Legohead259/Thetis-CAD/ECAD/Rev D1/Thetis_RevD1_BOM.pdf

Item | Manufactor Part Number Supplier Part Number | Reference Value | Package | Price | Qty Used Component Price Location Datasheet Notes
Micro button | KMR221GLFS | 401-1427-1-ND | SW1 | | SMD | $ 0.48 | 1 $ | 0.48 https://www.digikey.com/en/products/detail/c-k/KMR221GLFS/550472?s=N4IgTCBcDaINYFsBOYwEYDmAbAZgZxAF0BfIA https://www.ckswitches.com/media/1479/kmr2.pdf SPST-NO
Micro SD card receptacle DM3D-SF | HR1941CT-ND | J1 | SMD | $ 1.65 | 1 $ | 1.65 https://www.digikey.com/en/products/detail/hirose-electric-co-ltd/DM3D-SF/1786510 https://www.hirose.com/product/document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 CS is grounded
Micro USB receptacle | 10118192-0001LF | 609-4613-1-ND | J2 | | SMD | $ 0.42 | 1 $ | 0.42 https://www.digikey.com/product-detail/en/amphenol-icc-fci/10118192-0001LF/609-4613-1-ND/2785378 https://cdn.amphenol-icc.com/media/wysiwyg/files/documentation/datasheet/inputoutput/io_usb_micro.pdf
ESP8266 Module | ESP-12S | ESP-12SRF-ND | U1 | | SOM | $ 9.43 | 1 $ | 9.43 https://www.digikey.com/en/products/detail/rf-solutions/ESP-12S/9555694?s=N4IgTCBcDaIKYGcAOBGMBaBIC6BfIA https://www.rfsolutions.co.uk/downloads/1605713877DS-ESP12S-1.pdf Application note: run in STA mode to enable MODEM_SLEEP and conserve power
3V3 voltage regulator | AZ1117H-3.3TRE1 | AZ1117H-3.3TRE1DICT-ND | U2 | SOT-223 $ 0.46 | 1 $ | 0.46 https://www.digikey.com/en/products/detail/diodes-incorporated/AZ1117H-3-3TRE1/4471000 https://media.digikey.com/pdf/Data%20Sheets/Diodes%20PDFs/AZ1117_Rev5.3_Jan2019_DS.pdf 3.3V fixed output, 1A max
USB-UART Converter | CP2104-F03-GMR | 336-4146-1-ND | U3 | | 24QFN | $ 1.65 | 1 $ | 1.65 https://www.digikey.com/en/products/detail/silicon-labs/CP2104-F03-GMR/4069045 https://www.silabs.com/documents/public/data-sheets/cp2104.pdf
BNO055 Breakout | 2472 | 1528-1426-ND | U4 | | SMD | $ 19.95 | 1 $ | 19.95 https://www.adafruit.com/product/4646 https://learn.adafruit.com/adafruit-bno055-absolute-orientation-sensor Breakout board is THT but should be solderable to SMD pads
LIR2450 Battery Holder | BS-2450 | BS-2450-ND | BT1 | | THT | $ 1.09 | 1 $ | 1.09 https://www.digikey.com/en/products/detail/mpd-memory-protection-devices/BS-2450/2439475 http://www.memoryprotectiondevices.com/datasheets/BS-2450-datasheet.pdf Only use rechargable LIR2450 cells! Undervolt otherwise
N-Channel MOSFET | DMG3414U-7 | DMG3414U-7DICT-ND | Q1 | SOT-23-3 $ 0.44 | 1 $ | 0.44 https://www.digikey.com/en/products/detail/diodes-incorporated/DMG3414U-7/2183247 https://www.diodes.com/assets/Datasheets/ds31739.pdf
NPN transistor array | MBT2222ADW1T1G | MBT2222ADW1T1GOSCT-ND Q2, Q3, Q4 | SOT-363 $ 0.22 | 3 $ | 0.66 https://www.digikey.com/en/products/detail/on-semiconductor/MBT2222ADW1T1G/1477281 http://www.onsemi.com/pub/Collateral/MBT2222ADW1T1-D.PDF 2 NPN transistors
LED | SML-D12P8WT86C | SML-D12P8WT86CCT-ND | D1, D2, D3 GRN | 0603 | $ 0.48 | 3 $ | 1.44 https://www.digikey.com/product-detail/en/rohm-semiconductor/SML-D12P8WT86C/SML-D12P8WT86CCT-ND/9090464 https://www.rohm.com/datasheet/SML-D12P8W(C)/sml-d12x8(c)-e 2.2Vf
Schottky diode | BAT400D-7-F | BAT400D-FDICT-ND | D4 | SOT-23-3 $ 0.44 | 1 $ | 0.44 https://www.digikey.com/product-detail/en/diodes-incorporated/BAT400D-7-F/BAT400D-FDICT-ND/725055 https://www.diodes.com/assets/Datasheets/ds30182.pdf 40V, 500mA
Resistor | ESR03EZPJ102 | RHM1.0KDCT-ND | R2 | 1k | 0603 | $ 0.10 | 1 $ | 0.10 https://www.digikey.com/product-detail/en/rohm-semiconductor/ESR03EZPJ102/RHM1.0KDCT-ND/1762924 https://www.rohm.com/datasheet/ESR01MZPF/esr-e 0.25W
Resistor | RNCP0603FTD10K0 | RNCP0603FTD10K0CT-ND | R1, R3 | 10k | 0603 | $ 0.10 | 2 $ | 0.20 https://www.digikey.com/product-detail/en/stackpole-electronics-inc/RNCP0603FTD10K0/RNCP0603FTD10K0CT-ND/2240478 https://www.seielect.com/catalog/sei-rncp.pdf 0.125W
Resistor array | 741X083102JP | 741X083102JPCT-ND | RN2, RN3 1k | 0804 | $ 0.10 | 2 $ | 0.20 https://www.digikey.com/en/products/detail/cts-resistor-products/741X083102JP/1124443 https://www.ctscorp.com/wp-content/uploads/74x.pdf 4 resistors, 0.0625W
Resistor array | EXB-28V103JX | Y7103CT-ND | RN1, RN4 10k | 0804 | $ 0.10 | 2 $ | 0.20 https://www.digikey.com/product-detail/en/panasonic-electronic-components/EXB-28V103JX/Y7103CT-ND/256360 https://industrial.panasonic.com/cdbs/www-data/pdf/AOC0000/AOC0000C14.pdf 4 resistors, 0.0625W
Capacitor | 885012206026 | 732-7945-1-ND | C1, C2 | 1 uF | 0603 | $ 0.10 | 2 $ | 0.20 https://www.digikey.com/product-detail/en/wurth-electronics-inc/885012206026/732-7945-1-ND/5454572 10V X7R
Capacitor | ZRB18AR61E106ME01L | 490-10991-1-ND | C3, C4 | 10 uF | 0603 | $ 0.48 | 2 $ | 0.96 https://www.digikey.com/product-detail/en/murata-electronics-north-america/ZRB18AR61E106ME01L/490-10991-1-ND/5321192 https://search.murata.co.jp/Ceramy/image/img/A01X/G101/ENG/ZRB18AR61E106ME01-01.pdf 25V X5R
SD Card | | | | | | $ 4.00 | 1 $ | 4.00 https://www.amazon.com/10-PACK-SanDisk-SDSDQAB-008G-Packaging/dp/B00MHZ70KO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 8GB, sold in bulk pack of 10
PCB | | | | | | $ 0.40 | 1 $ | 0.40
Total | | | | | | | $ | 44.37
