Legohead259/Thetis-CAD/ECAD/Rev F1/Thetis_RevF1_BOM.pdf

Item | Manufactor Part Number | Supplier | Supplier Part Number | Reference | Value | Package | Price | Qty Used | Component Price | Location | Datasheet | Notes
Capacitor | 885012206026 | Digikey | 732-7945-1-ND | C1, C2, C7-C11 | 1 uF | 0603 | $ 0.10 | 7 $ | 0.70 https://www.digikey.com/product-detail/en/wurth-electronics-inc/885012206026/732-7945-1-ND/5454572 10V X7R
Capacitor | ZRB18AR61E106ME01L | Digikey | 490-10991-1-ND | C3-C5 | 10 uF | 0603 | $ 0.48 | 3 $ | 1.44 https://www.digikey.com/product-detail/en/murata-electronics-north-america/ZRB18AR61E106ME01L/490-10991-1-ND/5321192 https://search.murata.co.jp/Ceramy/image/img/A01X/G101/ENG/ZRB18AR61E106ME01-01.pdf 25V X5R
LED | SML-D12P8WT86C | Digikey | SML-D12P8WT86CCT-ND | D1, D2, D3, D8 | GRN | 0603 | $ 0.48 | 4 $ | 1.92 https://www.digikey.com/product-detail/en/rohm-semiconductor/SML-D12P8WT86C/SML-D12P8WT86CCT-ND/9090464 https://www.rohm.com/datasheet/SML-D12P8W(C)/sml-d12x8(c)-e 2.2Vf
Schottky diode | BAT400D-7-F | Digikey | BAT400D-FDICT-ND | D4 | SOT-23-3 | $ 0.44 | 1 $ | 0.44 https://www.digikey.com/product-detail/en/diodes-incorporated/BAT400D-7-F/BAT400D-FDICT-ND/725055 https://www.diodes.com/assets/Datasheets/ds30182.pdf 40V, 500mA
LED | ASMT-RA45-AP932 | Digikey | 516-3217-1-ND | D5 | AMBR | 0603 | $ 0.33 | 1 $ | 0.33 https://www.digikey.com/product-detail/en/broadcom-limited/ASMT-RA45-AP932/516-3217-1-ND/5277725 https://docs.broadcom.com/docs/AV02-0378EN 2Vf
LED | SML-D12U1WT86 | Digikey | SML-D12U1WT86CT-ND | D6, D7 | RED | 0603 | $ 0.20 | 2 $ | 0.40 https://www.digikey.com/product-detail/en/rohm-semiconductor/SML-D12U1WT86/SML-D12U1WT86CT-ND/5843858 https://www.rohm.com/datasheet/SML-D12U1W 2.2Vf
Micro SD card receptacle DM3AT-SF-PEJM5 | Digikey | HR1964CT-ND | J1 | SMD | $ 2.50 | 1 $ | 2.50 https://www.digikey.com/en/products/detail/hirose-electric-co-ltd/DM3AT-SF-PEJM5/2533565 https://www.hirose.com/product/document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 Push-Push with ejection mechanism
Micro USB receptacle | 10118192-0001LF | Digikey | 609-4613-1-ND | J2 | SMD | $ 0.42 | 1 $ | 0.42 https://www.digikey.com/product-detail/en/amphenol-icc-fci/10118192-0001LF/609-4613-1-ND/2785378 https://cdn.amphenol-icc.com/media/wysiwyg/files/documentation/datasheet/inputoutput/io_usb_micro.pdf
N-Channel MOSFET | DMG3414U-7 | Digikey | DMG3414U-7DICT-ND | Q1 | SOT-23-3 | $ 0.44 | 1 $ | 0.44 https://www.digikey.com/en/products/detail/diodes-incorporated/DMG3414U-7/2183247 https://www.diodes.com/assets/Datasheets/ds31739.pdf
NPN transistor array | MBT2222ADW1T1G | Digikey | MBT2222ADW1T1GOSCT-ND | Q2 | SOT-363 | $ 0.22 | 3 $ | 0.66 https://www.digikey.com/en/products/detail/on-semiconductor/MBT2222ADW1T1G/1477281 http://www.onsemi.com/pub/Collateral/MBT2222ADW1T1-D.PDF 2 NPN transistors
Resistor | RNCP0603FTD10K0 | Digikey | RNCP0603FTD10K0CT-ND | R1, R5-R10, R18, R19 | 10 kΩ | 0603 | $ 0.10 | 8 $ | 0.80 https://www.digikey.com/product-detail/en/stackpole-electronics-inc/RNCP0603FTD10K0/RNCP0603FTD10K0CT-ND/2240478 https://www.seielect.com/catalog/sei-rncp.pdf 0.125W
Resistor | ESR03EZPJ102 | Digikey | RHM1.0KDCT-ND | R2, R3, R4, R11, R12, R20, R21 1 kΩ | 0603 | $ 0.10 | 7 $ | 0.70 https://www.digikey.com/product-detail/en/rohm-semiconductor/ESR03EZPJ102/RHM1.0KDCT-ND/1762924 https://www.rohm.com/datasheet/ESR01MZPF/esr-e 0.25W
Resistor | CRCW060322K1FKEAC | Digikey | 541-5271-1-ND | R26 | 22.1 kΩ 0603 | $ 0.10 | 1 $ | 0.10 https://www.digikey.com/en/products/detail/vishay-dale/CRCW060322K1FKEAC/7924045 https://www.vishay.com/docs/28773/crcwce3.pdf 0.1W; 1%
Resistor | RT0603DRE0747K5L | Digikey | RT0603DRE0747K5L | R27 | 47.5 kΩ 0603 | $ 0.10 | 1 $ | 0.10 https://www.digikey.com/en/products/detail/yageo/RT0603DRE0747K5L/1074875 https://www.yageo.com/upload/media/product/productsearch/datasheet/rchip/PYu-RT_1-to-0.01_RoHS_L_12.pdf 0.1W; 0.5%
Micro button | KMR221GLFS | Digikey | 401-1427-1-ND | S1, S2, S4 | SMD | $ 0.48 | 3 $ | 1.44 https://www.digikey.com/en/products/detail/c-k/KMR221GLFS/550472?s=N4IgTCBcDaINYFsBOYwEYDmAbAZgZxAF0BfIA https://www.ckswitches.com/media/1479/kmr2.pdf SPST-NO
Slide switch | JS202011JCQN | Digikey | S3 | SMD | $ 0.55 | 1 $ | 0.55 | DPDT
ESP32-WROOM Module ESP32-WROOM-32E (16MB) Digikey | 1965-ESP32-WROOM-32E(16MB)CT-ND U1 | 38-SMD | $ 2.99 | 1 $ | 2.99 https://www.digikey.com/en/products/detail/espressif-systems/ESP32-WROOM-32E-16MB/11613144 https://www.espressif.com/sites/default/files/documentation/esp32-wroom-32e_esp32-wroom-32ue_datasheet_en.pdf 16 MB memory, could be used as alternate filesystem
3V3 voltage regulator | AZ1117H-3.3TRE1 | Digikey | AZ1117H-3.3TRE1DICT-ND | U2 | SOT-223 | $ 0.46 | 1 $ | 0.46 https://www.digikey.com/en/products/detail/diodes-incorporated/AZ1117H-3-3TRE1/4471000 https://media.digikey.com/pdf/Data%20Sheets/Diodes%20PDFs/AZ1117_Rev5.3_Jan2019_DS.pdf 3.3V fixed output, 1A max
USB-UART Bridge | CP2102N-A02-GQFN24R | Digikey | 336-5888-1-ND | U3 | 24 QFN | $ 1.35 | 1 $ | 1.35 https://www.digikey.com/en/products/detail/silicon-labs/CP2102N-A02-GQFN24R/9863479 https://www.silabs.com/documents/public/data-sheets/cp2102n-datasheet.pdf USB2.0; uART up to 3Mb baud rate
BNO055 Breakout | 2472 | Digikey | 1528-1426-ND | U4 | SMD | $ 19.95 | 1 $ | 19.95 https://www.adafruit.com/product/4646 https://learn.adafruit.com/adafruit-bno055-absolute-orientation-sensor Breakout board is THT but solderable to SMD pads
LiPoly Battery Charger | MCP73831T-2ACI/OT | Digikey | MCP73831T-2ACI/OTCT-ND | U5 | SOT-23-5 | $ 0.56 | 1 $ | 0.56 https://www.digikey.com/en/products/detail/microchip-technology/MCP73831T-2ACI-OT/964301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 http://www.microchip.com/mymicrochip/filehandler.aspx?ddocname=en025112 Used in all Adafruit LiPoly charging circuits
GPS radio | FGPMMOPA6H | Adafruit | 790 | U6 | 20-SMD | $ 29.95 | 1 $ | 29.95 https://www.adafruit.com/product/790 https://cdn-shop.adafruit.com/datasheets/GlobalTop-FGPMMOPA6H-Datasheet-V0A.pdf 10Hz refresh rate
SD Card | Amazon | $ 4.00 | 1 $ | 4.00 https://www.amazon.com/10-PACK-SanDisk-SDSDQAB-008G-Packaging/dp/B00MHZ70KO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 8GB, sold in bulk pack of 10
PCB | JLCPCB | $ 0.40 | 1 $ | 0.40 | Sold in packs of 5 @ $2.00; Black solder mask?
Total | $ | 72.60
