Legohead259/Thetis-CAD/MCAD/Print Files/EnclosureTest.stl

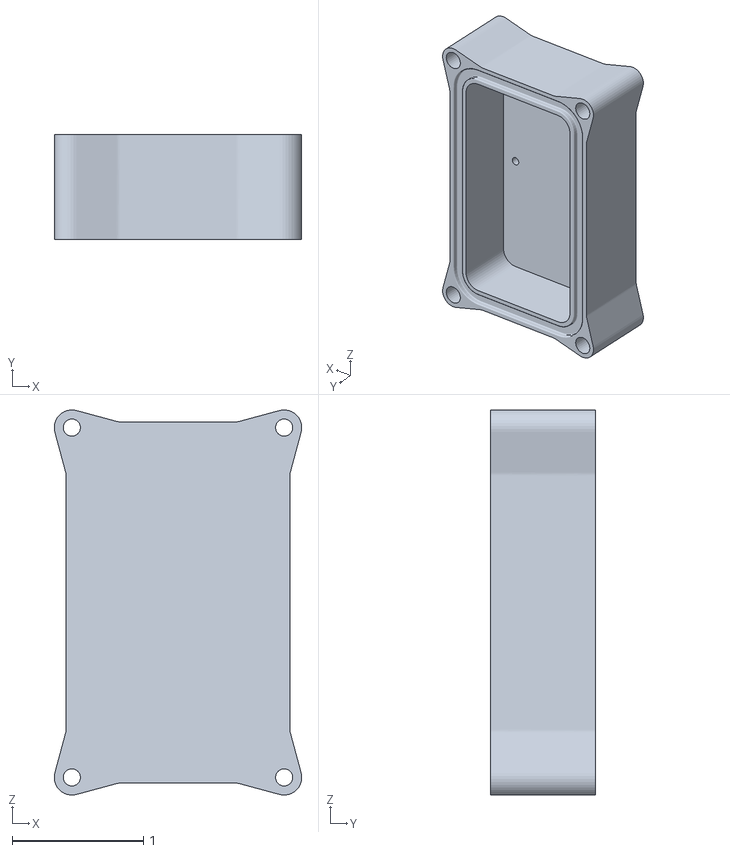
[picture p1: CAD file, 2022-02-04]
MCAD/Print Files/EnclosureTest.stl
1.89 x 0.8 x 2.94
