Legohead259/Thetis-CAD/(threads)

Thread 1 (2022-07-14):

Hardware Revision F5 Proposed Changelog

Legohead259, 2022-07-14:
Changes that need to be made to the Revision F5 of the Thetis instrumentation package
- [x] Add magnetometer ([LIS3MDL](https://www.digikey.com/en/products/detail/stmicroelectronics/LIS3MDLTR/4309733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))
- [x] Move the SD_CS line to a different pin
- [x] Connect the log enable button to the microcontroller
- [x] Make NeoPixel current-limiting resistor larger (1-2k)
- [x] Change SD card slot to [DM3D](https://www.digikey.com/en/products/detail/hirose-electric-co-ltd/DM3D-SF/1786510)
- [x] Switch the microcontroller to the [ESP32-S2-SOLO-U](https://www.digikey.com/en/products/detail/espressif-systems/ESP32-S2-SOLO-U-N4/15222549)
- [x] Add test pads for RST, LOG_EN, BOOT
- [x] Remove XTSD IC
- [x] Move silkscreen to `tPlace` layer for rendering on the 3D model

Closed 2023-01-13.

Thread 2 (2022-08-02):

Hardware Revision G1 Proposed Changelog

Legohead259, 2022-08-02:
Proposed changes from Rev F4
- [x] Add SMA connector for GPS antenna
- [x] Add SMA connector for WiFi antenna
- [x] Make PCB fit into [Hammond 1554 enclosure](https://www.digikey.com/en/products/detail/hammond-manufacturing/1554C2GYCL/2359954)
- [x] Add CANbus interfaces
    - [x] TWAI controller from ESP32-S2
    - [x] Backup MCP2515 controller
    - [x] DIP switch for dual or redundant CAN modes
    - [x] DIP switch to enable termination for CAN0 and CAN1
- [x] External JST connectors for M12 bulkhead connectors
    - [x] CAN (x2)
    - [x] USB
    - [x] UART
- [x] Primary power from M12 connectors (12-24V)
    - [x] DIP switch to enable/disable external power
    - [x] Convert to 5V to integrate with USB power input

Legohead259, 2022-10-27:
Completed

Closed 2022-10-27.

Thread 3 (2022-08-02):

Clean Up and Better Document This repo

Legohead259, 2022-08-02:
Need to clean this up and make it a bit easier to use
- [ ] Publish official versions as releases (Schematic and PCB source, Schematic PDF, Gerber files zip, related docs)
     - [ ] Rev F1
     - [ ] Rev F2
     - [ ] Rev F3
     - [ ] Rev F4
- [ ] Make milestones
     - [ ] Rev F5
     - [ ] Rev G1
- [ ] Make branches
     - [ ] Rev F5
     - [ ] Rev G1
- [ ] Make Issue Templates
     - [ ] Bug
     - [ ] Feature Tracking

Thread 4 (2022-10-26):

Diode D4 burns up when powered on

Legohead259, 2022-10-26:
Diode D4 burns up whenever USB power is connected and the switch is turned to "On". The component gets extremely hot suggesting a short between the USB power rail and ground. However, on inspection, there is a 100k resistance between USB power and GND - as expected. Perhaps the MOSFETS are shorting or doing something else?

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

Legohead259, 2022-10-26:
When MOSFET Q2 is removed, the issue disappears. This suggests a short through the 3V3 regulator. This design is using a new regulator - perhaps it is bad?

Legohead259, 2022-10-26:
Replaced 3V3 regulator and MOSFET Q2, issue still exists. Have verified all part numbers on assembled board.

Legohead259, 2022-10-26:
ISSUE FOUND! There exists a short between the 3V3 output and GND. Tracked down the short to the THT pins on the USB-C connector and GND as well as some of the external connectors.

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

The teal copper layer is the 3V3 plane on the board. Purple is the GND plane. The THT components do not have a proper keepout zone around them for these internal planes and thus, the copper is allowed to extend into the plated areas of these holes, creating a short. Thanks to Andrew Loomis for the helpful insight!

Will be fixed in Rev G2

Closed 2022-10-26.

Thread 6 (2022-10-27):

Hardware Revision G2 Proposed Changelog

Legohead259, 2022-10-27:
Proposed changes from Rev G1
- [x] Remove 3V3 and GND plane material from THT connectors
- [x] Clean up schematic
- [x] Move silkscreen to `tPlace` layer on board file

Closed 2023-01-13.
