Legohead259/Thetis-CAD/Documentation/Schematics/Thetis_RevD1_SCH.pdf

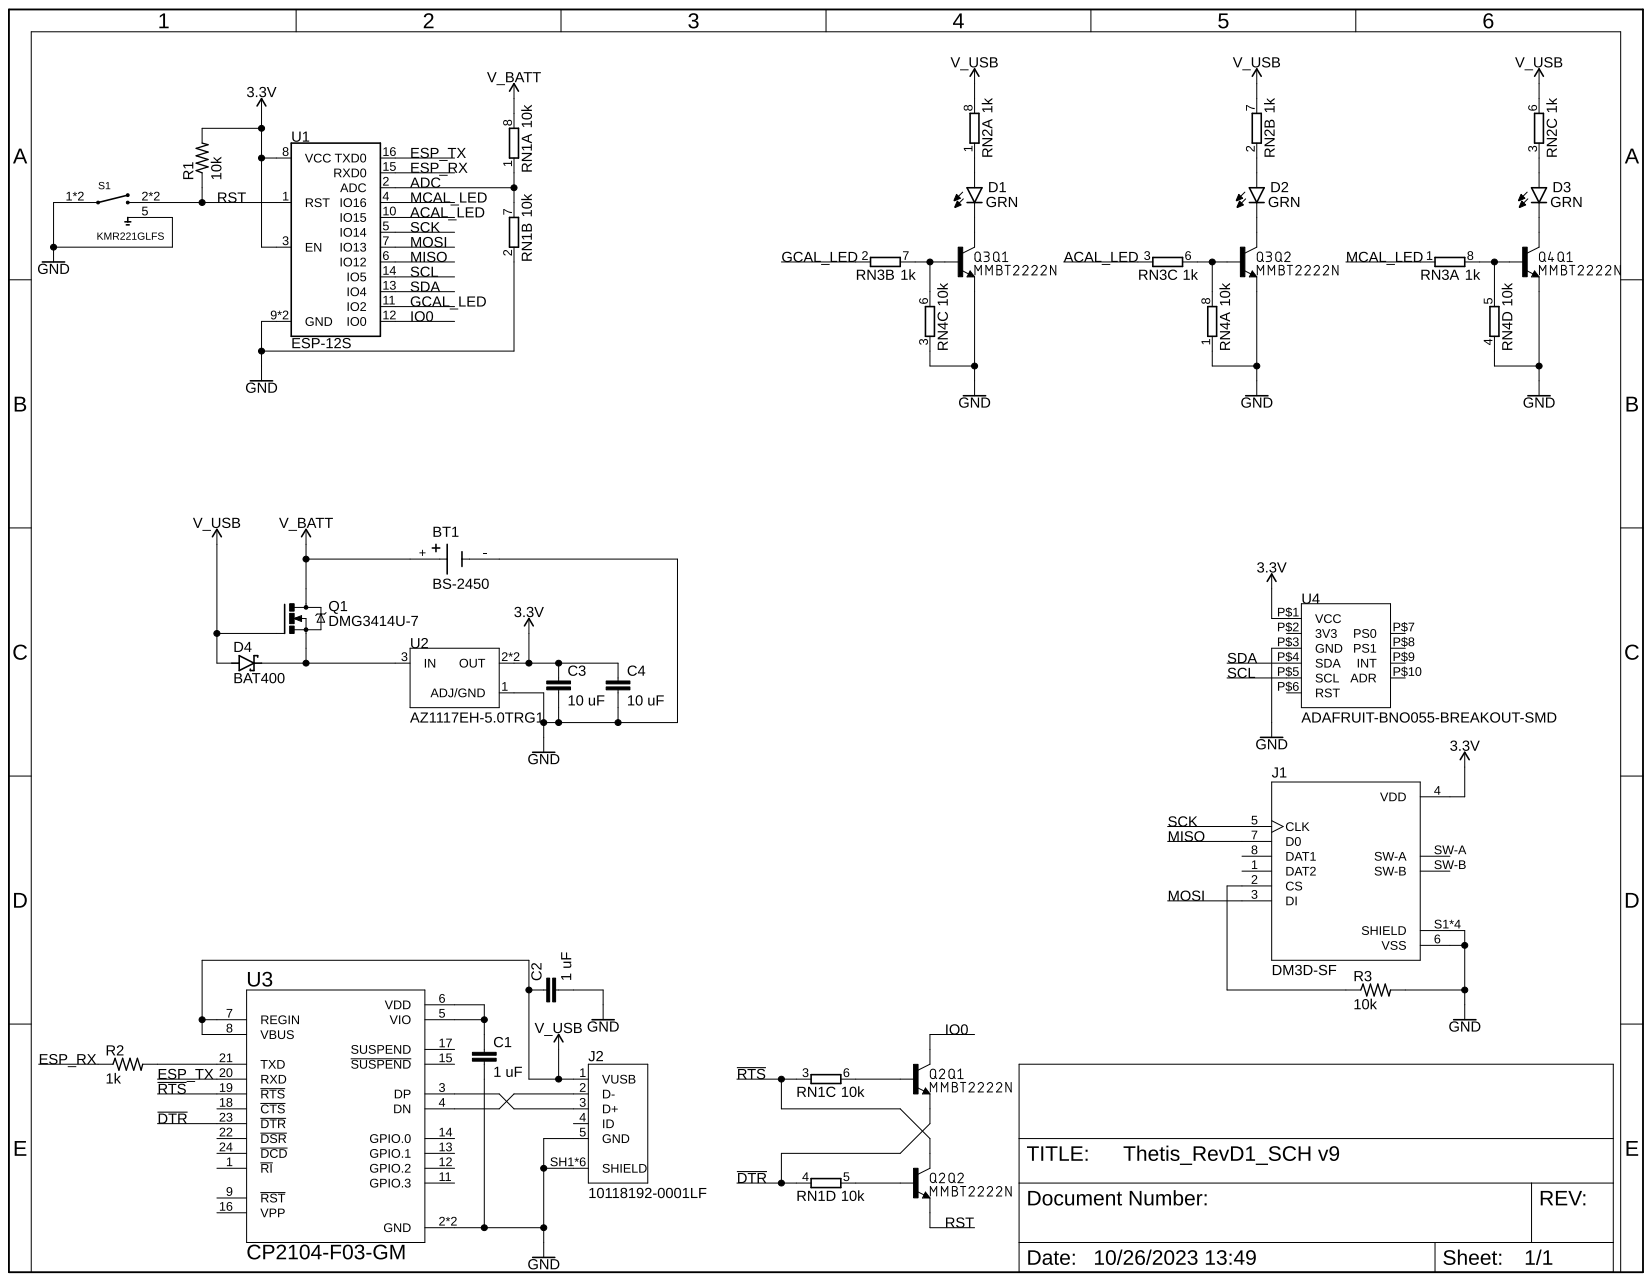
[picture p2: page 1]
