Legohead259/Thetis-CAD/Documentation/Schematics/Thetis_RevD2_SCH.pdf

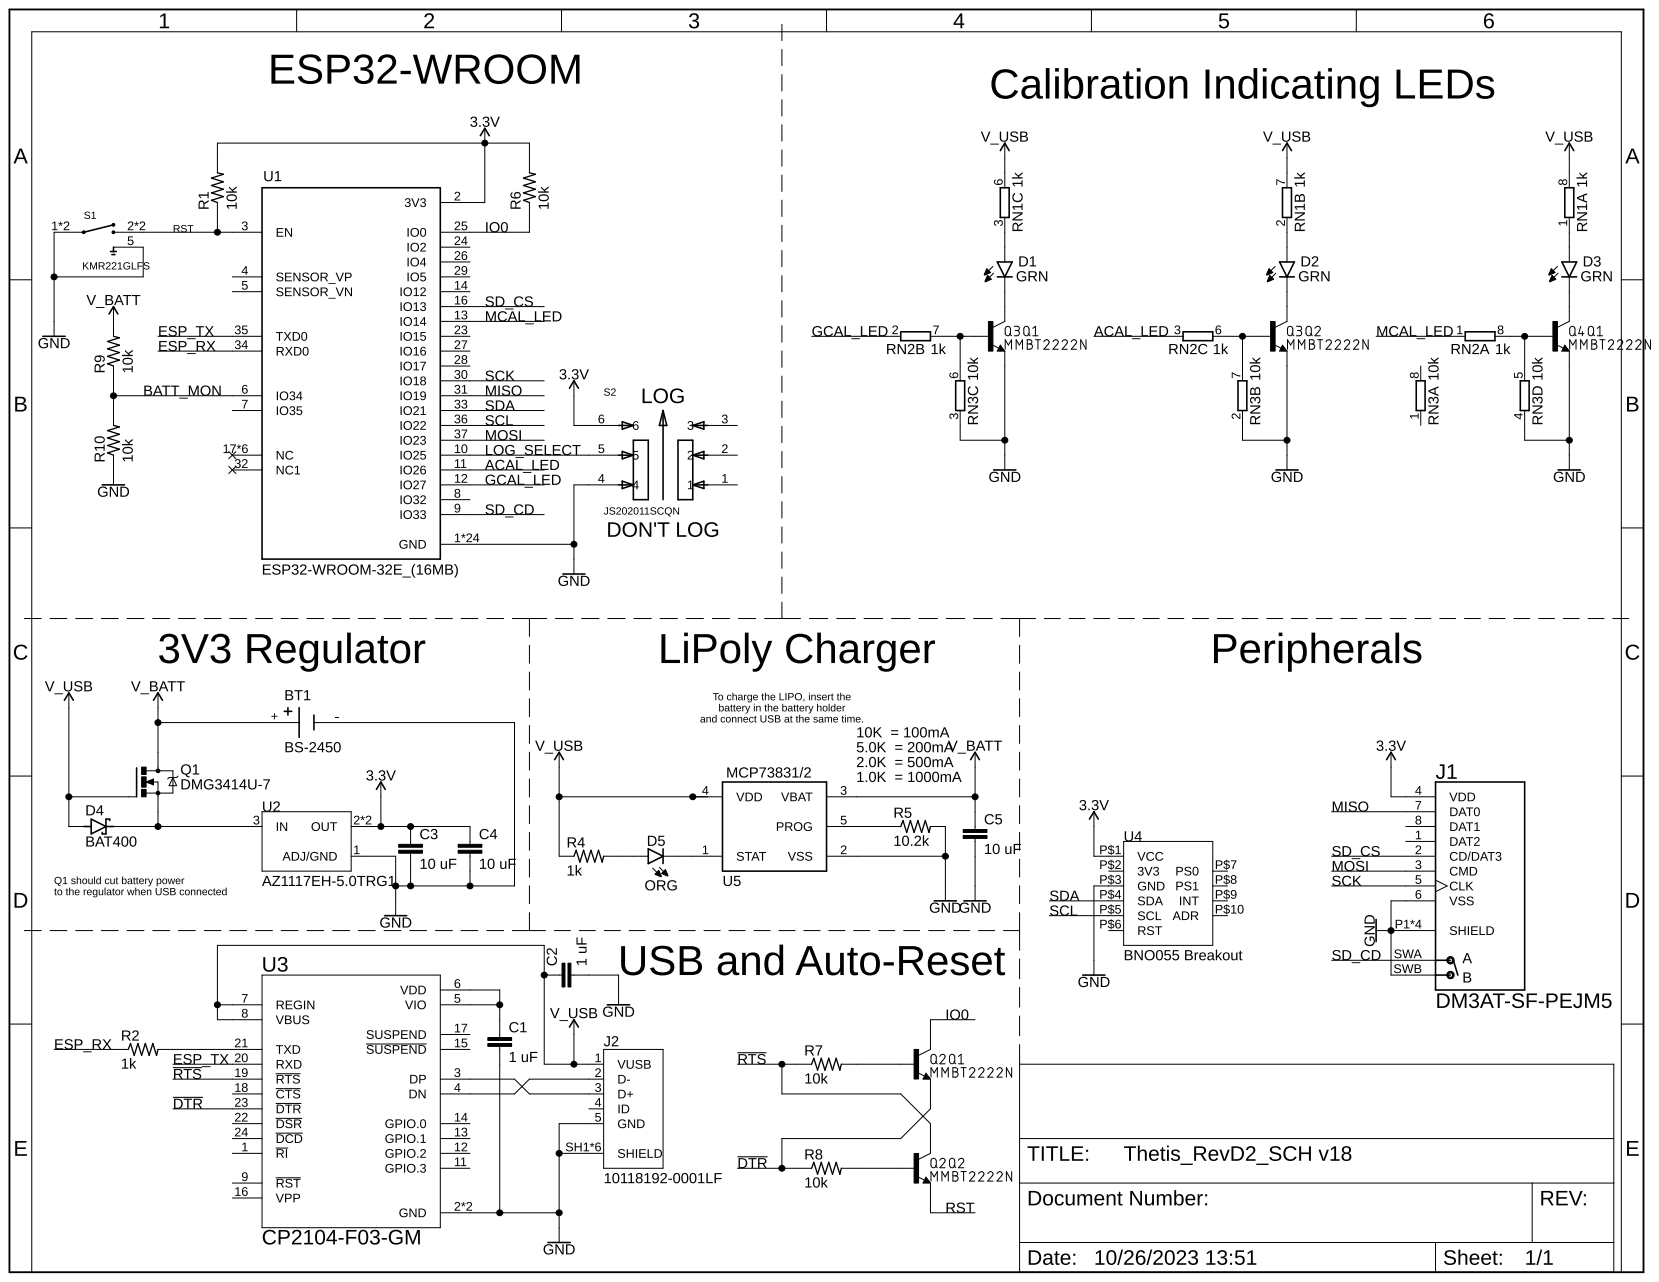
[picture p3: page 1]
