Legohead259/Thetis-CAD/Documentation/Schematics/Thetis_RevE1_SCH.pdf

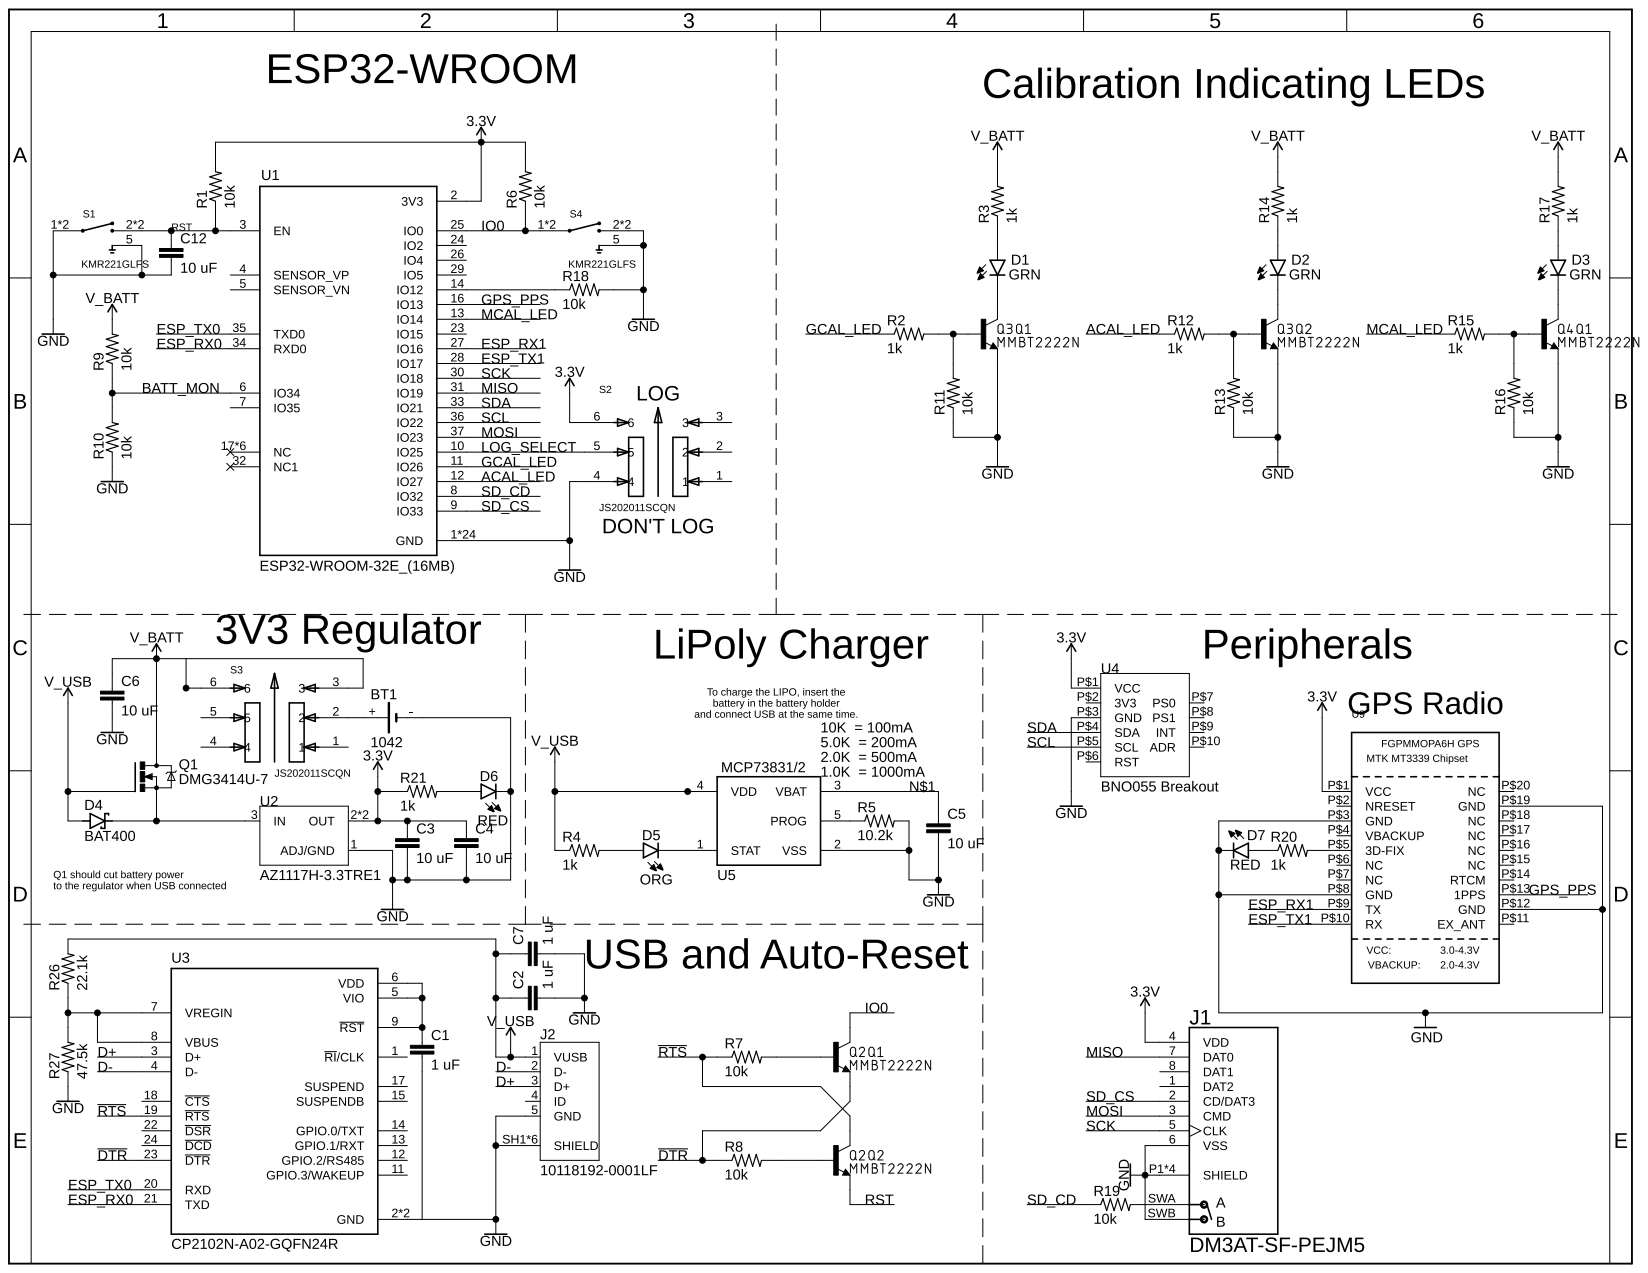
[picture p4: page 1]
