Legohead259/Thetis-CAD/Documentation/Schematics/Thetis_RevF1_SCH.pdf

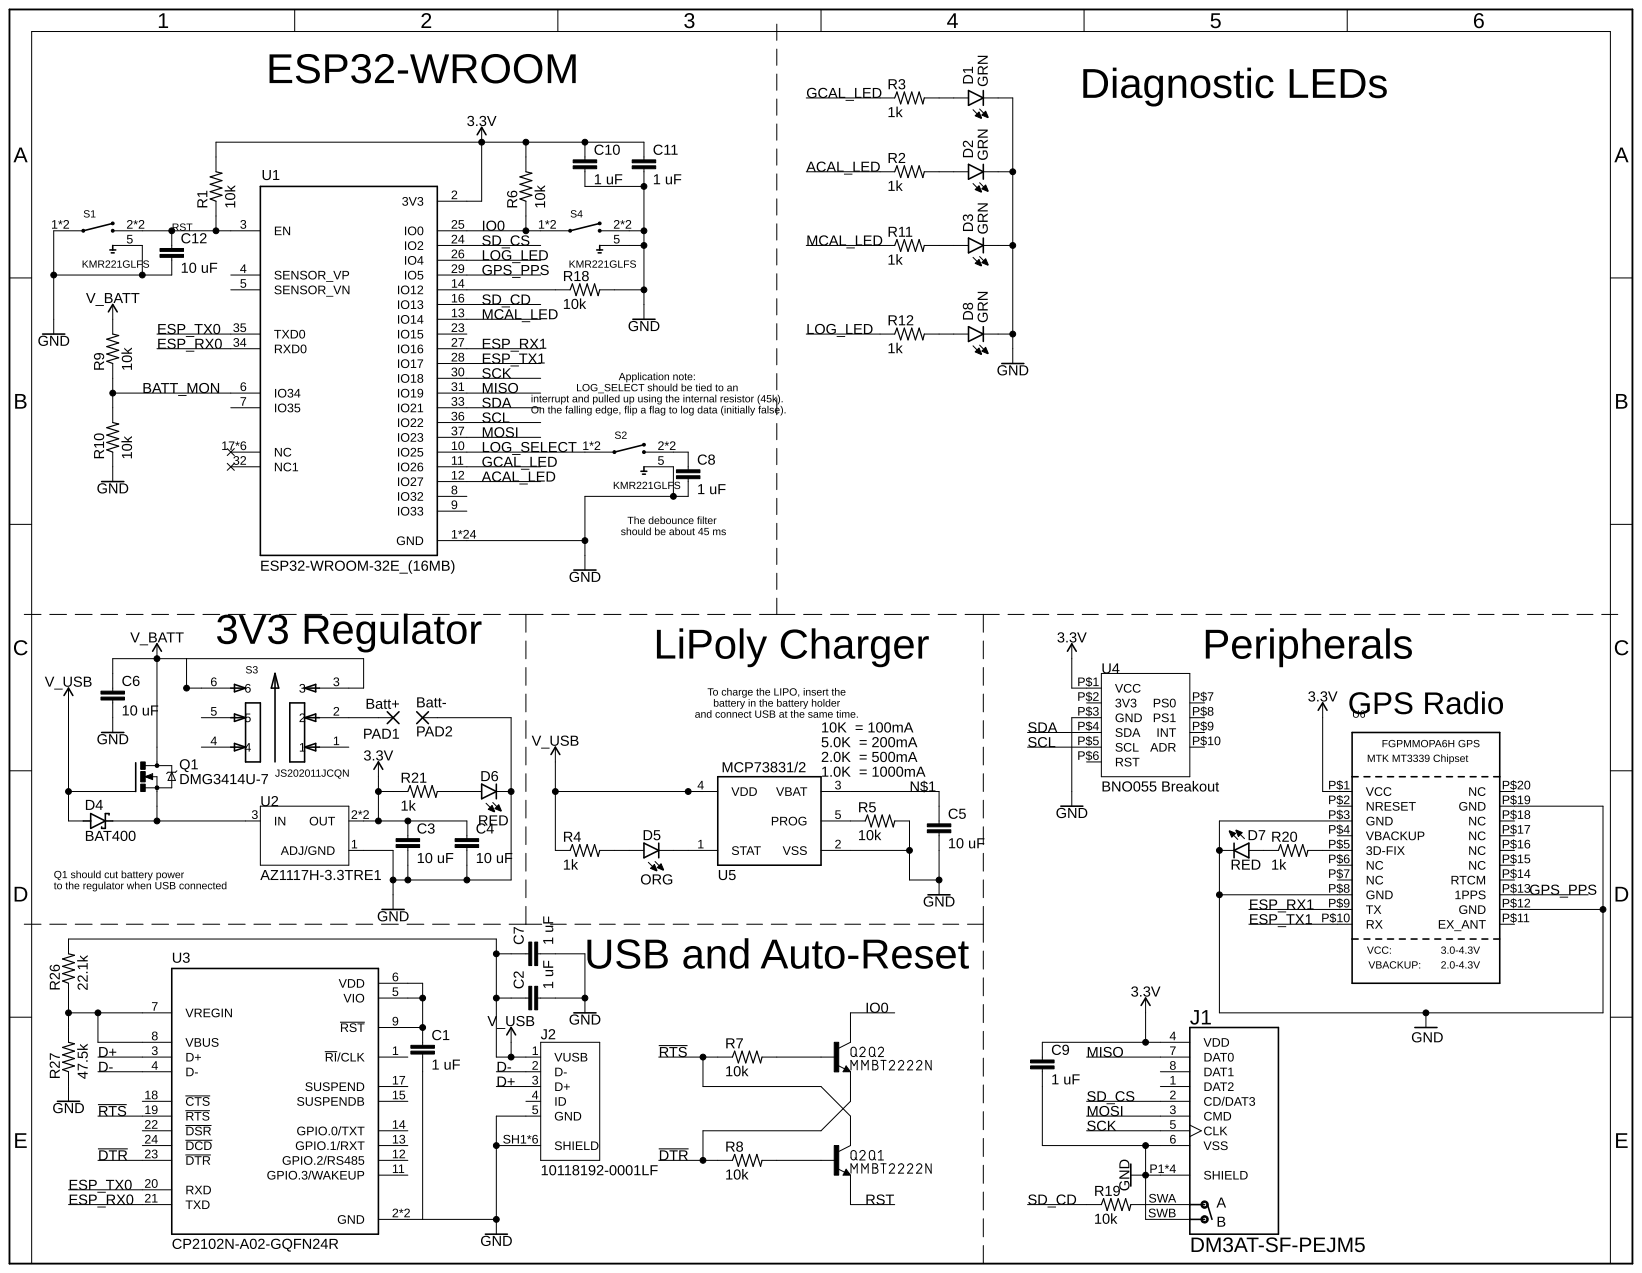
[picture p5: page 1]
