Legohead259/Thetis-CAD/Documentation/Schematics/Thetis_RevF2_SCH.pdf

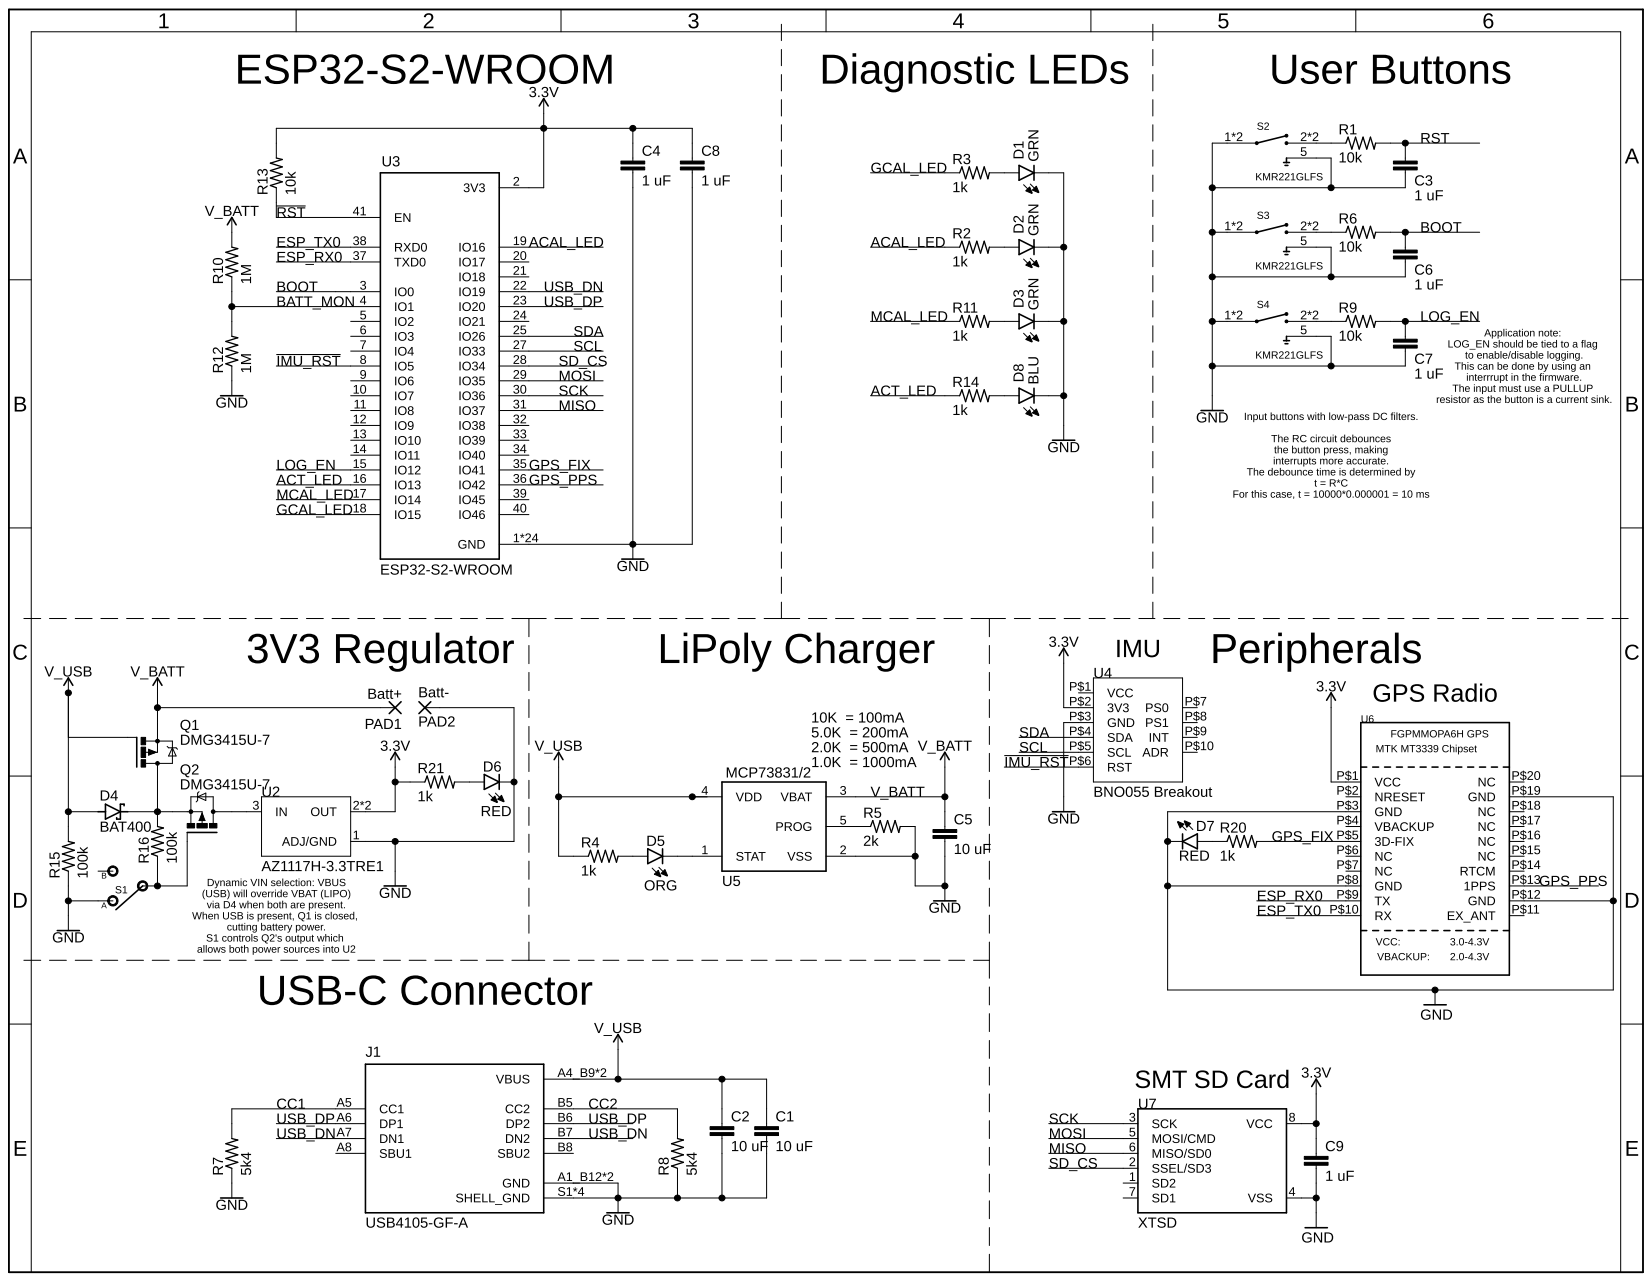
[picture p6: page 1]
