Legohead259/Thetis-CAD/Documentation/Schematics/Thetis_RevF3_SCH.pdf

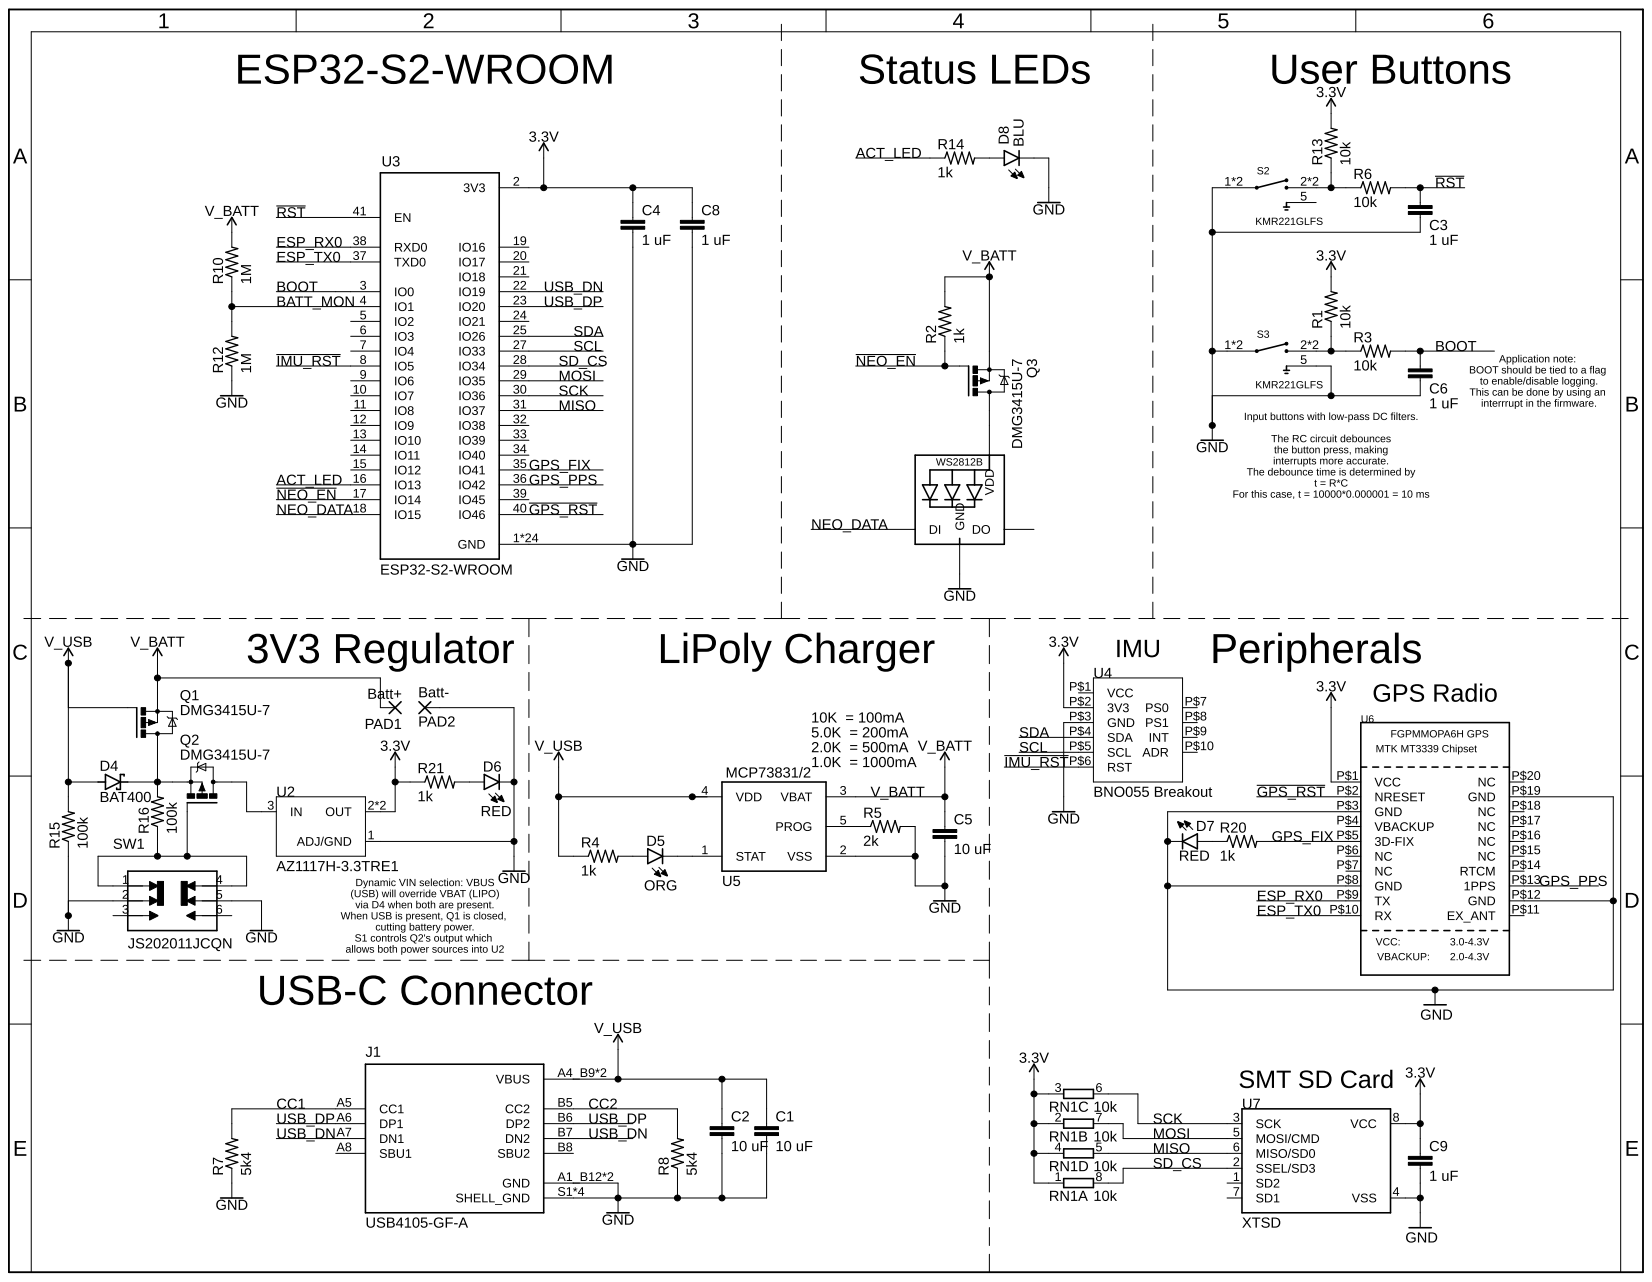
[picture p7: page 1]
