Legohead259/Thetis-CAD/Documentation/Schematics/Thetis_RevF4_SCH.pdf

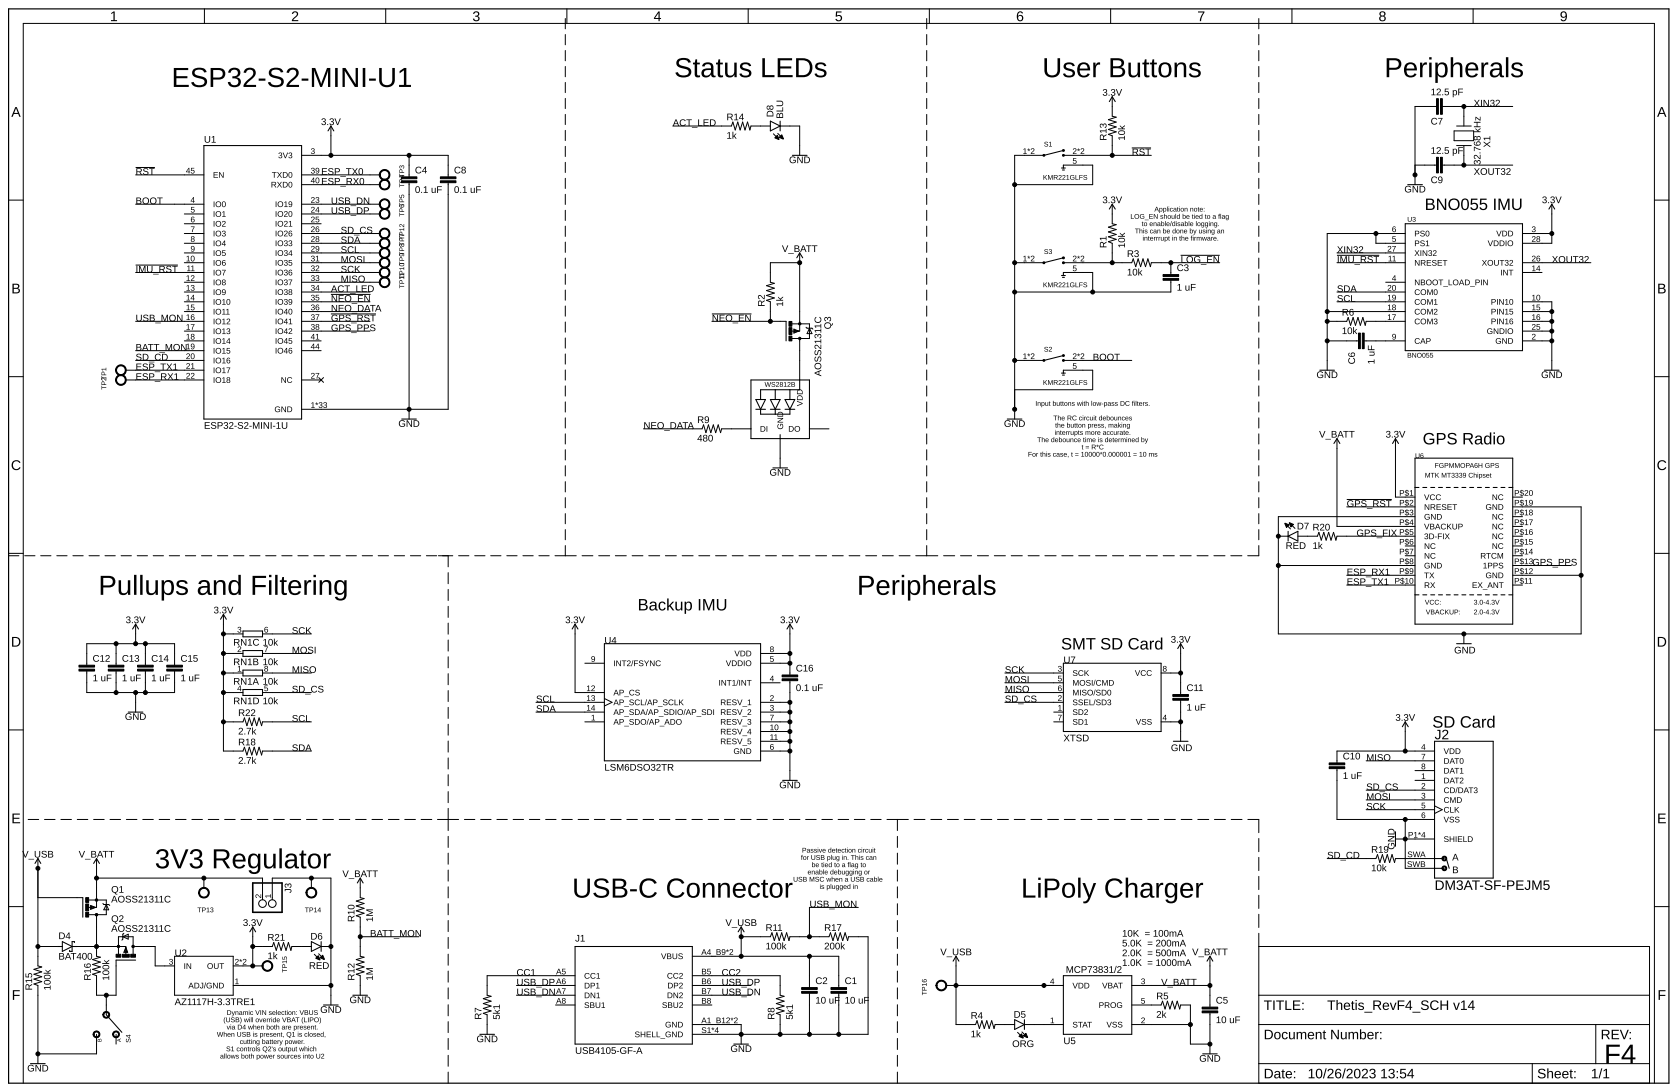
[picture p8: page 1]
