Legohead259/Thetis-CAD/Documentation/Schematics/Thetis_RevF5_SCH.pdf

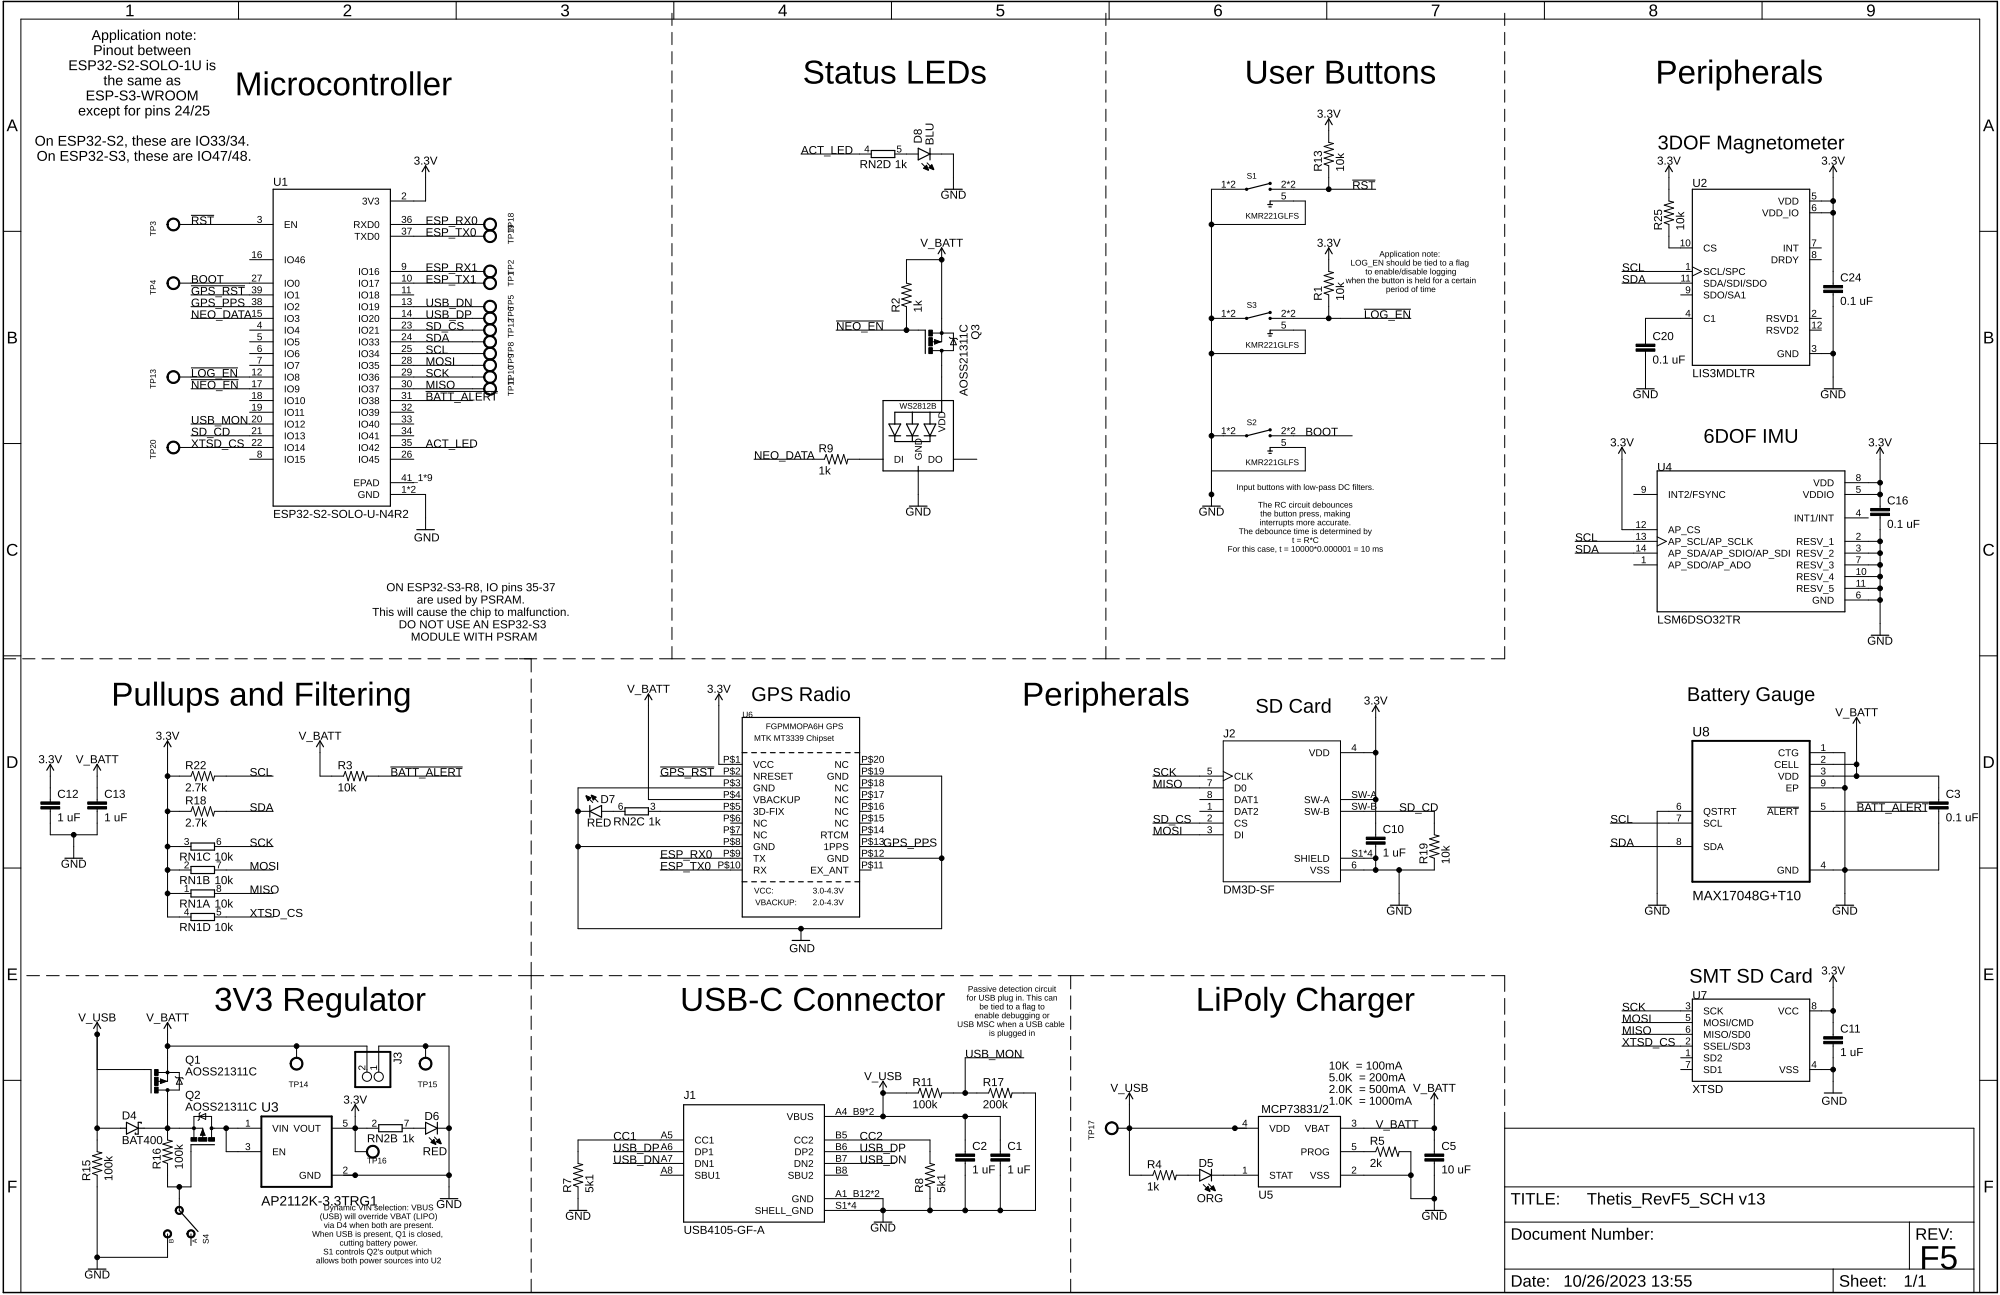
[picture p9: page 1]
