Legohead259/Thetis-CAD/Documentation/Schematics/Thetis_RevF6_SCH.pdf

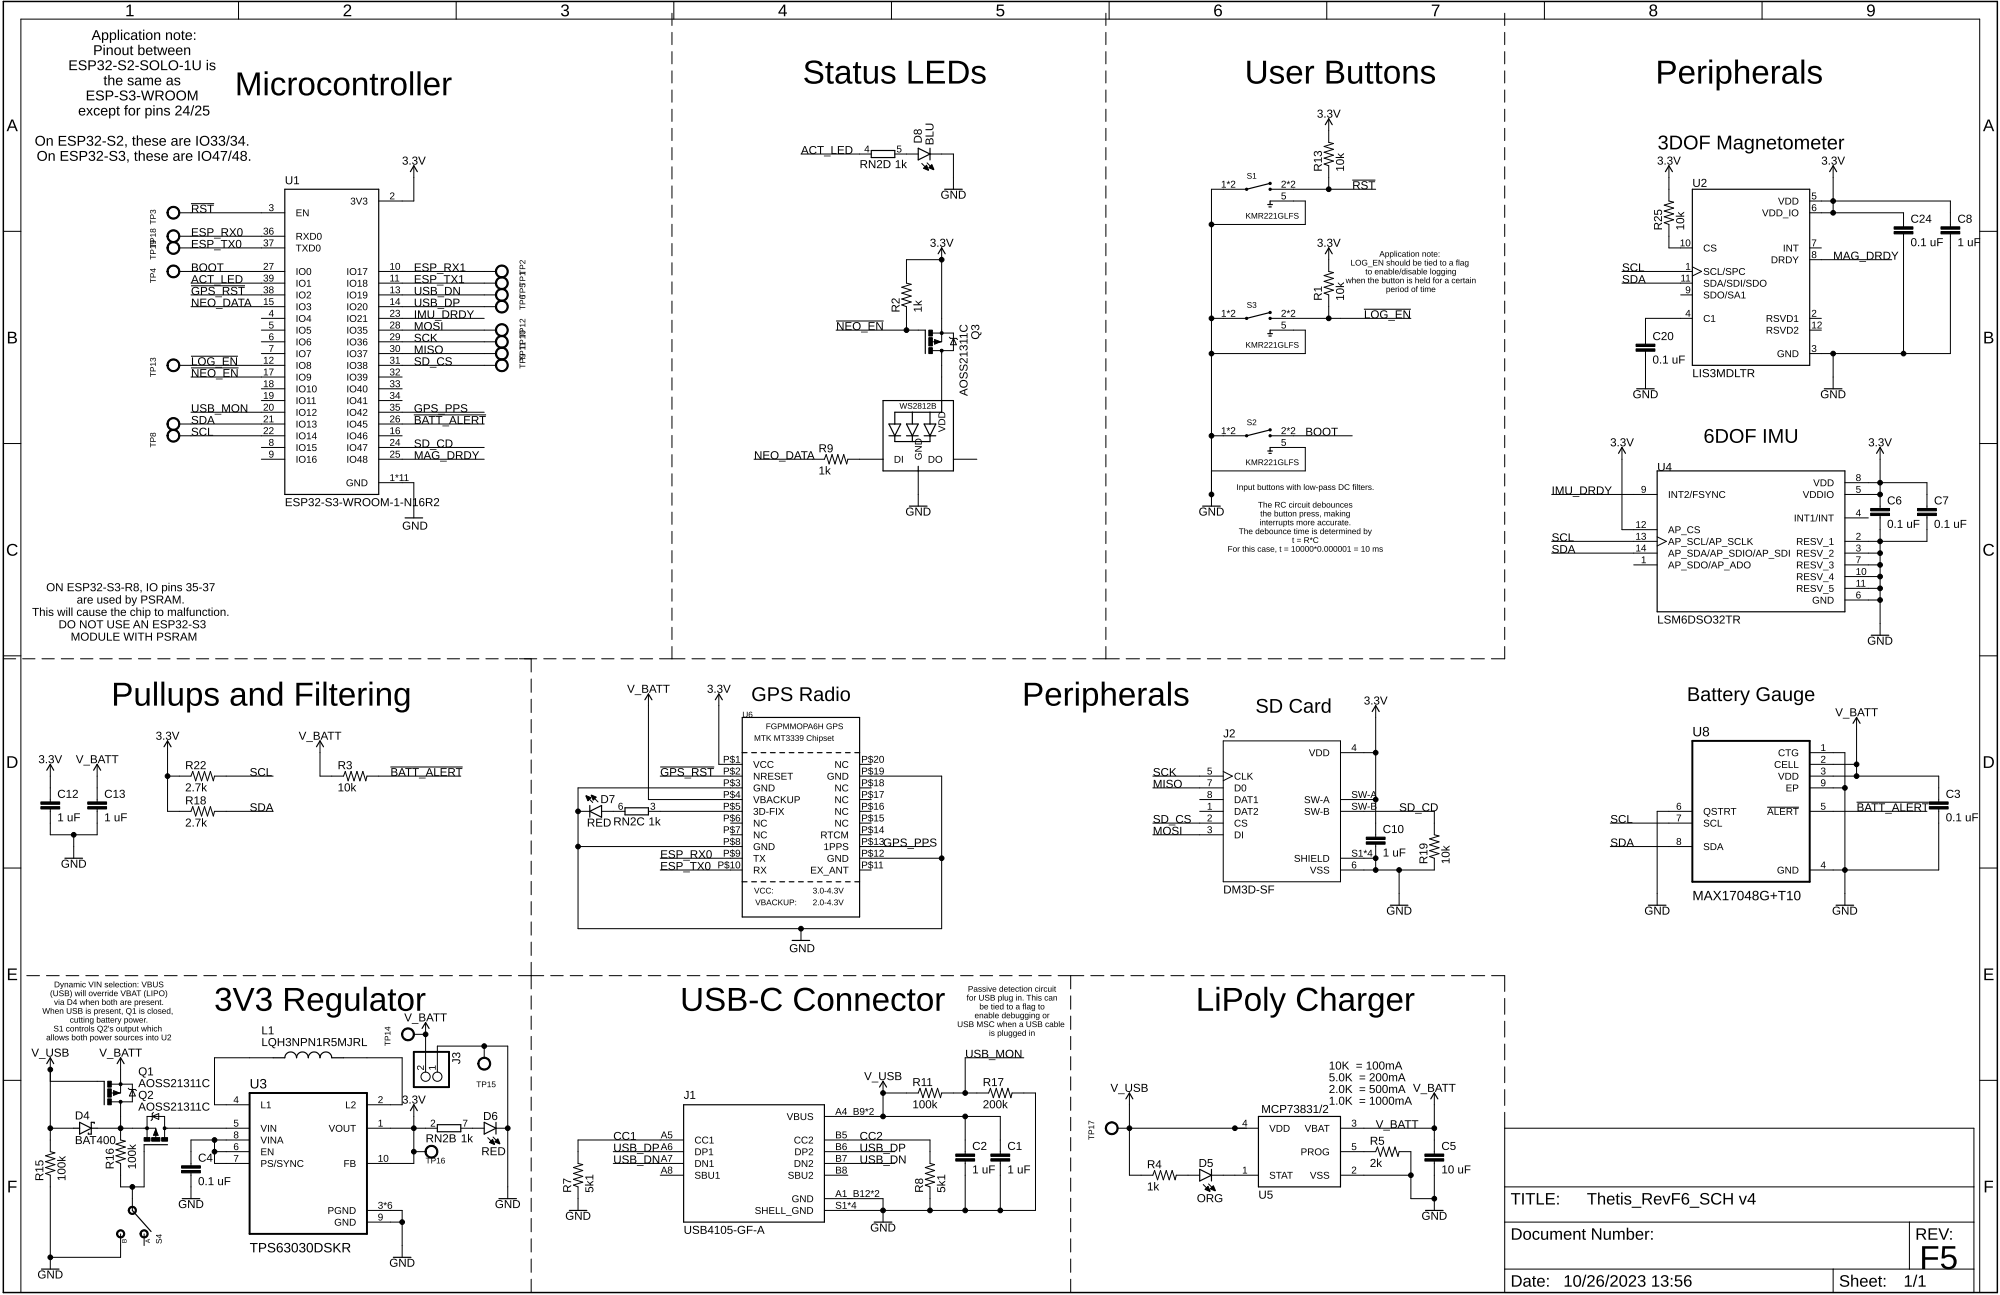
[picture p10: page 1]
