Legohead259/Thetis-CAD/Documentation/Schematics/Thetis_RevG1_SCH.pdf

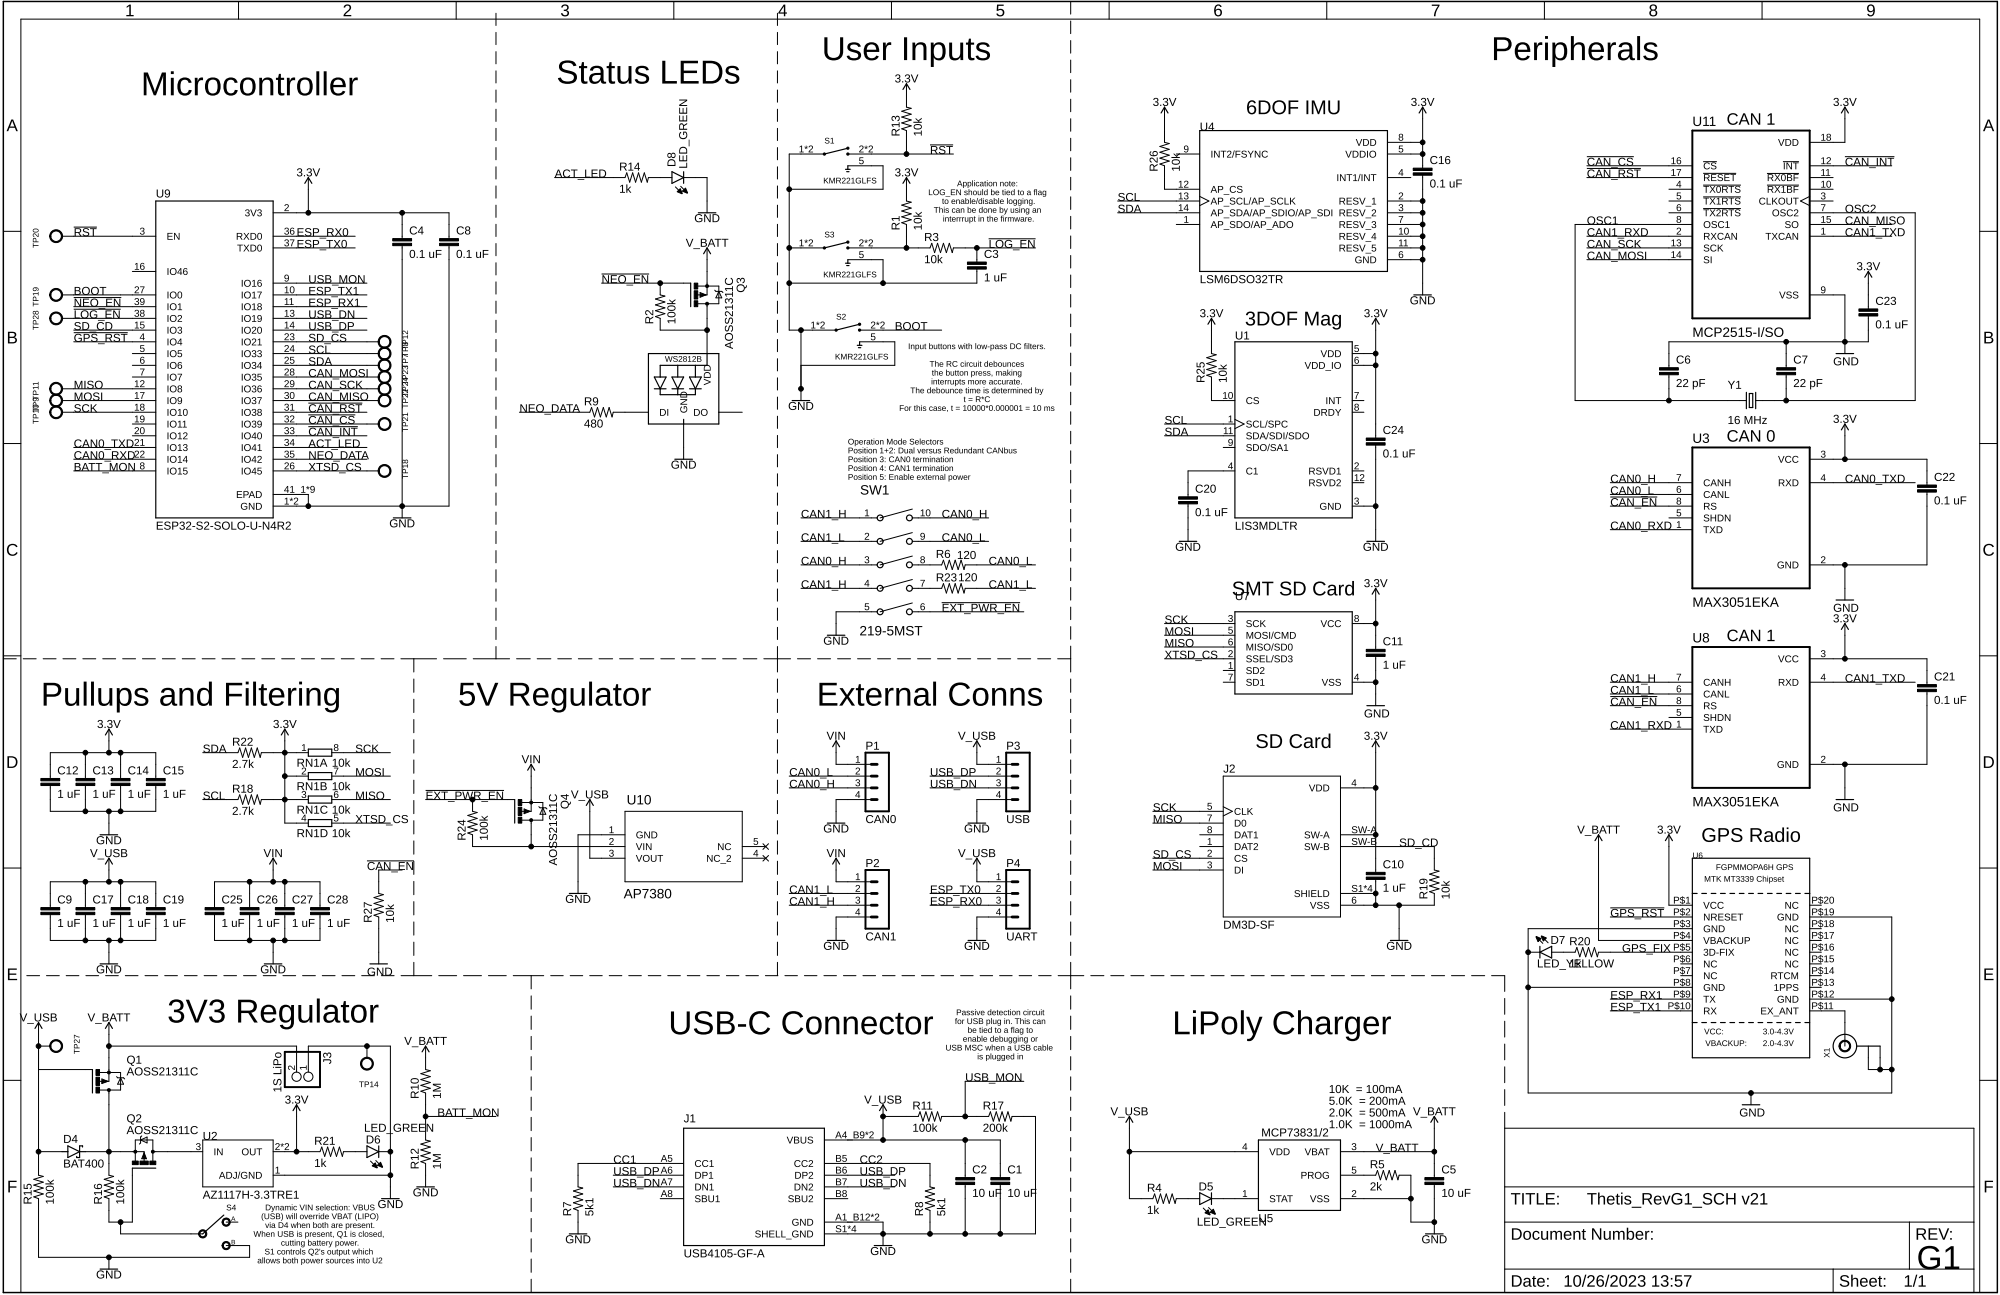
[picture p11: page 1]
