Legohead259/Thetis-CAD/Documentation/Schematics/Thetis_RevG2_SCH.pdf

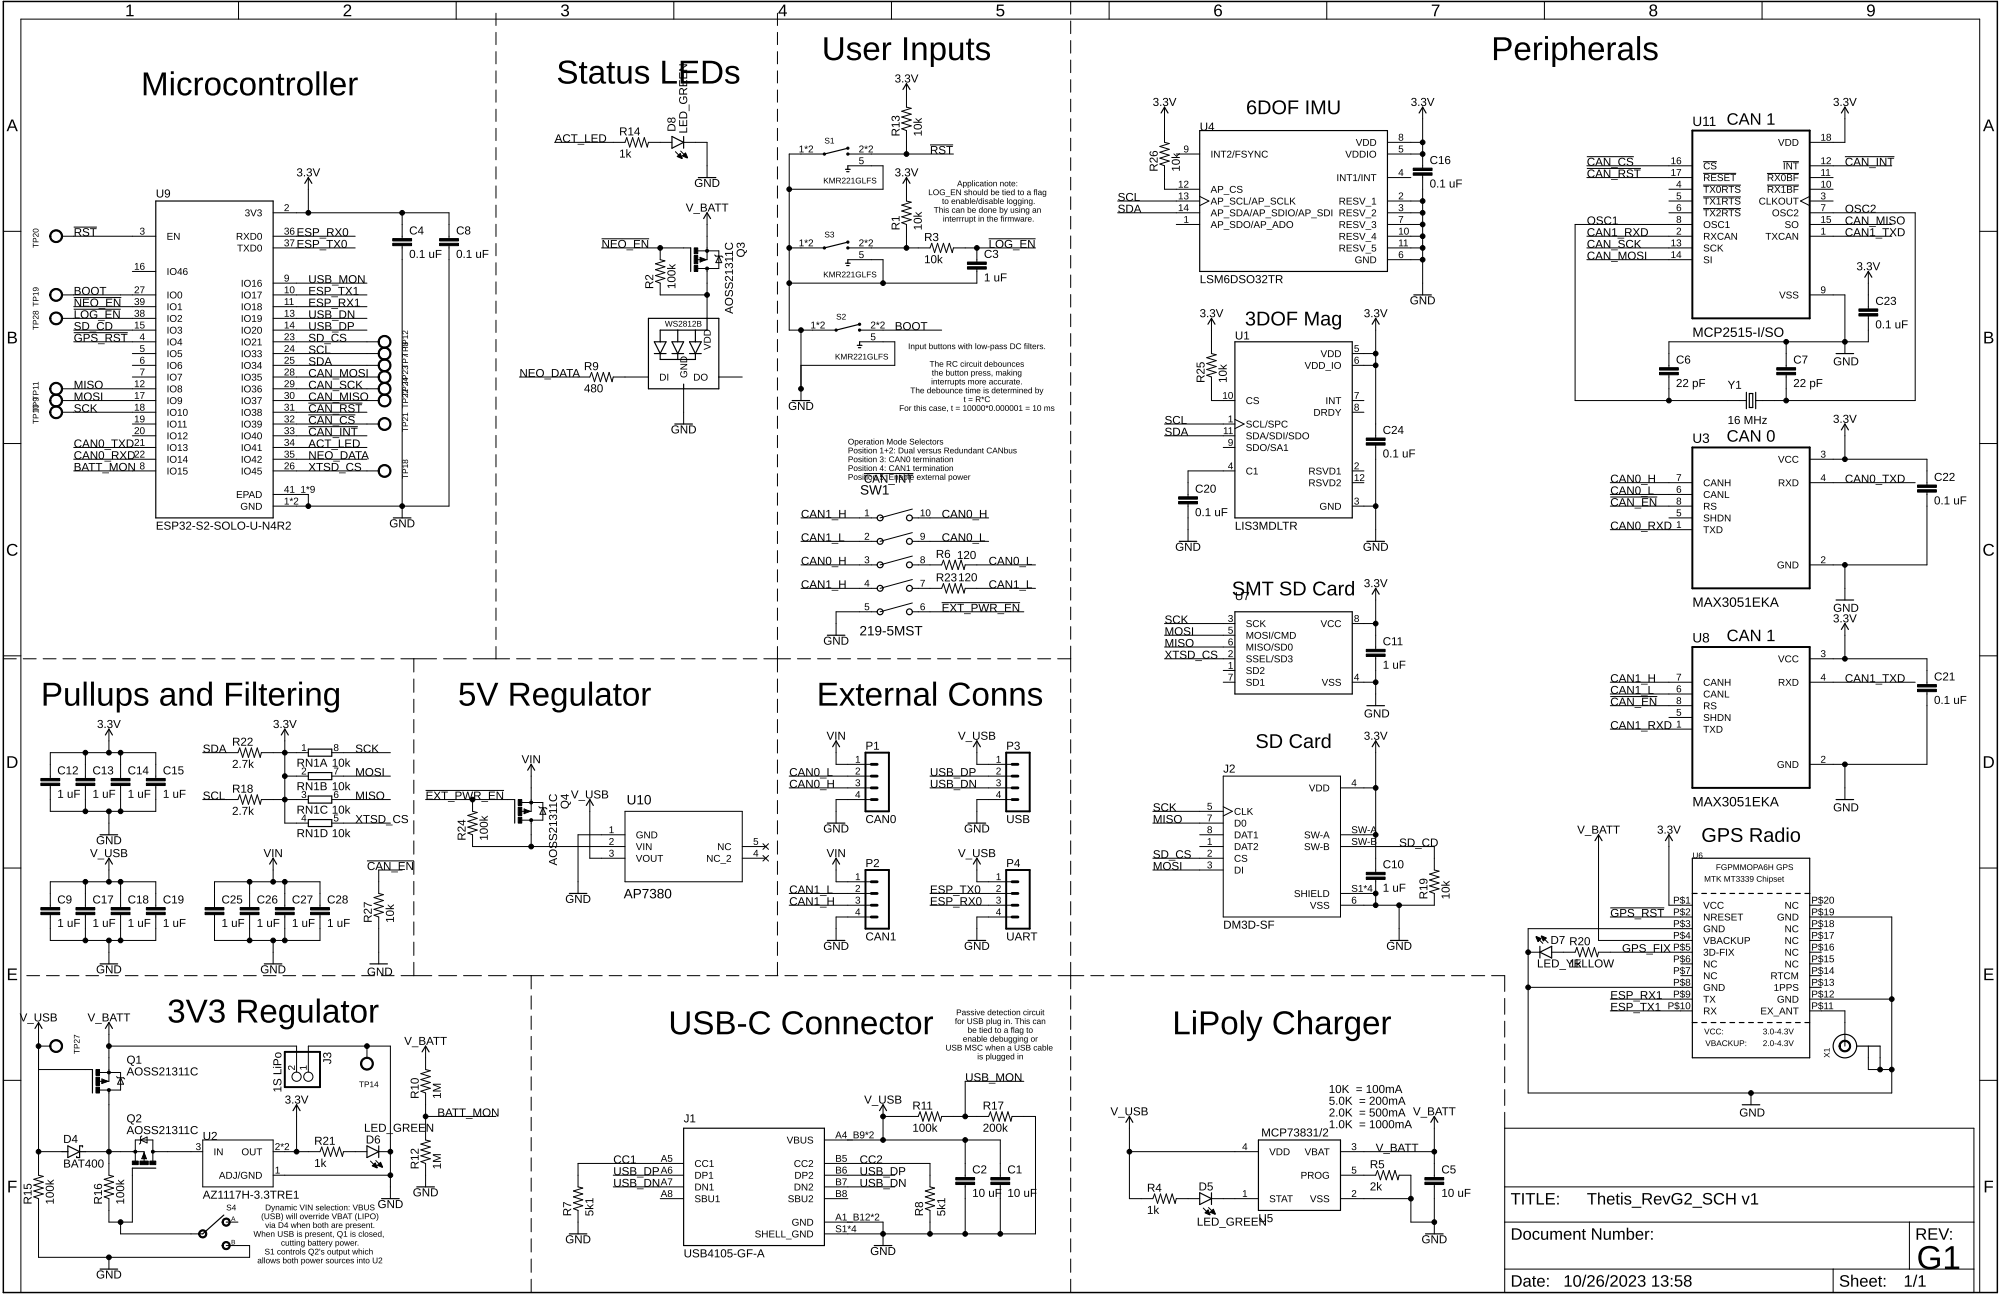
[picture p12: page 1]
