Legohead259/Thetis-CAD/ECAD/Rev G2/Thetis_RevG2_PCB.brd

## EAGLE design ECAD/Rev G2/Thetis_RevG2_PCB.brd (2023-10-24)

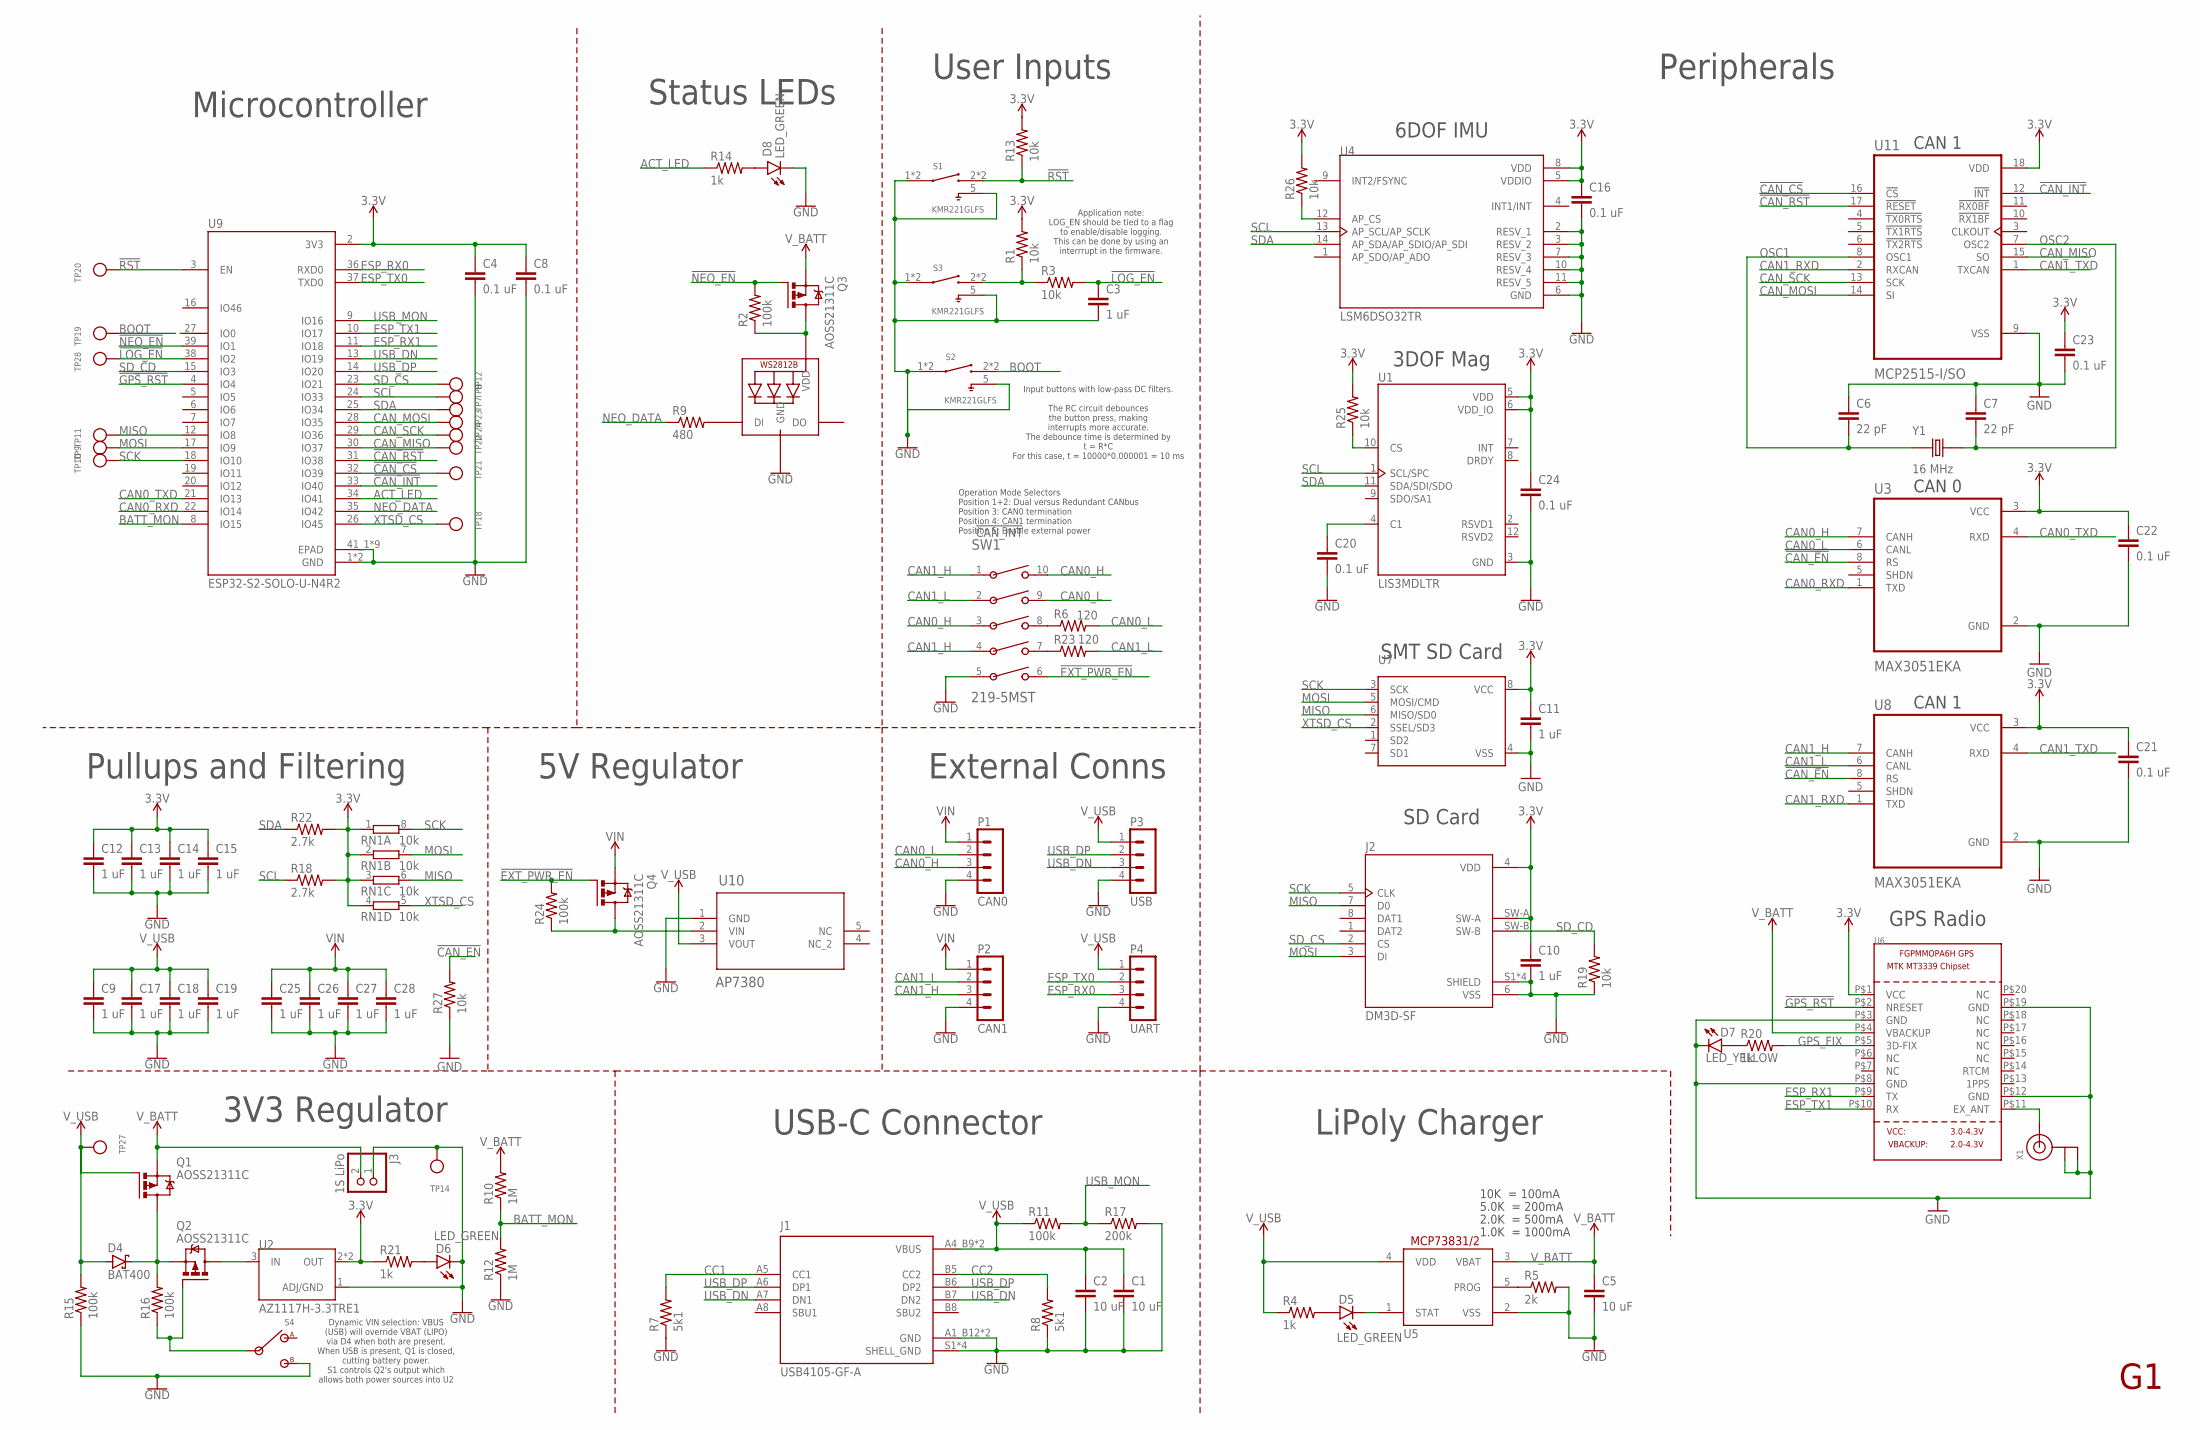
[picture p13: schematic Thetis_RevG2_SCH.sch]

Parts:
C1, C2, C5: 10 uF; C0603
C3, C9, C10, C11, C12, C13, C14, C15, C17, C18, C19, C25, C26, C27, C28: 1 uF; C0603
C4, C8, C16, C20, C21, C22, C23, C24: 0.1 uF; C0603
C6, C7: 22 pF; C0603
D4: BAT400; SOT23
D5, D6, D8: LED_GREEN; LEDC1608X65N_RND-G
D7: LED_YELLOW; LEDC1608X35N_FLAT-Y
J1: USB4105-GF-A; GCT_USB4105-GF-A
J2: DM3D-SF; HRS_DM3D-SF
J3: 1S LiPo; JSTPH2
LED1: WS2812B3535; LED3535
P1: CAN0; B4B-PH-K
P2: CAN1; B4B-PH-K
P3: USB; B4B-PH-K
P4: UART; B4B-PH-K
Q1, Q2, Q3, Q4: AOSS21311C; SOT23
R1, R3, R13, R19, R25, R26, R27: 10k; R0603
R2, R11, R15, R16, R24: 100k; R0603
R4, R14, R20, R21: 1k; R0603
R5: 2k; R0603
R6, R23: 120; R0603
R7, R8: 5k1; R0603
R9: 480; R0603
R10, R12: 1M; R0603
R17: 200k; R0603
R18, R22: 2.7k; R0603
RN1: 10k; EXBV8V
S1, S2, S3: KMR221GLFS; SW_KMR221GLFS
S4: CL-SB-12X; CL-SB-12A
SW1: 219-5MST; SW5_219SMT
TP7, TP8, TP9, TP10, TP11, TP12, TP14, TP18, TP19, TP20, TP21, TP22, TP23, TP24, TP27, TP28: TESTPOINT1.5X2.0MM_NOCREAM; PAD-1.5X2.0
U1: LIS3MDLTR; XDCR_LIS3MDLTR
U2: AZ1117H-3.3TRE1; SOT230P700X180-4N
U3, U8: MAX3051EKA; SOT65P280X145-8N
U4: LSM6DSO32TR; PQFN50P300X250X97-14N
U5: MCP73831/OT; SOT23-5L
U6: GPS_FGPMMOPA6H; FGPMMOPA6H
U7: SMT_SDCARD_8PIN; LGA8_8X6
U9: ESP32-S2-SOLO-U-N4R2; XCVR_ESP32-S2-SOLO-U-N4R2
U10: AP7380; SOT_50WR-7_DIO-L
U11: MCP2515-I/SO; SOIC127P1030X265-18N
X1: ANTENNA_U.FL; U.FL
Y1: 16 MHz; XTAL_ECS-160-20-3X-TR

Connections:
3.3V: C4.1, C8.1, C10.1, C11.1, C12.1, C13.1, C14.1, C15.1, C16.1, C21.1, C22.1, C23.1, C24.1, J2.4 (VDD), J2.SW-A, R1.2, R13.2, R18.2, R21.1, R22.2, R25.2, R26.2, RN1.1, RN1.2 (1), RN1.3 (1), RN1.4 (1), U1.5 (VDD), U1.6 (VDD_IO), U2.2 (OUT), U2.4 (OUT), U3.3 (VCC), U4.5 (VDDIO), U4.8 (VDD), U6.P$1 (VCC), U7.8 (VCC), U8.3 (VCC), U9.2 (3V3), U11.18 (VDD)
!CAN_CS: TP21.P$1, U9.32 (IO39), U11.16 (!CS)
!CAN_EN: R27.2, U3.8 (RS), U8.8 (RS)
!CAN_INT: U9.33 (IO40), U11.12 (!INT)
!CAN_RST: U9.31 (IO38), U11.17 (!RESET)
!EXT_PWR_EN: Q4.1 (G), R24.2, SW1.6 (10)
!GPS_RST: U6.P$2 (NRESET), U9.4 (IO4)
!LOG_EN: C3.1, R3.2, TP28.P$1, U9.38 (IO2)
!NEO_EN: Q3.1 (G), R2.2, U9.39 (IO1)
!RST: R13.1, S1.2 (3), S1.3, TP20.P$1, U9.3 (EN)
ACT_LED: R14.1, U9.34 (IO41)
BATT_MON: R10.1, R12.2, U9.8 (IO15)
BOOT: S2.2 (3), S2.3, TP19.P$1, U9.27 (IO0)
CAN0_H: P1.3, SW1.3 (5), SW1.10 (2), U3.7 (CANH)
CAN0_L: P1.2, R6.2, SW1.9 (4), U3.6 (CANL)
CAN0_RXD: U3.1 (TXD), U9.22 (IO14)
CAN0_TXD: U3.4 (RXD), U9.21 (IO13)
CAN1_H: P2.3, SW1.1, SW1.4 (7), U8.7 (CANH)
CAN1_L: P2.2, R23.2, SW1.2 (3), U8.6 (CANL)
CAN1_RXD: U8.1 (TXD), U11.2 (RXCAN)
CAN1_TXD: U8.4 (RXD), U11.1 (TXCAN)
CAN_MISO: TP22.P$1, U9.30 (IO37), U11.15 (SO)
CAN_MOSI: TP23.P$1, U9.28 (IO35), U11.14 (SI)
CAN_SCK: TP24.P$1, U9.29 (IO36), U11.13 (SCK)
CC1: J1.A5 (CC1), R7.2
CC2: J1.B5 (CC2), R8.2
ESP_RX0: P4.3, U9.36 (RXD0)
ESP_RX1: U6.P$9 (TX), U9.11 (IO18)
ESP_TX0: P4.2, U9.37 (TXD0)
ESP_TX1: U6.P$10 (RX), U9.10 (IO17)
GND: C1.2, C2.2, C3.2, C4.2, C5.2, C6.1, C7.1, C8.2, C9.2, C10.2, C11.2, C12.2, C13.2, C14.2, C15.2, C16.2, C17.2, C18.2, C19.2, C20.2, C21.2, C22.2, C23.2, C24.2, C25.2, C26.2, C27.2, C28.2, D6.C, D7.C, D8.C, J1.A1_B12 (GND), J1.B1_A12 (GND), J1.S1 (SHELL_GND), J1.S2 (SHELL_GND), J1.S3 (SHELL_GND), J1.S4 (SHELL_GND), J2.6 (VSS), J2.S1 (SHIELD), J2.S2 (SHIELD), J2.S3 (SHIELD), J2.S4 (SHIELD), J3.1, LED1.4 (GND), P1.4, P2.4, P3.4, P4.4, R5.2, R7.1, R8.1, R12.1, R15.1, R17.2, R19.1, R27.1, S1.1, S1.4 (1), S1.5, S2.1, S2.4 (1), S2.5, S3.1, S3.4 (1), S3.5, S4.3, SW1.5 (9), TP14.P$1, U1.3 (GND), U2.1 (ADJ/GND), U3.2 (GND), U4.2 (RESV_1), U4.3 (RESV_2), U4.6 (GND), U4.7 (RESV_3), U4.10 (RESV_4), U4.11 (RESV_5), U5.2 (VSS), U6.P$3 (GND), U6.P$8 (GND), U6.P$12 (GND), U6.P$19 (GND), U7.4 (VSS), U8.2 (GND), U9.1 (GND), U9.40 (GND), U9.41_1 (EPAD), U9.41_2 (EPAD), U9.41_3 (EPAD), U9.41_4 (EPAD), U9.41_5 (EPAD), U9.41_6 (EPAD), U9.41_7 (EPAD), U9.41_8 (EPAD), U9.41_9 (EPAD), U10.1 (GND), U11.9 (VSS), X1.1 (GND), X1.2 (GND)
GPS_FIX: R20.2, U6.P$5 (3D-FIX)
MISO: J2.7 (D0), RN1.6 (2), TP11.P$1, U7.6 (MISO/SD0), U9.12 (IO8)
MOSI: J2.3 (DI), RN1.7 (2), TP9.P$1, U7.5 (MOSI/CMD), U9.17 (IO9)
unnamed: Q2.1 (G), R16.1, S4.2
unnamed: D7.A, R20.1
unnamed: D8.A, R14.2
unnamed: R1.1, R3.1, S3.2 (3), S3.3
unnamed: LED1.2 (VDD), Q3.3 (D), R2.1
unnamed: Q2.3 (D), U2.3 (IN)
unnamed: C20.1, U1.4 (C1)
unnamed: LED1.1 (DI), R9.2
unnamed: U6.P$11 (EX_ANT), X1.3 (SIGNAL)
unnamed: R6.1, SW1.8 (6)
unnamed: R26.1, U4.12 (AP_CS)
unnamed: D4.3 (C), Q1.3 (D), Q2.2 (S), R16.2
unnamed: R23.1, SW1.7 (8)
unnamed: R25.1, U1.10 (CS)
unnamed: Q4.3 (D), R24.1, U10.2 (VIN)
unnamed: D5.A, R4.2
unnamed: D5.C, U5.1 (STAT)
unnamed: R5.1, U5.5 (PROG)
unnamed: D6.A, R21.2
NEO_DATA: R9.1, U9.35 (IO42)
OSC1: C6.2, U11.8 (OSC1), Y1.1
OSC2: C7.2, U11.7 (OSC2), Y1.2
SCK: J2.5 (CLK), RN1.8 (2), TP10.P$1, U7.3 (SCK), U9.18 (IO10)
SCL: R18.1, TP8.P$1, U1.1 (SCL/SPC), U4.13 (AP_SCL/AP_SCLK), U9.24 (IO33)
SDA: R22.1, TP7.P$1, U1.11 (SDA/SDI/SDO), U4.14 (AP_SDA/AP_SDIO/AP_SDI), U9.25 (IO34)
SD_CD: J2.SW-B, R19.2, U9.15 (IO3)
SD_CS: J2.2 (CS), TP12.P$1, U9.23 (IO21)
USB_DN: J1.A7 (DN1), J1.B7 (DN2), P3.3, U9.13 (IO19)
USB_DP: J1.A6 (DP1), J1.B6 (DP2), P3.2, U9.14 (IO20)
USB_MON: R11.2, R17.1, U9.9 (IO16)
VIN: C25.1, C26.1, C27.1, C28.1, P1.1, P2.1, Q4.2 (S)
V_BATT: C5.1, J3.2, Q1.2 (S), Q3.2 (S), R10.2, U5.3 (VBAT), U6.P$4 (VBACKUP)
V_USB: C1.1, C2.1, C9.1, C17.1, C18.1, C19.1, D4.1 (A), J1.A4_B9 (VBUS), J1.B4_A9 (VBUS), P3.1, P4.1, Q1.1 (G), R4.1, R11.1, R15.2, TP27.P$1, U5.4 (VDD), U10.3 (VOUT)
XTSD_CS: RN1.5 (2), TP18.P$1, U7.2 (SSEL/SD3), U9.26 (IO45)

Notes on the sheet:
10K = 100mA
5.0K = 200mA
2.0K = 500mA
1.0K = 1000mA
LiPoly Charger
3V3 Regulator
Peripherals
Status LEDs
Microcontroller
GPS Radio
Dynamic VIN selection: VBUS (USB) will override VBAT (LIPO) via D4 when both are present. When USB is present, Q1 is closed, cutting battery power. S1 controls Q2's output which allows both power sources into U2
USB-C Connector
Input buttons with low-pass DC filters. The RC circuit debounces the button press, making interrupts more accurate. The debounce time is determined by t = R*C For this case, t = 10000*0.000001 = 10 ms
User Inputs
Application note: LOG_EN should be tied to a flag to enable/disable logging. This can be done by using an interrrupt in the firmware.
SD Card
SMT SD Card
6DOF IMU
Pullups and Filtering
CAN 0
CAN 1
5V Regulator
Operation Mode Selectors Position 1+2: Dual versus Redundant CANbus Position 3: CAN0 termination Position 4: CAN1 termination Position 5: Enable external power
3DOF Mag
External Conns

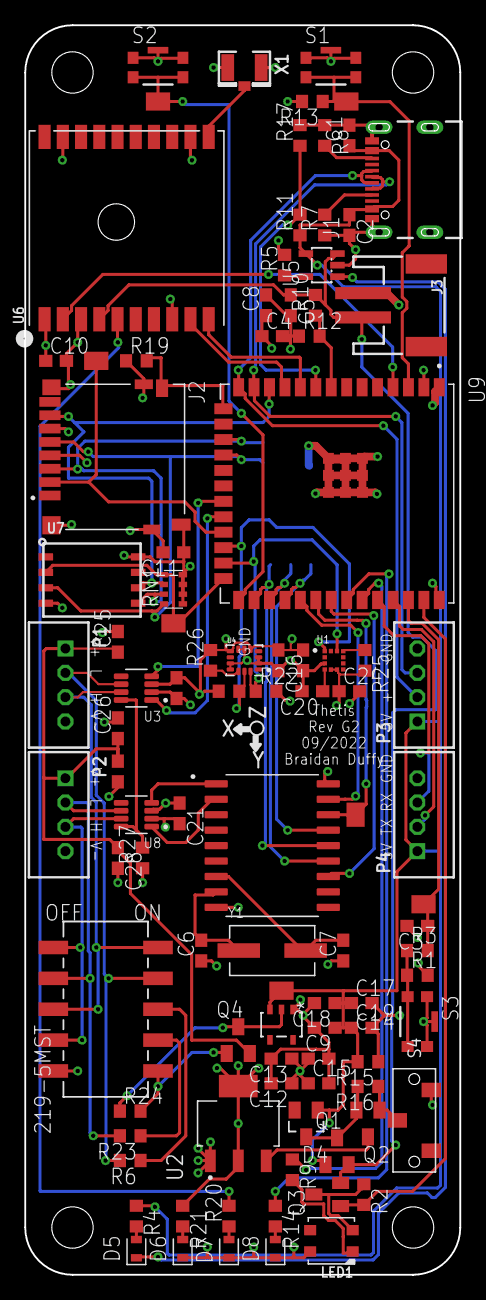
[picture p14: board Thetis_RevG2_PCB.brd from above]

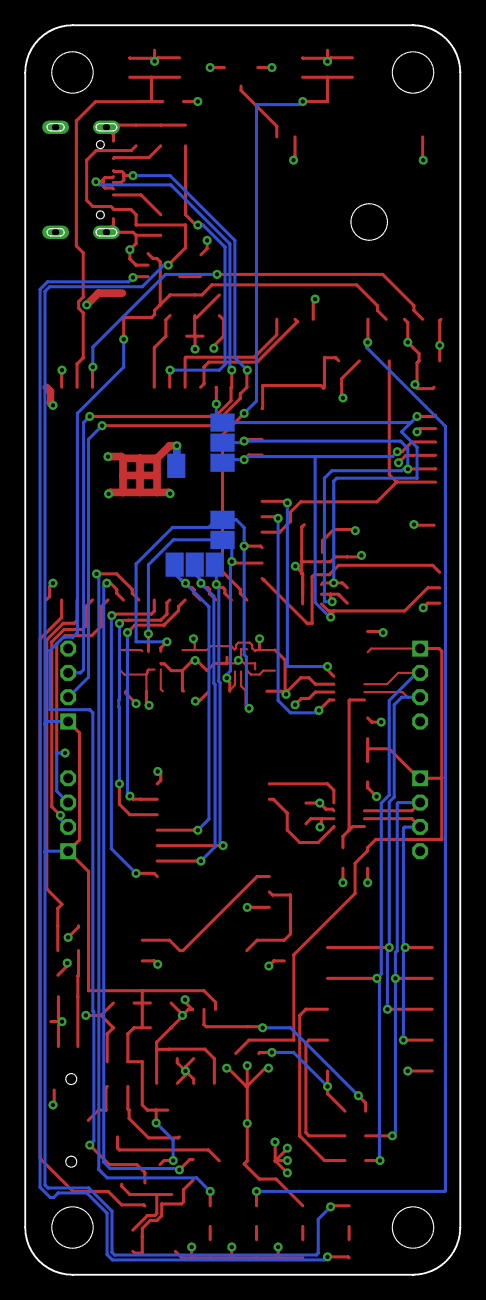
[picture p15: board Thetis_RevG2_PCB.brd from below]

Board: 4 copper layers, 35.8 x 102.8 mm, 107 parts (9 on the bottom side), 68 nets.
