Legohead259/Thetis-CAD/ECAD/Rev D2/Thetis_RevD2_PCB.brd

## EAGLE design ECAD/Rev D2/Thetis_RevD2_PCB.brd (2022-02-04)

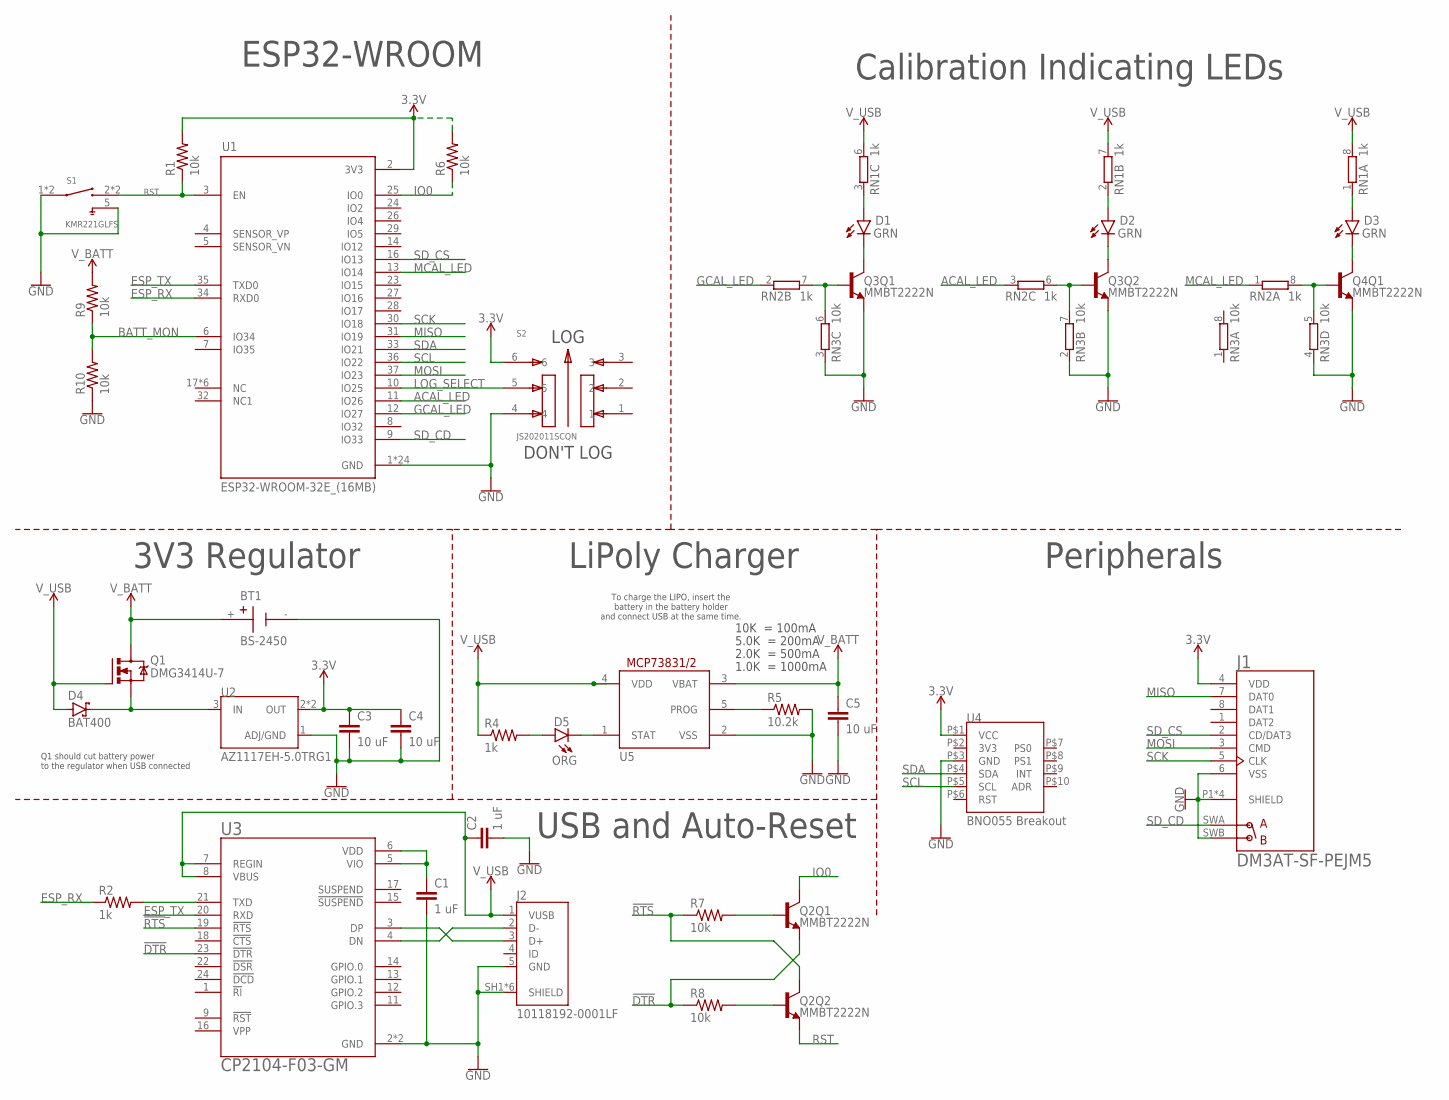
[picture p16: schematic Thetis_RevD2_SCH.sch]

Parts:
BT1: BS-2450; BAT_BS-2450
C1, C2: 1 uF; C0603
C3, C4, C5: 10 uF; C0603
D1, D2, D3: GRN; LEDC1608X65N
D4: BAT400; SOT23
D5: ORG; LEDC1608X65N
J1: DM3AT-SF-PEJM5; HRS_DM3AT-SF-PEJM5
J2: 10118192-0001LF; AMPHENOL_10118192-0001LF
Q1: DMG3414U-7; SOT23
Q2, Q3, Q4: MMBT2222N; SC70-6
R1, R6, R7, R8, R9, R10: 10k; R0603
R2, R4: 1k; R0603
R5: 10.2k; R0603
RN1, RN2: 1k; EXB28V
RN3: 10k; EXB28V
S1: KMR221GLFS; SW_KMR221GLFS
S2: JS202011SCQN; SW_JS202011SCQN
U1: ESP32-WROOM-32E_(16MB); MODULE_ESP32-WROOM-32E_(16MB)
U2: AZ1117EH-5.0TRG1; SOT230P700X180-4N
U3: CP2104-F03-GM; QFN50P400X400X80-25N
U4: BNO055 Breakout; ADAFRUIT-BNO055-BREAKOUT-SMD
U5: MCP73831/OT; SOT23-5L

Connections:
3.3V: C3.1, C4.1, J1.4 (VDD), R1.2, R6.2, S2.6, U1.2 (3V3), U2.2 (OUT), U2.4 (OUT), U4.P$1 (VCC)
3V3: U4.P$2 (3V3)
!DTR: Q2.4 (E), R8.1, U3.23 (!DTR)
!RTS: Q2.6 (C), R7.1, U3.19 (!RTS)
ACAL_LED: RN2.3 (1), U1.11 (IO26)
BATT_MON: R9.1, R10.2, U1.6 (IO34)
ESP_RX: R2.1, U1.34 (RXD0)
ESP_TX: U1.35 (TXD0), U3.20 (RXD)
GCAL_LED: RN2.2 (1), U1.12 (IO27)
GND: BT1.-, C1.2, C2.2, C3.2, C4.2, C5.2, J1.6 (VSS), J1.P1 (SHIELD), J1.P2 (SHIELD), J1.P3 (SHIELD), J1.P4 (SHIELD), J1.SWB (B), J2.5 (GND), J2.SH1 (SHIELD), J2.SH2 (SHIELD), J2.SH3 (SHIELD), J2.SH4 (SHIELD), J2.SH5 (SHIELD), J2.SH6 (SHIELD), Q3.1 (E), Q3.4 (E), Q4.4 (E), R5.2, R10.1, RN3.2 (1), RN3.3 (1), RN3.4 (1), S1.1, S1.4 (1), S1.5, S2.4, U1.1 (GND), U1.15 (GND), U1.38 (GND), U1.39_1 (GND), U1.39_2 (GND), U1.39_3 (GND), U1.39_4 (GND), U1.39_5 (GND), U1.39_6 (GND), U1.39_7 (GND), U1.39_8 (GND), U1.39_9 (GND), U1.39_10 (GND), U1.39_11 (GND), U1.39_12 (GND), U1.39_13 (GND), U1.39_14 (GND), U1.39_15 (GND), U1.39_16 (GND), U1.39_17 (GND), U1.39_18 (GND), U1.39_19 (GND), U1.39_20 (GND), U1.39_21 (GND), U2.1 (ADJ/GND), U3.2 (GND), U3.25 (GND), U4.P$3 (GND), U5.2 (VSS)
IO0: Q2.3 (C), R6.1, U1.25 (IO0)
LOG_SELECT: S2.5, U1.10 (IO25)
MCAL_LED: RN2.1, U1.13 (IO14)
MISO: J1.7 (DAT0), U1.31 (IO19)
MOSI: J1.3 (CMD), U1.37 (IO23)
unnamed: C1.1, U3.5 (VIO), U3.6 (VDD)
unnamed: R2.2, U3.21 (TXD)
unnamed: J2.3 (D+), U3.3 (DP)
unnamed: J2.2 (D-), U3.4 (DN)
unnamed: Q3.5 (B), RN2.7 (2), RN3.6 (2)
unnamed: Q2.2 (B), R8.2
unnamed: D1.C, Q3.3 (C)
unnamed: Q2.5 (B), R7.2
unnamed: D1.A, RN1.3 (1)
unnamed: D2.A, RN1.2 (1)
unnamed: D2.C, Q3.6 (C)
unnamed: D4.3 (C), Q1.2 (S), U2.3 (IN)
unnamed: Q3.2 (B), RN2.6 (2), RN3.7 (2)
unnamed: Q4.5 (B), RN2.8 (2), RN3.5 (2)
unnamed: D3.C, Q4.3 (C)
unnamed: D3.A, RN1.1
unnamed: D5.A, R4.2
unnamed: D5.C, U5.1 (STAT)
unnamed: R5.1, U5.5 (PROG)
RST: Q2.1 (E), R1.1, S1.2 (3), S1.3, U1.3 (EN)
SCK: J1.5 (CLK), U1.30 (IO18)
SCL: U1.36 (IO22), U4.P$5 (SCL)
SDA: U1.33 (IO21), U4.P$4 (SDA)
SD_CD: J1.SWA (A), U1.9 (IO33)
SD_CS: J1.2 (CD/DAT3), U1.16 (IO13)
V_BATT: BT1.+, C5.1, Q1.3 (D), R9.2, U5.3 (VBAT)
V_USB: C2.1, D4.1 (A), J2.1 (VUSB), Q1.1 (G), R4.1, RN1.6 (2), RN1.7 (2), RN1.8 (2), U3.7 (REGIN), U3.8 (VBUS), U5.4 (VDD)

Notes on the sheet:
LOG
DON'T LOG
10K = 100mA
5.0K = 200mA
2.0K = 500mA
1.0K = 1000mA
To charge the LIPO, insert the battery in the battery holder and connect USB at the same time.
LiPoly Charger
USB and Auto-Reset
3V3 Regulator
Q1 should cut battery power to the regulator when USB connected
Peripherals
Calibration Indicating LEDs
ESP32-WROOM

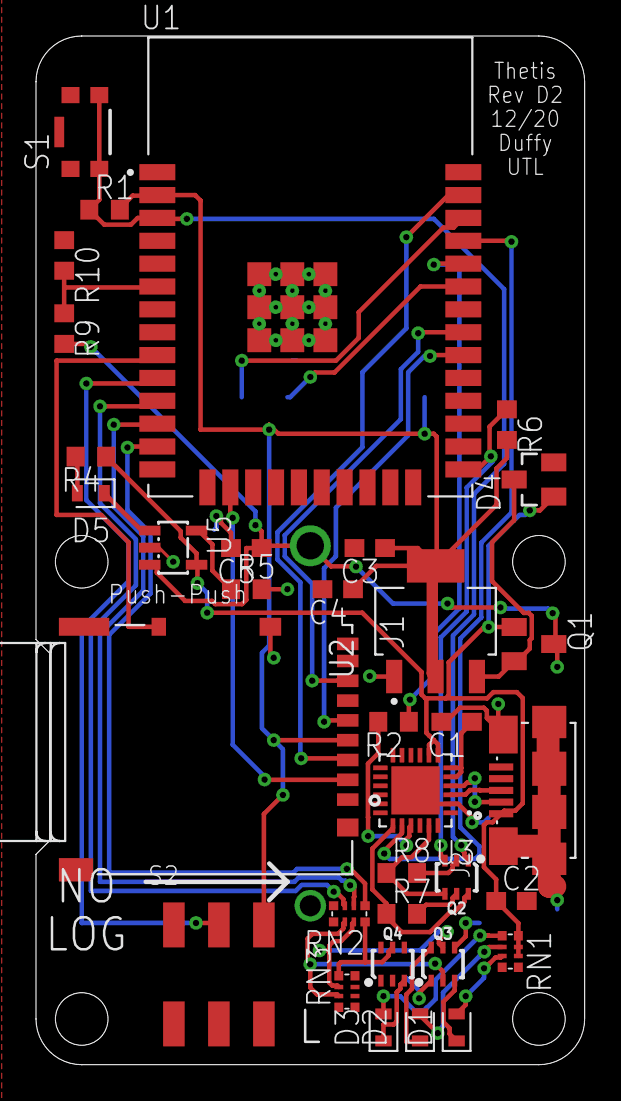
[picture p17: board Thetis_RevD2_PCB.brd from above]

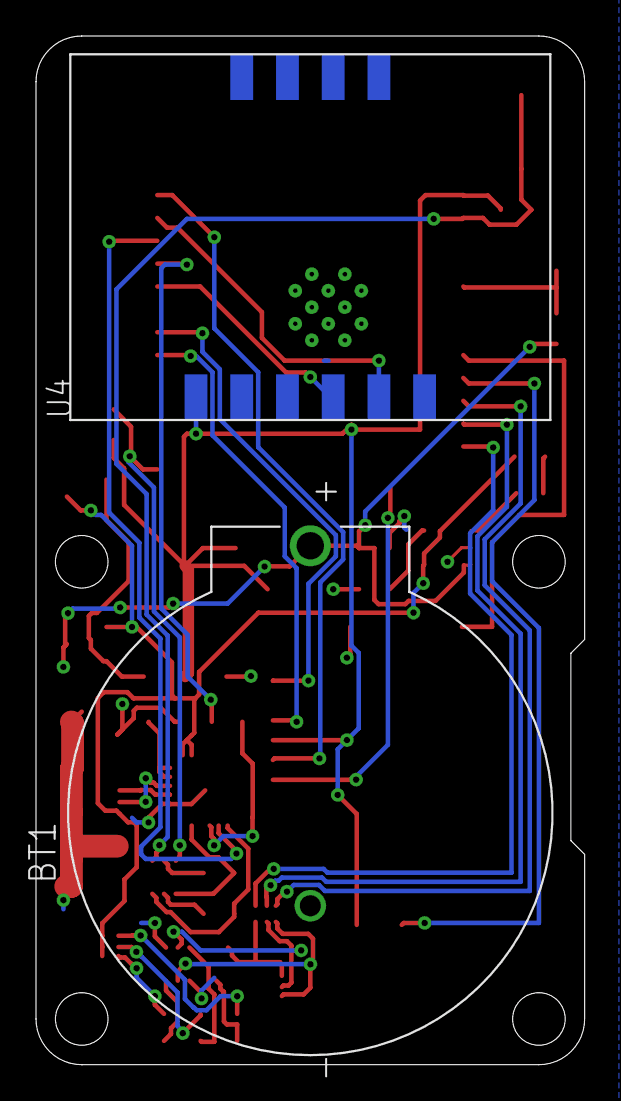
[picture p18: board Thetis_RevD2_PCB.brd from below]

Board: 2 copper layers, 30.5 x 57.1 mm, 36 parts (2 on the bottom side), 41 nets.
