Legohead259/Thetis-CAD/ECAD/Rev F6/Thetis_RevF6_PCB.brd

## EAGLE design ECAD/Rev F6/Thetis_RevF6_PCB.brd (2023-10-26)

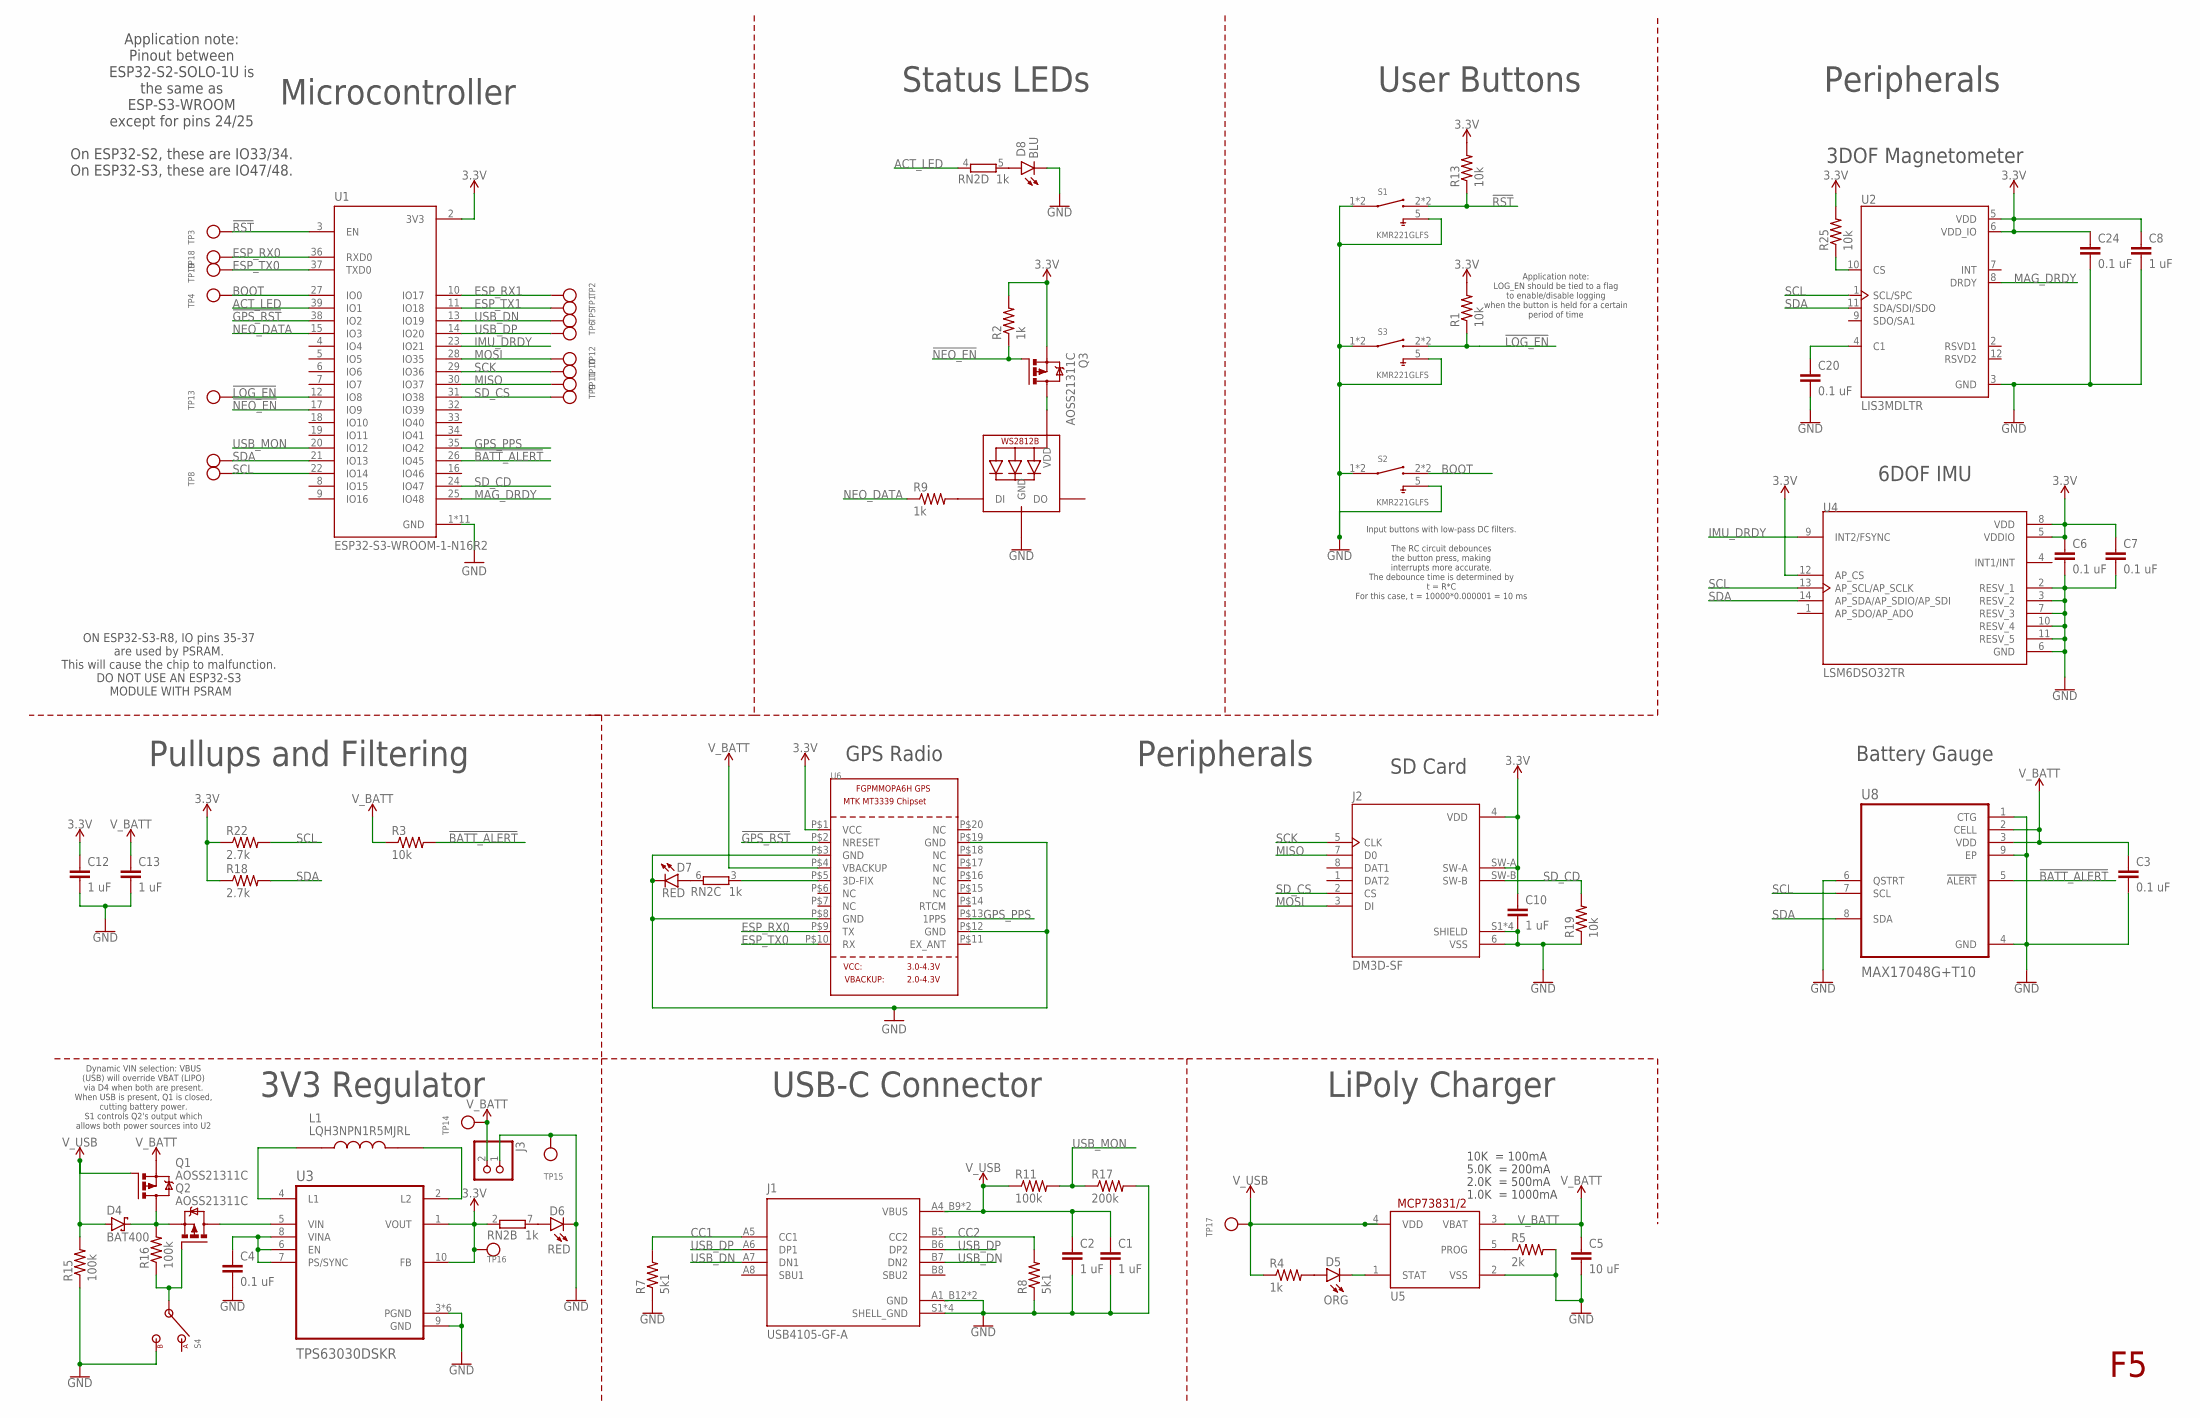
[picture p19: schematic Thetis_RevF6_SCH.sch]

Parts:
C1, C2, C8, C10, C12, C13: 1 uF; C0603
C3, C4, C6, C7, C20, C24: 0.1 uF; C0603
C5: 10 uF; C0603
D4: BAT400; SOT23
D5: ORG; LEDC1608X65N
D6: RED; LEDC1608X65N
D7: RED; LEDC1608X35N
D8: BLU; LEDC1608X65N
J1: USB4105-GF-A; GCT_USB4105-GF-A
J2: DM3D-SF; HRS_DM3D-SF
J3: JST_2PIN; JSTPH2
L1: LQH3NPN1R5MJRL; IND_LQH3NPN1R5MJRL
LED1: WS2812B3535; LED3535
Q1, Q2, Q3: AOSS21311C; SOT23
R1, R3, R13, R19, R25: 10k; R0603
R2, R4, R9: 1k; R0603
R5: 2k; R0603
R7, R8: 5k1; R0603
R11, R15, R16: 100k; R0603
R17: 200k; R0603
R18, R22: 2.7k; R0603
RN2: 1k; EXBN8V
S1, S2, S3: KMR221GLFS; SW_KMR221GLFS
S4: CL-SB-12X; CL-SB-12A
TP1, TP2, TP3, TP4, TP5, TP6, TP7, TP8, TP9, TP10, TP11, TP12, TP13, TP14, TP15, TP16, TP17, TP18, TP19: TESTPOINT1.5X2.0MM_NOCREAM; PAD-1.5X2.0
U1: ESP32-S3-WROOM-1-N16R2; XCVR_ESP32-S3-WROOM-1-N16R2
U2: LIS3MDLTR; XDCR_LIS3MDLTR
U3: TPS63030DSKR; SON50P250X250X80-11N
U4: LSM6DSO32TR; PQFN50P300X250X97-14N
U5: MCP73831/OT; SOT23-5L
U6: GPS_FGPMMOPA6H; FGPMMOPA6H
U8: MAX17048G+T10; SON50P200X200X80-9N

Connections:
3.3V: C6.1, C7.1, C8.1, C10.1, C12.1, C24.1, J2.4 (VDD), J2.SW-A, Q3.2 (S), R1.2, R2.2, R13.2, R18.1, R22.1, R25.2, RN2.2 (1), TP16.P$1, U1.2 (3V3), U2.5 (VDD), U2.6 (VDD_IO), U3.1 (VOUT), U3.10 (FB), U4.5 (VDDIO), U4.8 (VDD), U4.12 (AP_CS), U6.P$1 (VCC)
!BATT_ALERT: R3.2, U1.26 (IO45), U8.5 (!ALERT)
!GPS_RST: U1.38 (IO2), U6.P$2 (NRESET)
!LOG_EN: R1.1, S3.2 (3), S3.3, TP13.P$1, U1.12 (IO8)
!NEO_EN: Q3.1 (G), R2.1, U1.17 (IO9)
!RST: R13.1, S1.2 (3), S1.3, TP3.P$1, U1.3 (EN)
ACT_LED: RN2.4 (1), U1.39 (IO1)
BOOT: S2.2 (3), S2.3, TP4.P$1, U1.27 (IO0)
CC1: J1.A5 (CC1), R7.2
CC2: J1.B5 (CC2), R8.2
ESP_RX0: TP18.P$1, U1.36 (RXD0), U6.P$9 (TX)
ESP_RX1: TP2.P$1, U1.10 (IO17)
ESP_TX0: TP19.P$1, U1.37 (TXD0), U6.P$10 (RX)
ESP_TX1: TP1.P$1, U1.11 (IO18)
GND: C1.2, C2.2, C3.2, C4.2, C5.2, C6.2, C7.2, C8.2, C10.2, C12.2, C13.2, C20.2, C24.2, D6.C, D7.C, D8.C, J1.A1_B12 (GND), J1.B1_A12 (GND), J1.S1 (SHELL_GND), J1.S2 (SHELL_GND), J1.S3 (SHELL_GND), J1.S4 (SHELL_GND), J2.6 (VSS), J2.S1 (SHIELD), J2.S2 (SHIELD), J2.S3 (SHIELD), J2.S4 (SHIELD), J3.1, LED1.4 (GND), R5.2, R7.1, R8.1, R15.1, R17.2, R19.1, S1.1, S1.4 (1), S1.5, S2.1, S2.4 (1), S2.5, S3.1, S3.4 (1), S3.5, S4.3, TP15.P$1, U1.1 (GND), U1.40 (GND), U1.41_1 (GND), U1.41_2 (GND), U1.41_3 (GND), U1.41_4 (GND), U1.41_5 (GND), U1.41_6 (GND), U1.41_7 (GND), U1.41_8 (GND), U1.41_9 (GND), U2.3 (GND), U3.3 (PGND), U3.9 (GND), U3.11 (PGND), U3.12 (PGND), U3.13 (PGND), U3.14 (PGND), U3.15 (PGND), U4.2 (RESV_1), U4.3 (RESV_2), U4.6 (GND), U4.7 (RESV_3), U4.10 (RESV_4), U4.11 (RESV_5), U5.2 (VSS), U6.P$3 (GND), U6.P$8 (GND), U6.P$12 (GND), U6.P$19 (GND), U8.1 (CTG), U8.4 (GND), U8.6 (QSTRT), U8.9 (EP)
GPS_PPS: U1.35 (IO42), U6.P$13 (1PPS)
IMU_DRDY: U1.23 (IO21), U4.9 (INT2/FSYNC)
MAG_DRDY: U1.25 (IO48), U2.8 (DRDY)
MISO: J2.7 (D0), TP11.P$1, U1.30 (IO37)
MOSI: J2.3 (DI), TP12.P$1, U1.28 (IO35)
unnamed: Q2.1 (G), R16.1, S4.2
unnamed: D7.A, RN2.6 (2)
unnamed: D8.A, RN2.5 (2)
unnamed: Q2.3 (D), U3.5 (VIN)
unnamed: LED1.2 (VDD), Q3.3 (D)
unnamed: D6.A, RN2.7 (2)
unnamed: C20.1, U2.4 (C1)
unnamed: LED1.1 (DI), R9.2
unnamed: RN2.3 (1), U6.P$5 (3D-FIX)
unnamed: L1.1, U3.4 (L1)
unnamed: L1.2, U3.2 (L2)
unnamed: D4.3 (C), Q1.3 (D), Q2.2 (S), R16.2
unnamed: R25.1, U2.10 (CS)
unnamed: C4.1, U3.6 (EN), U3.7 (PS/SYNC), U3.8 (VINA)
unnamed: D5.A, R4.2
unnamed: D5.C, U5.1 (STAT)
unnamed: R5.1, U5.5 (PROG)
NEO_DATA: R9.1, U1.15 (IO3)
SCK: J2.5 (CLK), TP10.P$1, U1.29 (IO36)
SCL: R22.2, TP8.P$1, U1.22 (IO14), U2.1 (SCL/SPC), U4.13 (AP_SCL/AP_SCLK), U8.7 (SCL)
SDA: R18.2, TP7.P$1, U1.21 (IO13), U2.11 (SDA/SDI/SDO), U4.14 (AP_SDA/AP_SDIO/AP_SDI), U8.8 (SDA)
SD_CD: J2.SW-B, R19.2, U1.24 (IO47)
SD_CS: J2.2 (CS), TP9.P$1, U1.31 (IO38)
USB_DN: J1.A7 (DN1), J1.B7 (DN2), TP5.P$1, U1.13 (IO19)
USB_DP: J1.A6 (DP1), J1.B6 (DP2), TP6.P$1, U1.14 (IO20)
USB_MON: R11.2, R17.1, U1.20 (IO12)
V_BATT: C3.1, C5.1, C13.1, J3.2, Q1.2 (S), R3.1, TP14.P$1, U5.3 (VBAT), U6.P$4 (VBACKUP), U8.2 (CELL), U8.3 (VDD)
V_USB: C1.1, C2.1, D4.1 (A), J1.A4_B9 (VBUS), J1.B4_A9 (VBUS), Q1.1 (G), R4.1, R11.1, R15.2, TP17.P$1, U5.4 (VDD)

Notes on the sheet:
Peripherals
Status LEDs
Microcontroller
User Buttons
3DOF Magnetometer
6DOF IMU
Pullups and Filtering
Application note: Pinout between ESP32-S2-SOLO-1U is the same as ESP-S3-WROOM except for pins 24/25 On ESP32-S2, these are IO33/34. On ESP32-S3, these are IO47/48.
ON ESP32-S3-R8, IO pins 35-37 are used by PSRAM. This will cause the chip to malfunction. DO NOT USE AN ESP32-S3 MODULE WITH PSRAM
Input buttons with low-pass DC filters. The RC circuit debounces the button press, making interrupts more accurate. The debounce time is determined by t = R*C For this case, t = 10000*0.000001 = 10 ms
Application note: LOG_EN should be tied to a flag to enable/disable logging when the button is held for a certain period of time
GPS Radio
SD Card
10K = 100mA
5.0K = 200mA
2.0K = 500mA
1.0K = 1000mA
LiPoly Charger
3V3 Regulator
Dynamic VIN selection: VBUS (USB) will override VBAT (LIPO) via D4 when both are present. When USB is present, Q1 is closed, cutting battery power. S1 controls Q2's output which allows both power sources into U2
USB-C Connector
Battery Gauge

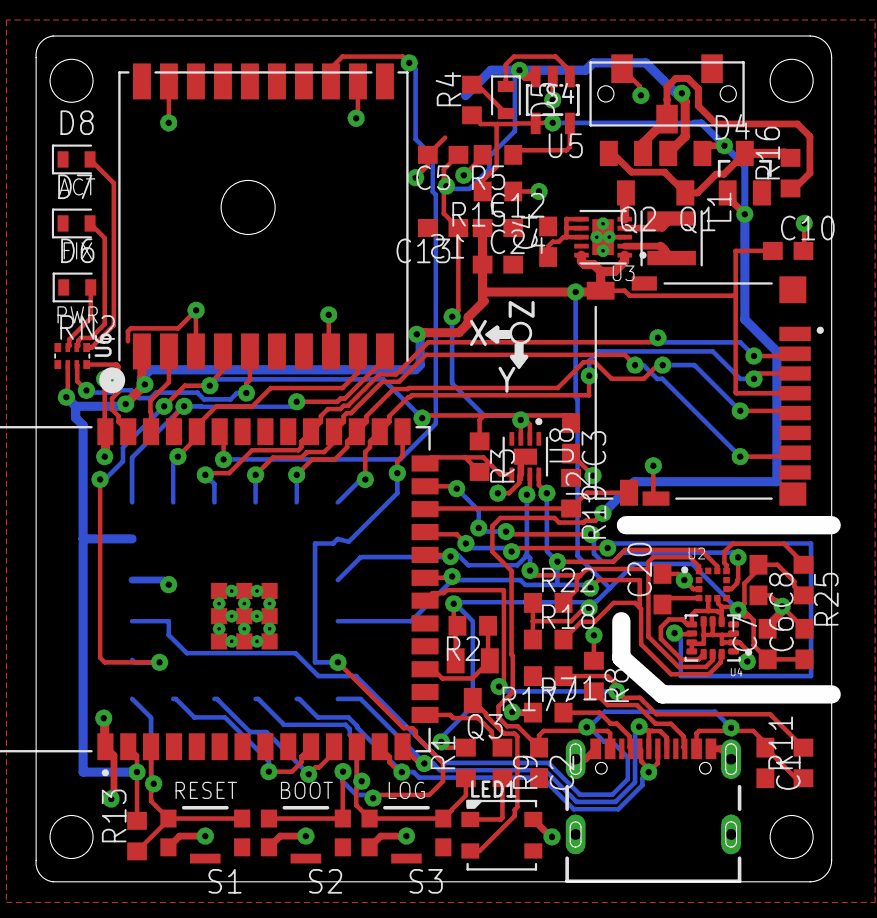
[picture p20: board Thetis_RevF6_PCB.brd from above]

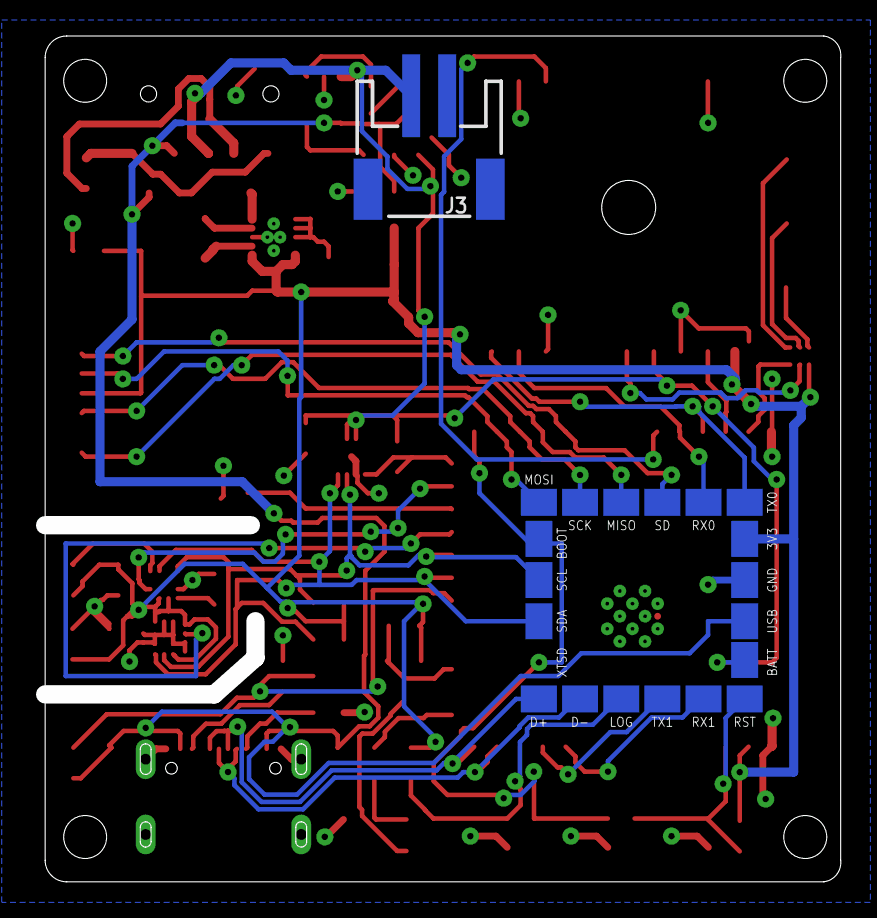
[picture p21: board Thetis_RevF6_PCB.brd from below]

Board: 2 copper layers, 44.2 x 47.0 mm, 74 parts (20 on the bottom side), 48 nets.
