Legohead259/Thetis-CAD/ECAD/Rev F4/Thetis_RevF4_PCB.brd

## EAGLE design ECAD/Rev F4/Thetis_RevF4_PCB.brd (2022-07-14)

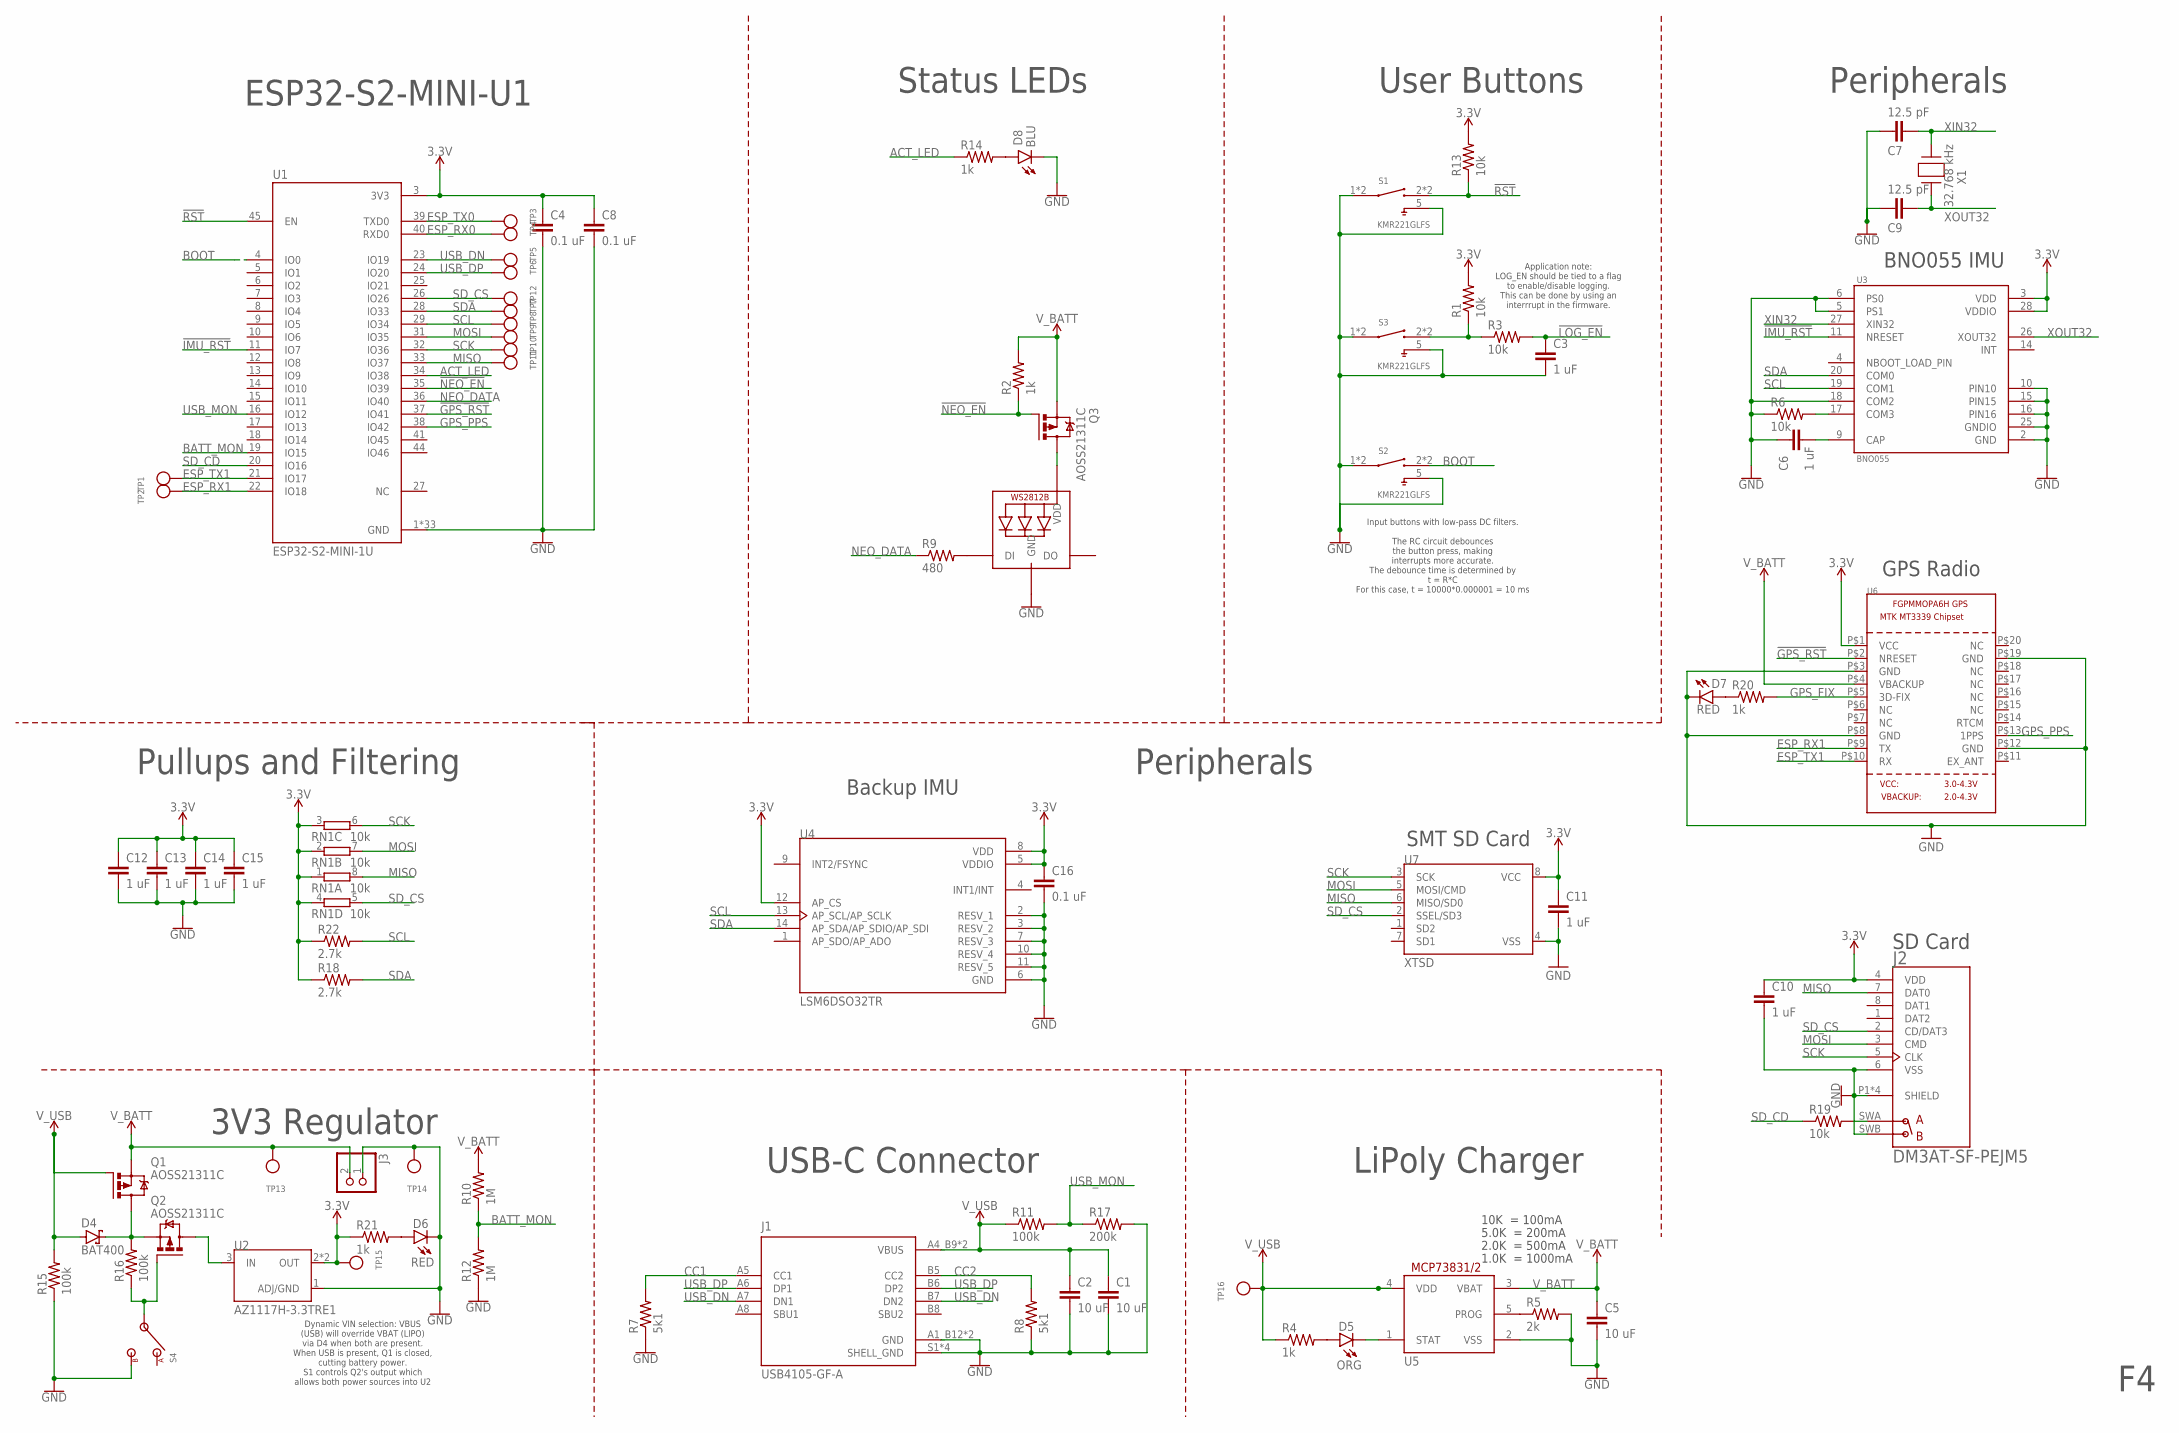
[picture p22: schematic Thetis_RevF4_SCH.sch]

Parts:
C1, C2, C5: 10 uF; C0603
C3, C6, C10, C11, C12, C13, C14, C15: 1 uF; C0603
C4, C8, C16: 0.1 uF; C0603
C7, C9: 12.5 pF; C0603
D4: BAT400; SOT23
D5: ORG; LEDC1608X65N
D6: RED; LEDC1608X65N
D7: RED; LEDC1608X35N
D8: BLU; LEDC1608X65N
J1: USB4105-GF-A; GCT_USB4105-GF-A
J2: DM3AT-SF-PEJM5; HRS_DM3AT-SF-PEJM5
J3: JST_2PIN; JSTPH2
LED1: WS2812B3535; LED3535
Q1, Q2, Q3: AOSS21311C; SOT23
R1, R3, R6, R13, R19: 10k; R0603
R2, R4, R14, R20, R21: 1k; R0603
R5: 2k; R0603
R7, R8: 5k1; R0603
R9: 480; R0603
R10, R12: 1M; R0603
R11, R15, R16: 100k; R0603
R17: 200k; R0603
R18, R22: 2.7k; R0603
RN1: 10k; EXBN8V
S1, S2, S3: KMR221GLFS; SW_KMR221GLFS
S4: CL-SB-12X; CL-SB-12A
TP1, TP2, TP3, TP4, TP5, TP6, TP7, TP8, TP9, TP10, TP11, TP12, TP13, TP14, TP15, TP16: TESTPOINT1.5X2.0MM_NOCREAM; PAD-1.5X2.0
U1: ESP32-S2-MINI-1U; XCVR_ESP32-S2-MINI-1U
U2: AZ1117H-3.3TRE1; SOT230P700X180-4N
U3: BNO055; LGA28R50P4X10_380X520X100
U4: LSM6DSO32TR; PQFN50P300X250X97-14N
U5: MCP73831/OT; SOT23-5L
U6: GPS_FGPMMOPA6H; FGPMMOPA6H
U7: XTSD; LGA8_8X6
X1: 32.768 kHz; RT3215_RAL-L

Connections:
3.3V: C4.1, C8.1, C10.1, C11.1, C12.1, C13.1, C14.1, C15.1, C16.1, J2.4 (VDD), R1.2, R13.2, R18.1, R21.1, R22.1, RN1.1, RN1.2 (1), RN1.3 (1), RN1.4 (1), TP15.P$1, U1.3 (3V3), U2.2 (OUT), U2.4 (OUT), U3.3 (VDD), U3.28 (VDDIO), U4.5 (VDDIO), U4.8 (VDD), U4.12 (AP_CS), U6.P$1 (VCC), U7.8 (VCC)
!GPS_RST: U1.37 (IO41), U6.P$2 (NRESET)
!IMU_RST: U1.11 (IO7), U3.11 (NRESET)
!LOG_EN: C3.1, R3.2
!NEO_EN: Q3.1 (G), R2.1, U1.35 (IO39)
!RST: R13.1, S1.2 (3), S1.3, U1.45 (EN)
ACT_LED: R14.1, U1.34 (IO38)
BATT_MON: R10.1, R12.2, U1.19 (IO15)
BOOT: S2.2 (3), S2.3, U1.4 (IO0)
CC1: J1.A5 (CC1), R7.2
CC2: J1.B5 (CC2), R8.2
ESP_RX0: TP4.P$1, U1.40 (RXD0)
ESP_RX1: TP2.P$1, U1.22 (IO18), U6.P$9 (TX)
ESP_TX0: TP3.P$1, U1.39 (TXD0)
ESP_TX1: TP1.P$1, U1.21 (IO17), U6.P$10 (RX)
GND: C1.2, C2.2, C3.2, C4.2, C5.2, C6.1, C7.1, C8.2, C9.1, C10.2, C11.2, C12.2, C13.2, C14.2, C15.2, C16.2, D6.C, D7.C, D8.C, J1.A1_B12 (GND), J1.B1_A12 (GND), J1.S1 (SHELL_GND), J1.S2 (SHELL_GND), J1.S3 (SHELL_GND), J1.S4 (SHELL_GND), J2.6 (VSS), J2.P1 (SHIELD), J2.P2 (SHIELD), J2.P3 (SHIELD), J2.P4 (SHIELD), J2.SWB (B), J3.1, LED1.4 (GND), R5.2, R6.1, R7.1, R8.1, R12.1, R15.1, R17.2, S1.1, S1.4 (1), S1.5, S2.1, S2.4 (1), S2.5, S3.1, S3.4 (1), S3.5, S4.3, TP14.P$1, U1.1 (GND), U1.2 (GND), U1.30 (GND), U1.42 (GND), U1.43 (GND), U1.46 (GND), U1.47 (GND), U1.48 (GND), U1.49 (GND), U1.50 (GND), U1.51 (GND), U1.52 (GND), U1.53 (GND), U1.54 (GND), U1.55 (GND), U1.56 (GND), U1.57 (GND), U1.58 (GND), U1.59 (GND), U1.60 (GND), U1.61_0 (GND), U1.61_1 (GND), U1.61_2 (GND), U1.61_3 (GND), U1.61_4 (GND), U1.61_5 (GND), U1.61_6 (GND), U1.61_7 (GND), U1.61_8 (GND), U1.62 (GND), U1.63 (GND), U1.64 (GND), U1.65 (GND), U2.1 (ADJ/GND), U3.2 (GND), U3.5 (PS1), U3.6 (PS0), U3.10 (PIN10), U3.15 (PIN15), U3.16 (PIN16), U3.18 (COM2), U3.25 (GNDIO), U4.2 (RESV_1), U4.3 (RESV_2), U4.6 (GND), U4.7 (RESV_3), U4.10 (RESV_4), U4.11 (RESV_5), U5.2 (VSS), U6.P$3 (GND), U6.P$8 (GND), U6.P$12 (GND), U6.P$19 (GND), U7.4 (VSS)
GPS_FIX: R20.2, U6.P$5 (3D-FIX)
GPS_PPS: U1.38 (IO42), U6.P$13 (1PPS)
MISO: J2.7 (DAT0), RN1.8 (2), TP11.P$1, U1.33 (IO37), U7.6 (MISO/SD0)
MOSI: J2.3 (CMD), RN1.7 (2), TP9.P$1, U1.31 (IO35), U7.5 (MOSI/CMD)
unnamed: Q2.1 (G), R16.1, S4.2
unnamed: D7.A, R20.1
unnamed: D8.A, R14.2
unnamed: R1.1, R3.1, S3.2 (3), S3.3
unnamed: LED1.2 (VDD), Q3.3 (D)
unnamed: Q2.3 (D), U2.3 (IN)
unnamed: R6.2, U3.17 (COM3)
unnamed: LED1.1 (DI), R9.2
unnamed: C6.2, U3.9 (CAP)
unnamed: D4.3 (C), Q1.3 (D), Q2.2 (S), R16.2
unnamed: D5.A, R4.2
unnamed: D5.C, U5.1 (STAT)
unnamed: R5.1, U5.5 (PROG)
unnamed: J2.SWA (A), R19.2
unnamed: D6.A, R21.2
NEO_DATA: R9.1, U1.36 (IO40)
SCK: J2.5 (CLK), RN1.6 (2), TP10.P$1, U1.32 (IO36), U7.3 (SCK)
SCL: R22.2, TP8.P$1, U1.29 (IO34), U3.19 (COM1), U4.13 (AP_SCL/AP_SCLK)
SDA: R18.2, TP7.P$1, U1.28 (IO33), U3.20 (COM0), U4.14 (AP_SDA/AP_SDIO/AP_SDI)
SD_CD: R19.1, U1.20 (IO16)
SD_CS: J2.2 (CD/DAT3), RN1.5 (2), TP12.P$1, U1.26 (IO26), U7.2 (SSEL/SD3)
USB_DN: J1.A7 (DN1), J1.B7 (DN2), TP5.P$1, U1.23 (IO19)
USB_DP: J1.A6 (DP1), J1.B6 (DP2), TP6.P$1, U1.24 (IO20)
USB_MON: R11.2, R17.1, U1.16 (IO12)
V_BATT: C5.1, J3.2, Q1.2 (S), Q3.2 (S), R2.2, R10.2, TP13.P$1, U5.3 (VBAT), U6.P$4 (VBACKUP)
V_USB: C1.1, C2.1, D4.1 (A), J1.A4_B9 (VBUS), J1.B4_A9 (VBUS), Q1.1 (G), R4.1, R11.1, R15.2, TP16.P$1, U5.4 (VDD)
XIN32: C7.2, U3.27 (XIN32), X1.1
XOUT32: C9.2, U3.26 (XOUT32), X1.2

Notes on the sheet:
10K = 100mA
5.0K = 200mA
2.0K = 500mA
1.0K = 1000mA
LiPoly Charger
3V3 Regulator
Peripherals
Status LEDs
ESP32-S2-MINI-U1
GPS Radio
Dynamic VIN selection: VBUS (USB) will override VBAT (LIPO) via D4 when both are present. When USB is present, Q1 is closed, cutting battery power. S1 controls Q2's output which allows both power sources into U2
USB-C Connector
Input buttons with low-pass DC filters. The RC circuit debounces the button press, making interrupts more accurate. The debounce time is determined by t = R*C For this case, t = 10000*0.000001 = 10 ms
User Buttons
Application note: LOG_EN should be tied to a flag to enable/disable logging. This can be done by using an interrrupt in the firmware.
BNO055 IMU
SD Card
SMT SD Card
Backup IMU
Pullups and Filtering

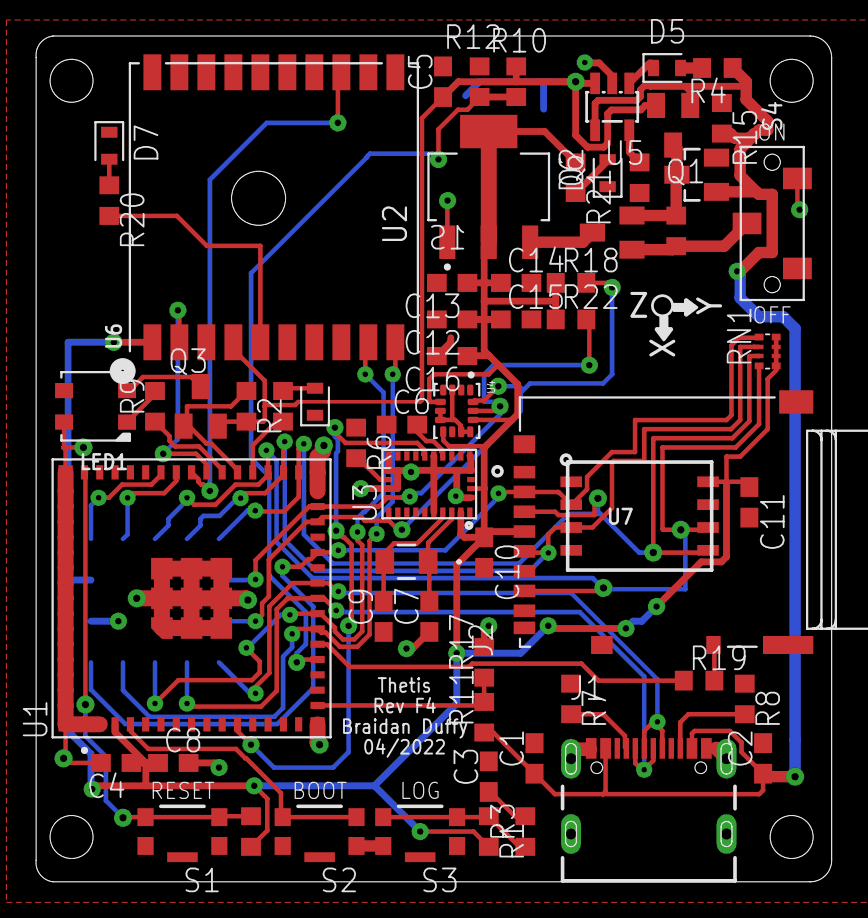
[picture p23: board Thetis_RevF4_PCB.brd from above]

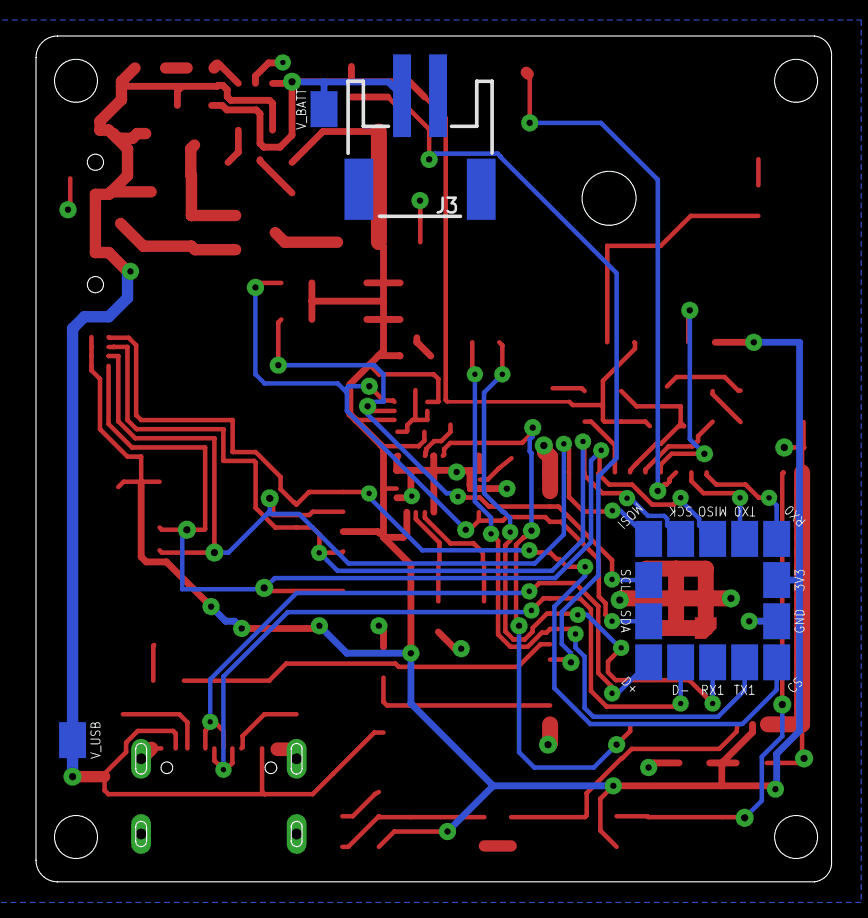
[picture p24: board Thetis_RevF4_PCB.brd from below]

Board: 2 copper layers, 44.2 x 47.0 mm, 79 parts (17 on the bottom side), 48 nets.
