Legohead259/Thetis-CAD/ECAD/Rev F2/Thetis_RevF2_PCB.brd

## EAGLE design ECAD/Rev F2/Thetis_RevF2_PCB.brd (2022-02-04)

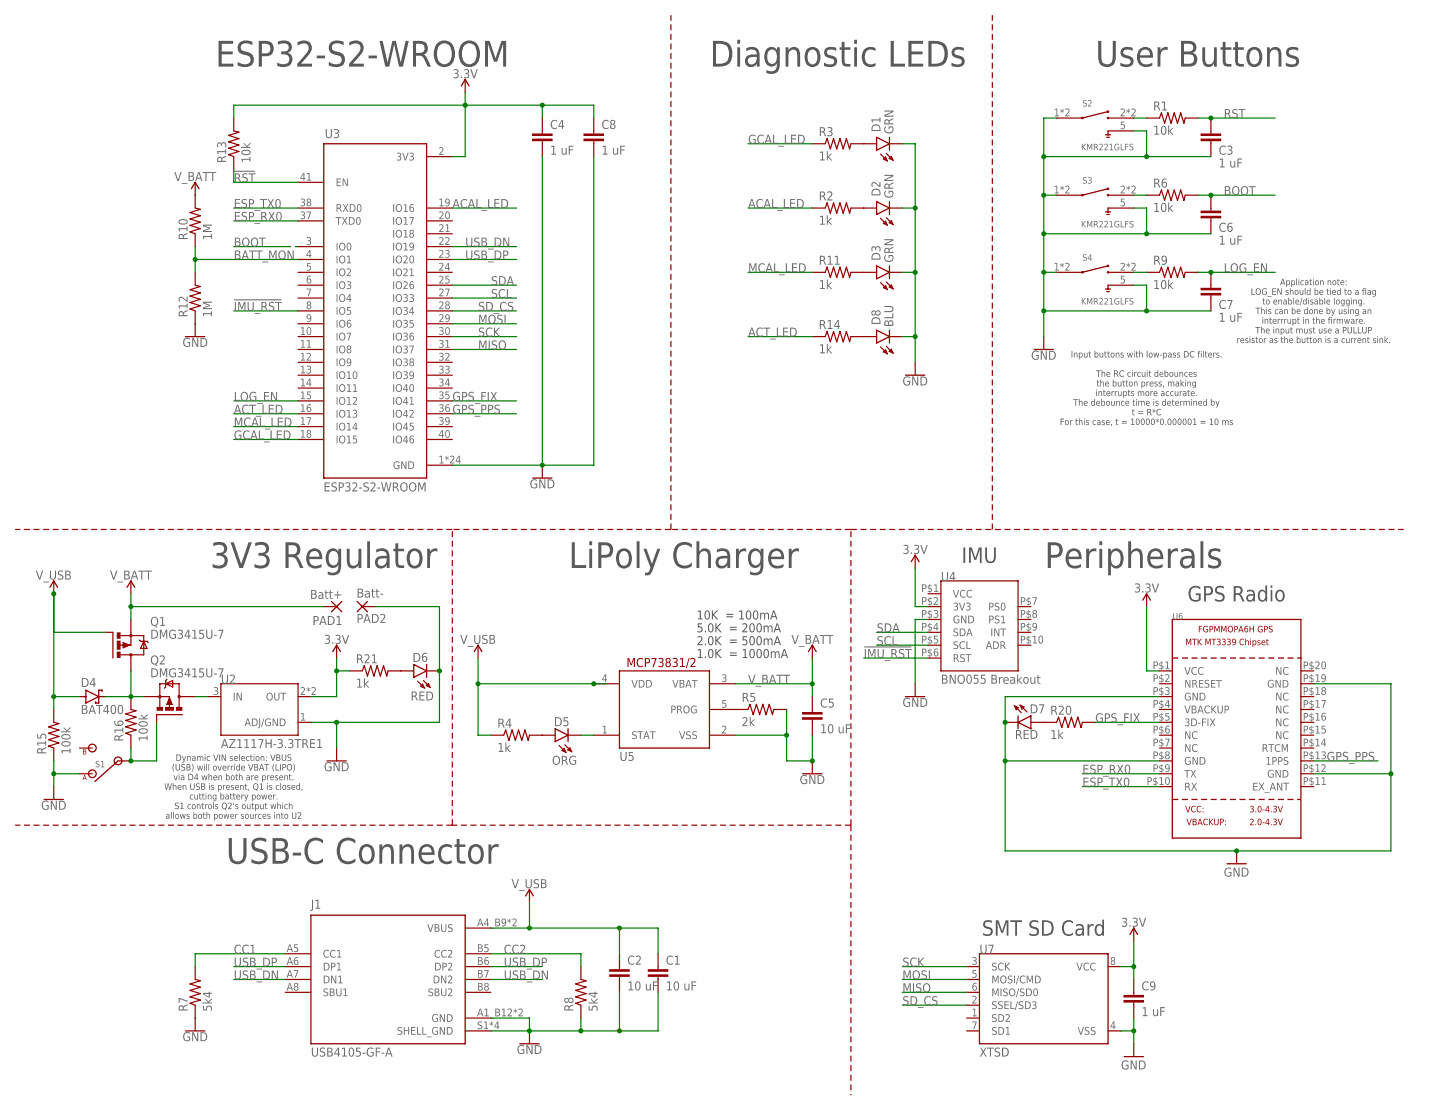
[picture p25: schematic Thetis_RevF2_SCH.sch]

Parts:
C1, C2, C5: 10 uF; C0603
C3, C4, C6, C7, C8, C9: 1 uF; C0603
D1, D2, D3: GRN; LEDC1608X65N
D4: BAT400; SOT23
D5: ORG; LEDC1608X65N
D6: RED; LEDC1608X65N
D7: RED; LEDC1608X35N
D8: BLU; LEDC1608X65N
J1: USB4105-GF-A; GCT_USB4105-GF-A
PAD1: Batt+; SMD2,54-5,08
PAD2: Batt-; SMD2,54-5,08
Q1, Q2: DMG3415U-7; SOT23
R1, R6, R9, R13: 10k; R0603
R2, R3, R4, R11, R14, R20, R21: 1k; R0603
R5: 2k; R0603
R7, R8: 5k4; R0603
R10, R12: 1M; R0603
R15, R16: 100k; R0603
S1: CL-SB-12X; CL-SB-12A
S2, S3, S4: KMR221GLFS; SW_KMR221GLFS
U2: AZ1117H-3.3TRE1; SOT230P700X180-4N
U3: ESP32-S2-WROOM; XCVR_ESP32-S2-WROOM
U4: BNO055 Breakout; ADAFRUIT-BNO055-BREAKOUT-SMD
U5: MCP73831/OT; SOT23-5L
U6: GPS_FGPMMOPA6H; FGPMMOPA6H
U7: XTSD; LGA8_8X6

Connections:
3.3V: C4.1, C8.1, C9.1, R13.2, R21.1, U2.2 (OUT), U2.4 (OUT), U3.2 (3V3), U4.P$2 (3V3), U6.P$1 (VCC), U7.8 (VCC)
!IMU_RST: U3.8 (IO5), U4.P$6 (RST)
!RST: R13.1, U3.41 (EN)
ACAL_LED: R2.1, U3.19 (IO16)
ACT_LED: R14.1, U3.16 (IO13)
BATT_MON: R10.1, R12.2, U3.4 (IO1)
BOOT: C6.1, R6.2, U3.3 (IO0)
CC1: J1.A5 (CC1), R7.2
CC2: J1.B5 (CC2), R8.2
ESP_RX0: U3.37 (TXD0), U6.P$9 (TX)
ESP_TX0: U3.38 (RXD0), U6.P$10 (RX)
GCAL_LED: R3.1, U3.18 (IO15)
GND: C1.2, C2.2, C3.2, C4.2, C5.2, C6.2, C7.2, C8.2, C9.2, D1.C, D2.C, D3.C, D6.C, D7.C, D8.C, J1.A1_B12 (GND), J1.B1_A12 (GND), J1.S1 (SHELL_GND), J1.S2 (SHELL_GND), J1.S3 (SHELL_GND), J1.S4 (SHELL_GND), PAD2.1, R5.2, R7.1, R8.1, R12.1, R15.1, S1.1, S2.1, S2.4 (1), S2.5, S3.1, S3.4 (1), S3.5, S4.1, S4.4 (1), S4.5, U2.1 (ADJ/GND), U3.1 (GND), U3.26 (GND), U3.42 (GND), U3.43.1 (GND), U3.43.2 (GND), U3.43.3 (GND), U3.43.4 (GND), U3.43.5 (GND), U3.43.6 (GND), U3.43.7 (GND), U3.43.8 (GND), U3.43.9 (GND), U3.43.10 (GND), U3.43.11 (GND), U3.43.12 (GND), U3.43.13 (GND), U3.43.14 (GND), U3.43.15 (GND), U3.43.16 (GND), U3.43.17 (GND), U3.43.18 (GND), U3.43.19 (GND), U3.43.20 (GND), U3.43.21 (GND), U4.P$3 (GND), U5.2 (VSS), U6.P$3 (GND), U6.P$8 (GND), U6.P$12 (GND), U6.P$19 (GND), U7.4 (VSS)
GPS_FIX: R20.2, U3.35 (IO41), U6.P$5 (3D-FIX)
GPS_PPS: U3.36 (IO42), U6.P$13 (1PPS)
LOG_EN: C7.1, R9.2, U3.15 (IO12)
MCAL_LED: R11.1, U3.17 (IO14)
MISO: U3.31 (IO37), U7.6 (MISO/SD0)
MOSI: U3.29 (IO35), U7.5 (MOSI/CMD)
unnamed: D7.A, R20.1
unnamed: D8.A, R14.2
unnamed: R1.1, S2.2 (3), S2.3
unnamed: Q2.3 (D), U2.3 (IN)
unnamed: R6.1, S3.2 (3), S3.3
unnamed: D1.A, R3.2
unnamed: Q2.1 (G), R16.1, S1.2
unnamed: R9.1, S4.2 (3), S4.3
unnamed: D2.A, R2.2
unnamed: D4.3 (C), Q1.3 (D), Q2.2 (S), R16.2
unnamed: D3.A, R11.2
unnamed: D5.A, R4.2
unnamed: D5.C, U5.1 (STAT)
unnamed: R5.1, U5.5 (PROG)
unnamed: D6.A, R21.2
RST: C3.1, R1.2
SCK: U3.30 (IO36), U7.3 (SCK)
SCL: U3.27 (IO33), U4.P$5 (SCL)
SDA: U3.25 (IO26), U4.P$4 (SDA)
SD_CS: U3.28 (IO34), U7.2 (SSEL/SD3)
USB_DN: J1.A7 (DN1), J1.B7 (DN2), U3.22 (IO19)
USB_DP: J1.A6 (DP1), J1.B6 (DP2), U3.23 (IO20)
VCC: U4.P$1 (VCC)
V_BATT: C5.1, PAD1.1, Q1.2 (S), R10.2, U5.3 (VBAT)
V_USB: C1.1, C2.1, D4.1 (A), J1.A4_B9 (VBUS), J1.B4_A9 (VBUS), Q1.1 (G), R4.1, R15.2, U5.4 (VDD)

Notes on the sheet:
10K = 100mA
5.0K = 200mA
2.0K = 500mA
1.0K = 1000mA
LiPoly Charger
3V3 Regulator
Peripherals
Diagnostic LEDs
ESP32-S2-WROOM
GPS Radio
Dynamic VIN selection: VBUS (USB) will override VBAT (LIPO) via D4 when both are present. When USB is present, Q1 is closed, cutting battery power. S1 controls Q2's output which allows both power sources into U2
IMU
SMT SD Card
USB-C Connector
Input buttons with low-pass DC filters. The RC circuit debounces the button press, making interrupts more accurate. The debounce time is determined by t = R*C For this case, t = 10000*0.000001 = 10 ms
User Buttons
Application note: LOG_EN should be tied to a flag to enable/disable logging. This can be done by using an interrrupt in the firmware. The input must use a PULLUP resistor as the button is a current sink.

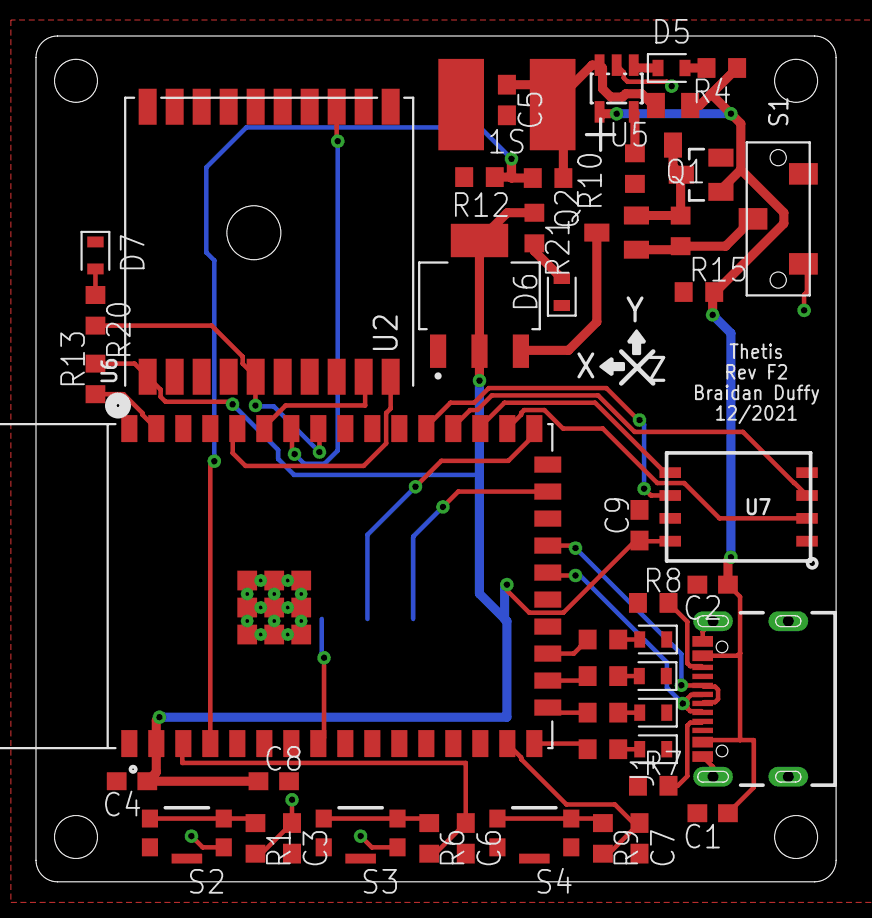
[picture p26: board Thetis_RevF2_PCB.brd from above]

Board: 2 copper layers, 44.4 x 47.0 mm, 50 parts (1 on the bottom side), 43 nets.
