Legohead259/Thetis-CAD/ECAD/Rev D1/Thetis_RevD1_PCB.brd

## EAGLE design ECAD/Rev D1/Thetis_RevD1_PCB.brd (2022-02-04)

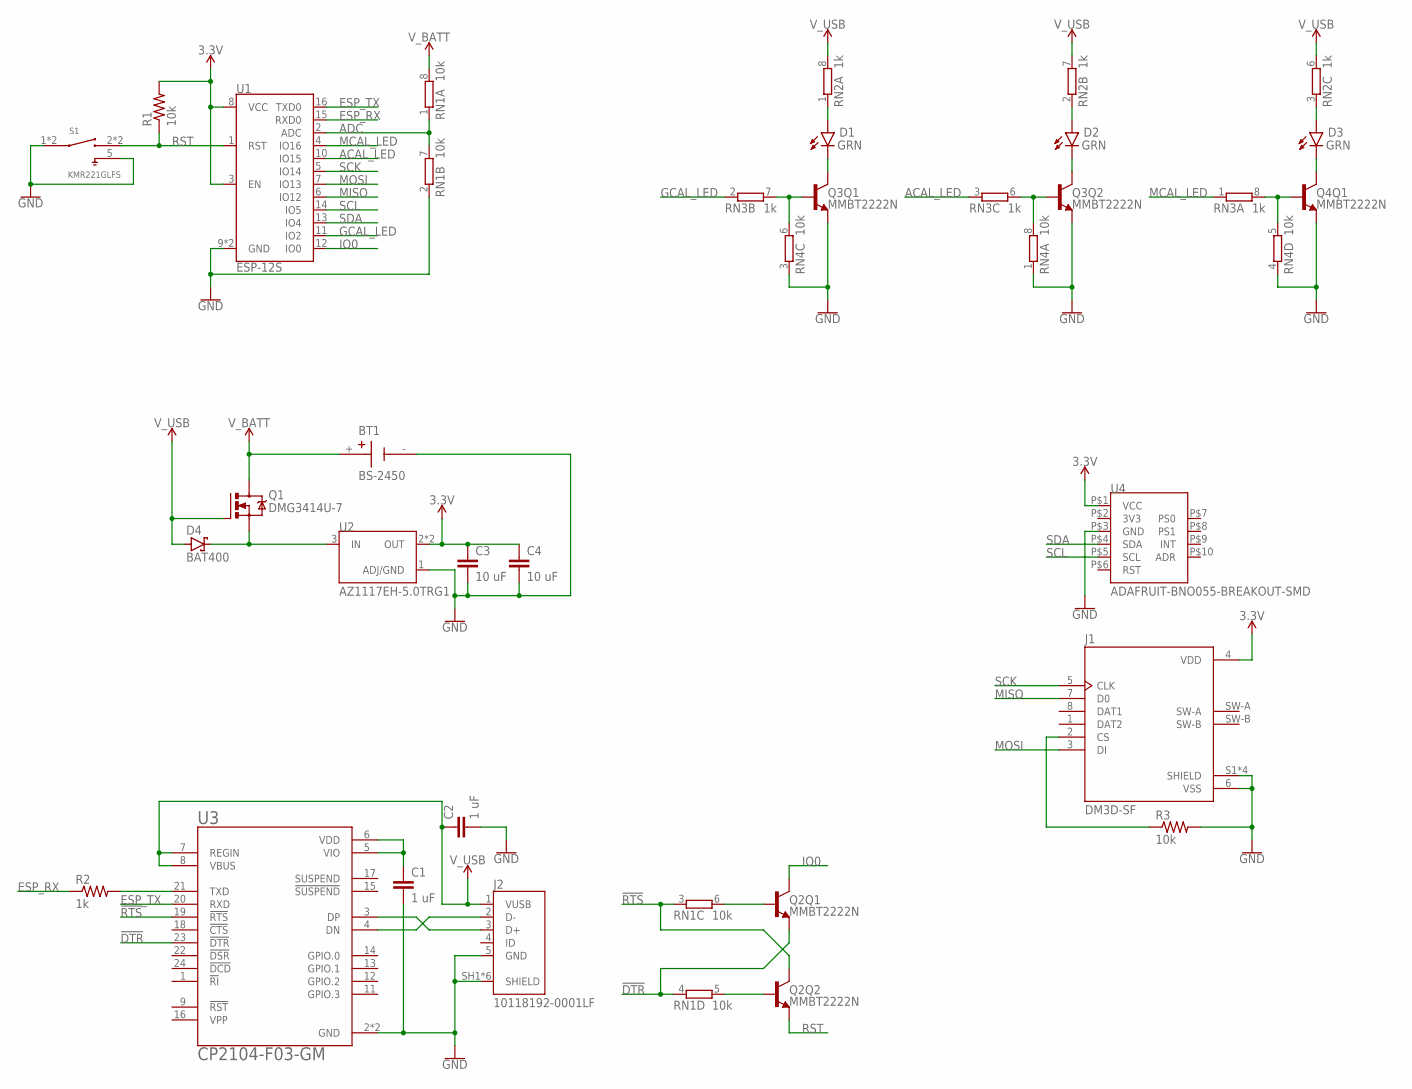
[picture p27: schematic Thetis_RevD1_SCH.sch]

Parts:
BT1: BS-2450; BAT_BS-2450
C1, C2: 1 uF; C0603
C3, C4: 10 uF; C0603
D1, D2, D3: GRN; LEDC1608X65N
D4: BAT400; SOT23
J1: DM3D-SF; HRS_DM3D-SF
J2: 10118192-0001LF; AMPHENOL_10118192-0001LF
Q1: DMG3414U-7; SOT23
Q2, Q3, Q4: MMBT2222N; SC70-6
R1, R3: 10k; R0603
R2: 1k; R0603
RN1, RN4: 10k; EXB28V
RN2, RN3: 1k; EXB28V
S1: KMR221GLFS; SW_KMR221GLFS
U1: ESP-12S
U2: AZ1117EH-5.0TRG1; SOT230P700X180-4N
U3: CP2104-F03-GM; QFN50P400X400X80-25N
U4: ADAFRUIT-BNO055-BREAKOUT-SMD

Connections:
3.3V: C3.1, C4.1, J1.4 (VDD), R1.2, U1.3 (EN), U1.8 (VCC), U2.2 (OUT), U2.4 (OUT), U4.P$1 (VCC)
3V3: U4.P$2 (3V3)
!DTR: Q2.4 (E), RN1.4 (1), U3.23 (!DTR)
!RTS: Q2.6 (C), RN1.3 (1), U3.19 (!RTS)
ACAL_LED: RN3.3 (1), U1.10 (IO15)
ADC: RN1.1, RN1.7 (2), U1.2 (ADC)
ESP_RX: R2.1, U1.15 (RXD0)
ESP_TX: U1.16 (TXD0), U3.20 (RXD)
GCAL_LED: RN3.2 (1), U1.11 (IO2)
GND: BT1.-, C1.2, C2.2, C3.2, C4.2, J1.6 (VSS), J1.S1 (SHIELD), J1.S2 (SHIELD), J1.S3 (SHIELD), J1.S4 (SHIELD), J2.5 (GND), J2.SH1 (SHIELD), J2.SH2 (SHIELD), J2.SH3 (SHIELD), J2.SH4 (SHIELD), J2.SH5 (SHIELD), J2.SH6 (SHIELD), Q3.1 (E), Q3.4 (E), Q4.4 (E), R3.2, RN1.2 (1), RN4.1, RN4.3 (1), RN4.4 (1), S1.1, S1.4 (1), S1.5, U1.9 (GND), U1.P$1 (GND), U2.1 (ADJ/GND), U3.2 (GND), U3.25 (GND), U4.P$3 (GND)
IO0: Q2.3 (C), U1.12 (IO0)
MCAL_LED: RN3.1, U1.4 (IO16)
MISO: J1.7 (D0), U1.6 (IO12)
MOSI: J1.3 (DI), U1.7 (IO13)
unnamed: J1.2 (CS), R3.1
unnamed: C1.1, U3.5 (VIO), U3.6 (VDD)
unnamed: R2.2, U3.21 (TXD)
unnamed: J2.3 (D+), U3.3 (DP)
unnamed: J2.2 (D-), U3.4 (DN)
unnamed: Q3.5 (B), RN3.7 (2), RN4.6 (2)
unnamed: Q2.2 (B), RN1.5 (2)
unnamed: D1.C, Q3.3 (C)
unnamed: Q2.5 (B), RN1.6 (2)
unnamed: D1.A, RN2.1
unnamed: D2.A, RN2.2 (1)
unnamed: D2.C, Q3.6 (C)
unnamed: D4.3 (C), Q1.2 (S), U2.3 (IN)
unnamed: Q3.2 (B), RN3.6 (2), RN4.8 (2)
unnamed: Q4.5 (B), RN3.8 (2), RN4.5 (2)
unnamed: D3.C, Q4.3 (C)
unnamed: D3.A, RN2.3 (1)
RST: Q2.1 (E), R1.1, S1.2 (3), S1.3, U1.1 (RST)
SCK: J1.5 (CLK), U1.5 (IO14)
SCL: U1.14 (IO5), U4.P$5 (SCL)
SDA: U1.13 (IO4), U4.P$4 (SDA)
V_BATT: BT1.+, Q1.3 (D), RN1.8 (2)
V_USB: C2.1, D4.1 (A), J2.1 (VUSB), Q1.1 (G), RN2.6 (2), RN2.7 (2), RN2.8 (2), U3.7 (REGIN), U3.8 (VBUS)

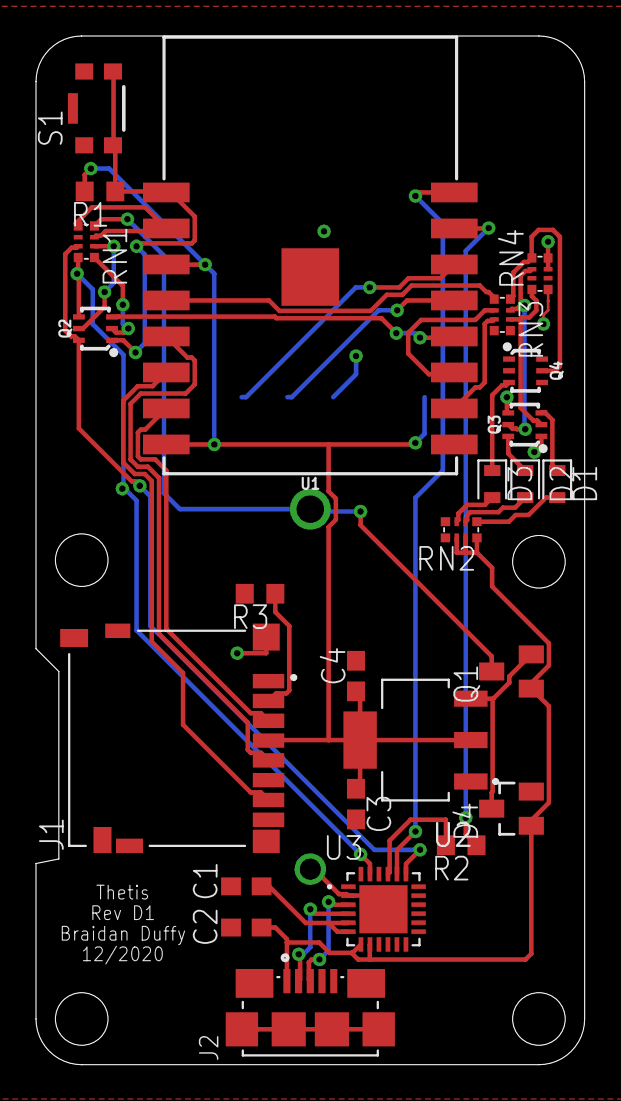
[picture p28: board Thetis_RevD1_PCB.brd from above]

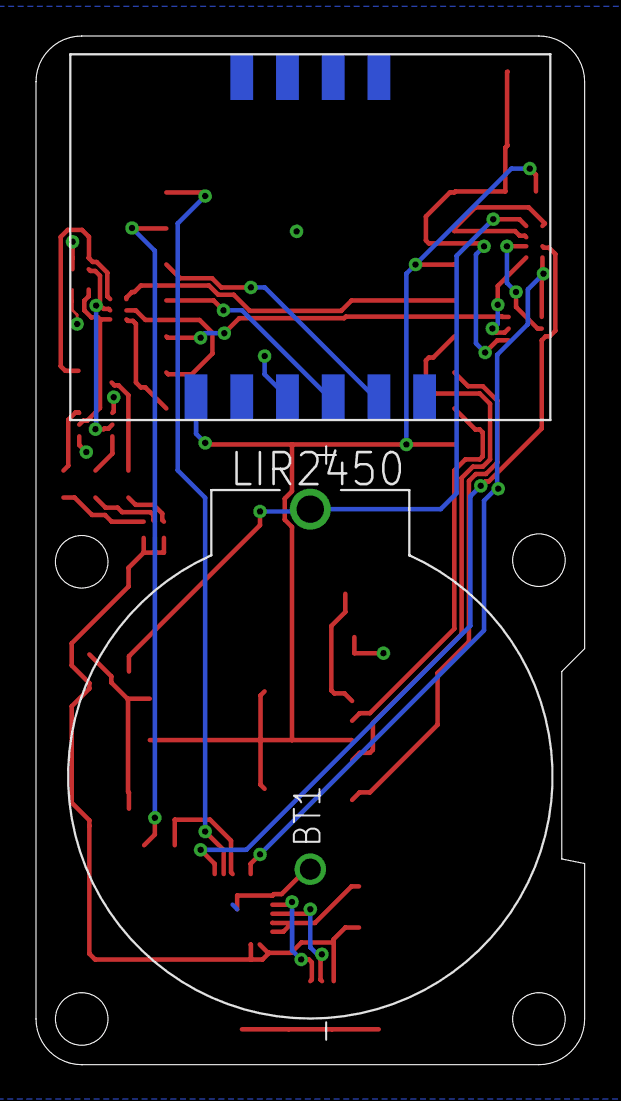
[picture p29: board Thetis_RevD1_PCB.brd from below]

Board: 2 copper layers, 30.5 x 57.1 mm, 27 parts (2 on the bottom side), 36 nets.
