Legohead259/Thetis-CAD/ECAD/Rev F1/Thetis_RevF1_PCB.brd

## EAGLE design ECAD/Rev F1/Thetis_RevF1_PCB.brd (2022-02-04)

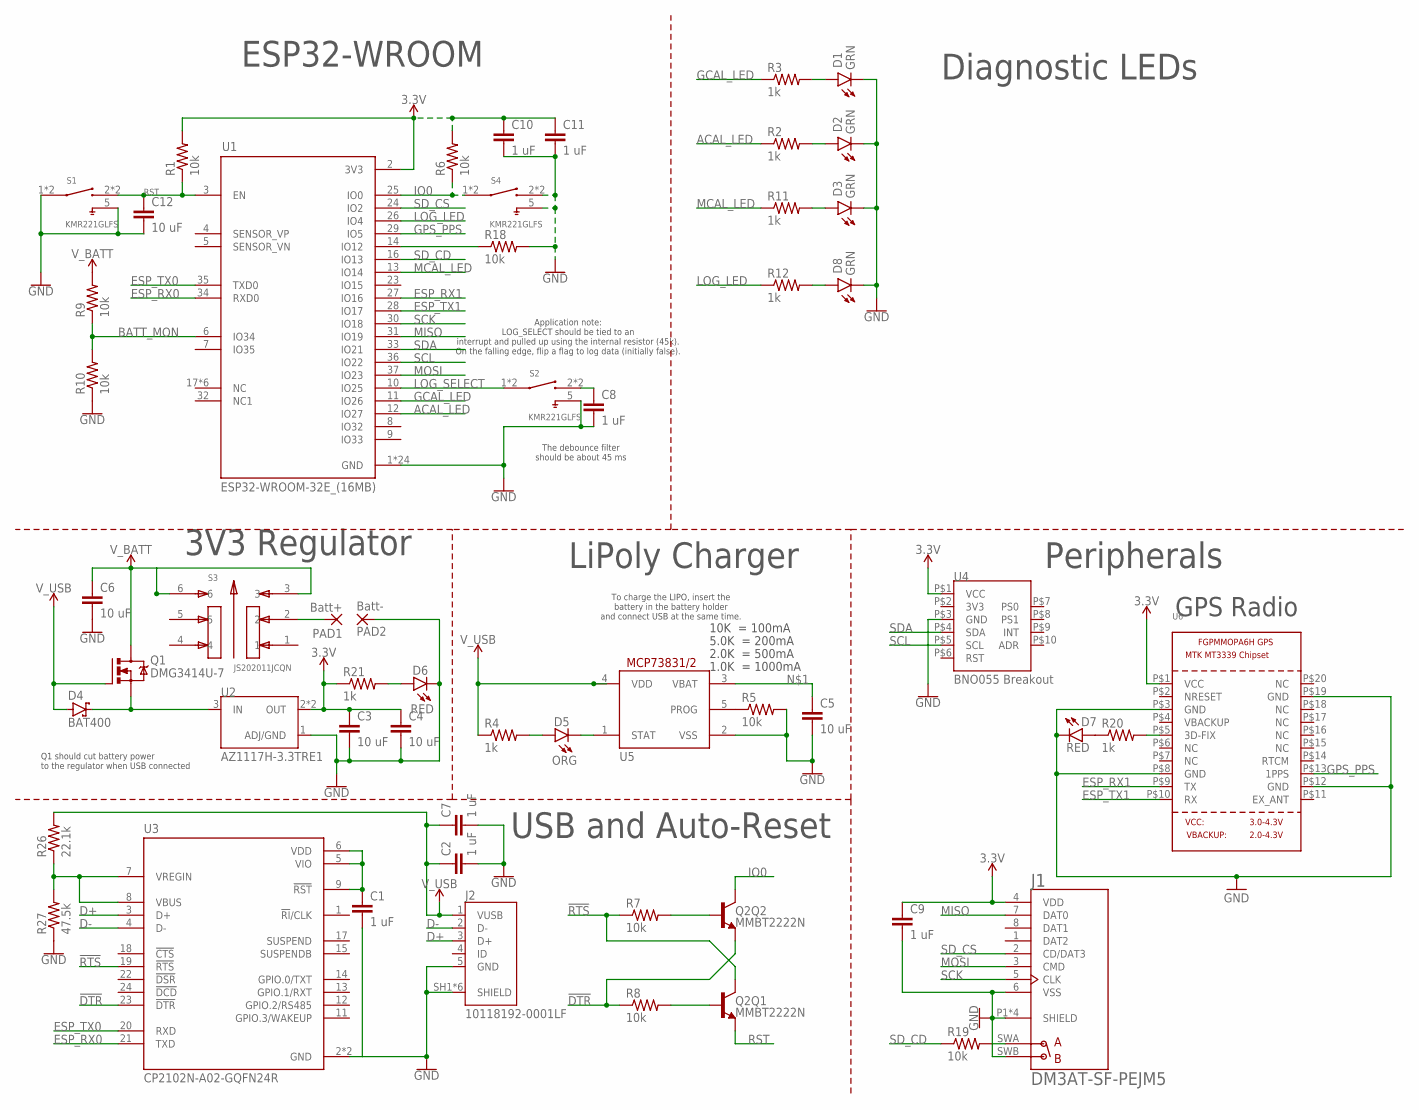
[picture p30: schematic Thetis_RevF1_SCH.sch]

Parts:
C1, C2, C7, C8, C9, C10, C11: 1 uF; C0603
C3, C4, C5, C6, C12: 10 uF; C0603
D1, D2, D3, D8: GRN; LEDC1608X65N
D4: BAT400; SOT23
D5: ORG; LEDC1608X65N
D6: RED; LEDC1608X65N
D7: RED; LEDC1608X35N
J1: DM3AT-SF-PEJM5; HRS_DM3AT-SF-PEJM5
J2: 10118192-0001LF; AMPHENOL_10118192-0001LF
PAD1: Batt+; SMD2,54-5,08
PAD2: Batt-; SMD2,54-5,08
Q1: DMG3414U-7; SOT23
Q2: MMBT2222N; SC70-6
R1, R5, R6, R7, R8, R9, R10, R18, R19: 10k; R0603
R2, R3, R4, R11, R12, R20, R21: 1k; R0603
R26: 22.1k; R0603
R27: 47.5k; R0603
S1, S2, S4: KMR221GLFS; SW_KMR221GLFS
S3: JS202011JCQN; SW_JS202011JCQN
U1: ESP32-WROOM-32E_(16MB); MODULE_ESP32-WROOM-32E_(16MB)
U2: AZ1117H-3.3TRE1; SOT230P700X180-4N
U3: CP2102N-A02-GQFN24R; QFN50P400X400X80-25N
U4: BNO055 Breakout; ADAFRUIT-BNO055-BREAKOUT-SMD
U5: MCP73831/OT; SOT23-5L
U6: GPS_FGPMMOPA6H; FGPMMOPA6H

Connections:
3.3V: C3.1, C4.1, C9.1, C10.1, C11.1, J1.4 (VDD), R1.2, R6.2, R21.1, U1.2 (3V3), U2.2 (OUT), U2.4 (OUT), U4.P$1 (VCC), U6.P$1 (VCC)
3V3: U4.P$2 (3V3)
!DTR: Q2.1 (E), R8.1, U3.23 (!DTR)
!RTS: Q2.3 (C), R7.1, U3.19 (!RTS)
ACAL_LED: R2.1, U1.12 (IO27)
BATT_MON: R9.1, R10.2, U1.6 (IO34)
D+: J2.3 (D+), U3.3 (D+)
D-: J2.2 (D-), U3.4 (D-)
ESP_RX0: U1.34 (RXD0), U3.21 (TXD)
ESP_RX1: U1.27 (IO16), U6.P$9 (TX)
ESP_TX0: U1.35 (TXD0), U3.20 (RXD)
ESP_TX1: U1.28 (IO17), U6.P$10 (RX)
GCAL_LED: R3.1, U1.11 (IO26)
GND: C1.2, C2.2, C3.2, C4.2, C5.2, C6.2, C7.2, C8.2, C9.2, C10.2, C11.2, C12.2, D1.C, D2.C, D3.C, D6.C, D7.C, D8.C, J1.6 (VSS), J1.P1 (SHIELD), J1.P2 (SHIELD), J1.P3 (SHIELD), J1.P4 (SHIELD), J1.SWB (B), J2.5 (GND), J2.SH1 (SHIELD), J2.SH2 (SHIELD), J2.SH3 (SHIELD), J2.SH4 (SHIELD), J2.SH5 (SHIELD), J2.SH6 (SHIELD), PAD2.1, R5.2, R10.1, R18.2, R27.1, S1.1, S1.4 (1), S1.5, S2.5, S4.2 (3), S4.3, S4.5, U1.1 (GND), U1.15 (GND), U1.38 (GND), U1.39_1 (GND), U1.39_2 (GND), U1.39_3 (GND), U1.39_4 (GND), U1.39_5 (GND), U1.39_6 (GND), U1.39_7 (GND), U1.39_8 (GND), U1.39_9 (GND), U1.39_10 (GND), U1.39_11 (GND), U1.39_12 (GND), U1.39_13 (GND), U1.39_14 (GND), U1.39_15 (GND), U1.39_16 (GND), U1.39_17 (GND), U1.39_18 (GND), U1.39_19 (GND), U1.39_20 (GND), U1.39_21 (GND), U2.1 (ADJ/GND), U3.2 (GND), U3.25 (GND), U4.P$3 (GND), U5.2 (VSS), U6.P$3 (GND), U6.P$8 (GND), U6.P$12 (GND), U6.P$19 (GND)
GPS_PPS: U1.29 (IO5), U6.P$13 (1PPS)
IO0: Q2.6 (C), R6.1, S4.1, S4.4 (1), U1.25 (IO0)
LOG_LED: R12.1, U1.26 (IO4)
LOG_SELECT: S2.1, S2.4 (1), U1.10 (IO25)
MCAL_LED: R11.1, U1.13 (IO14)
MISO: J1.7 (DAT0), U1.31 (IO19)
MOSI: J1.3 (CMD), U1.37 (IO23)
unnamed: C5.1, PAD1.1, S3.2, U5.3 (VBAT)
unnamed: D7.A, R20.1
unnamed: R20.2, U6.P$5 (3D-FIX)
unnamed: R18.1, U1.14 (IO12)
unnamed: Q2.5 (B), R8.2
unnamed: D1.A, R3.2
unnamed: Q2.2 (B), R7.2
unnamed: C8.1, S2.2 (3), S2.3
unnamed: D2.A, R2.2
unnamed: D4.3 (C), Q1.2 (S), U2.3 (IN)
unnamed: D3.A, R11.2
unnamed: D8.A, R12.2
unnamed: C1.1, U3.5 (VIO), U3.6 (VDD), U3.9 (!RST)
unnamed: R26.1, R27.2, U3.7 (VREGIN), U3.8 (VBUS)
unnamed: D5.A, R4.2
unnamed: D5.C, U5.1 (STAT)
unnamed: R5.1, U5.5 (PROG)
unnamed: J1.SWA (A), R19.2
unnamed: D6.A, R21.2
RST: C12.1, Q2.4 (E), R1.1, S1.2 (3), S1.3, U1.3 (EN)
SCK: J1.5 (CLK), U1.30 (IO18)
SCL: U1.36 (IO22), U4.P$5 (SCL)
SDA: U1.33 (IO21), U4.P$4 (SDA)
SD_CD: R19.1, U1.16 (IO13)
SD_CS: J1.2 (CD/DAT3), U1.24 (IO2)
V_BATT: C6.1, Q1.3 (D), R9.2, S3.3, S3.6
V_USB: C2.1, C7.1, D4.1 (A), J2.1 (VUSB), Q1.1 (G), R4.1, R26.2, U5.4 (VDD)

Notes on the sheet:
10K = 100mA
5.0K = 200mA
2.0K = 500mA
1.0K = 1000mA
To charge the LIPO, insert the battery in the battery holder and connect USB at the same time.
LiPoly Charger
USB and Auto-Reset
3V3 Regulator
Q1 should cut battery power to the regulator when USB connected
Peripherals
Diagnostic LEDs
ESP32-WROOM
GPS Radio
Application note: LOG_SELECT should be tied to an interrupt and pulled up using the internal resistor (45k). On the falling edge, flip a flag to log data (initially false).
The debounce filter should be about 45 ms

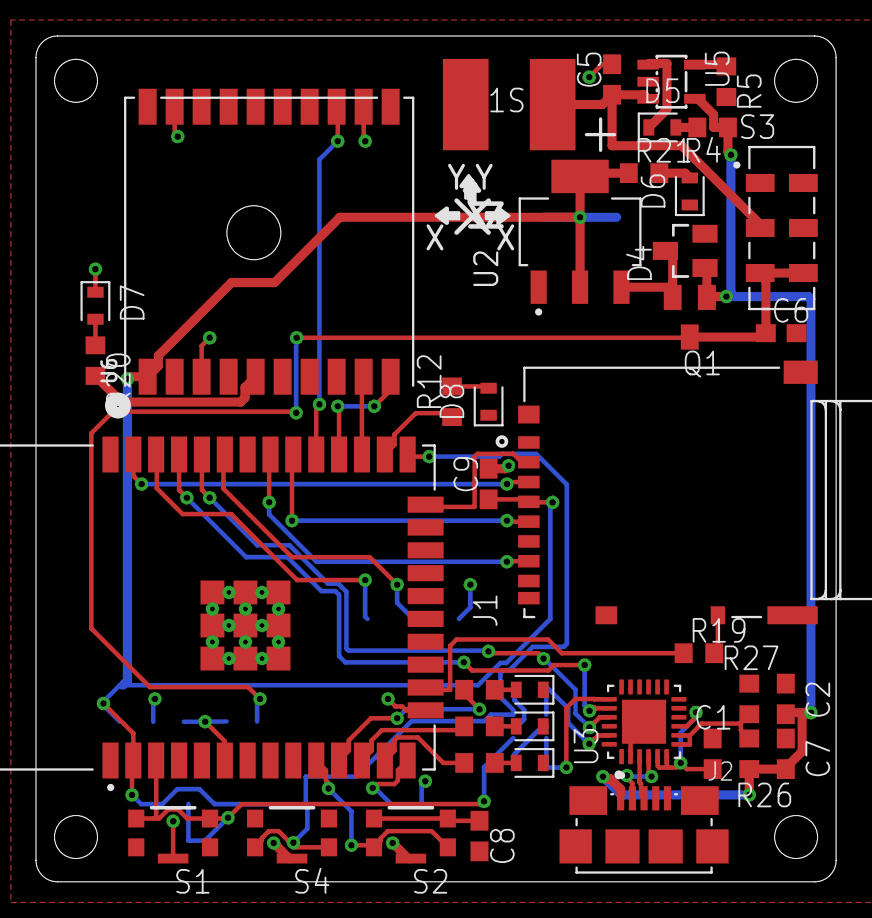
[picture p31: board Thetis_RevF1_PCB.brd from above]

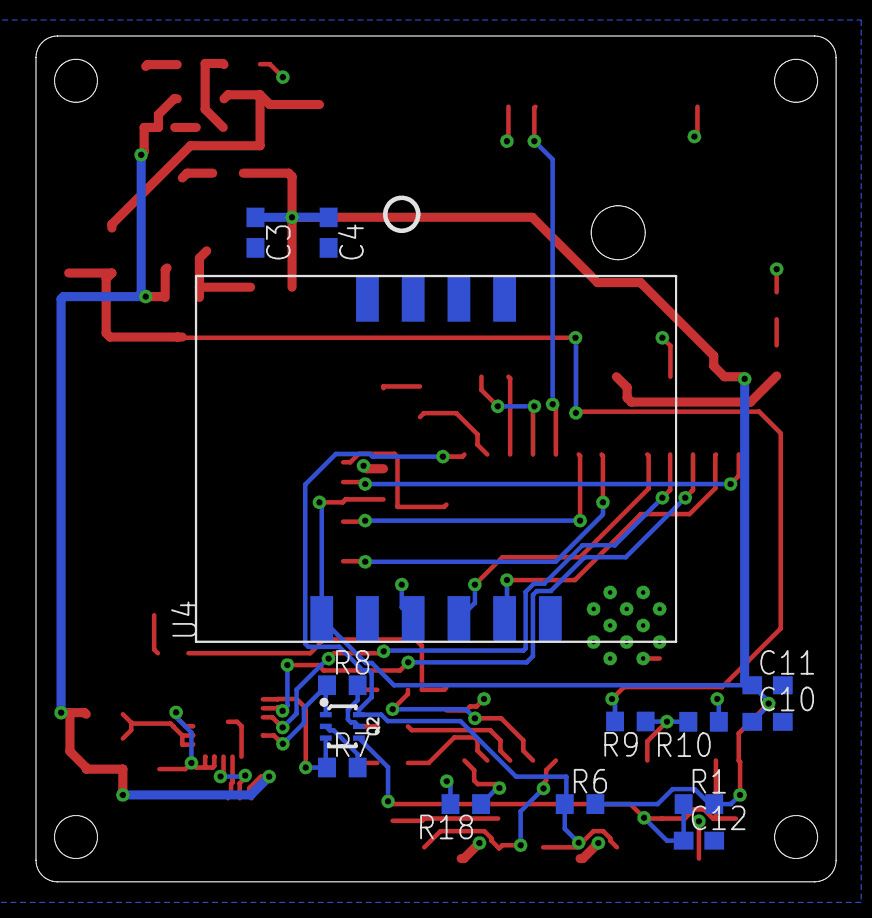
[picture p32: board Thetis_RevF1_PCB.brd from below]

Board: 2 copper layers, 44.5 x 47.0 mm, 54 parts (14 on the bottom side), 47 nets.
