Legohead259/Thetis-CAD/(commit log)

2022-02-04 Initial Commit Added CAD files and documentation
    [CL-SB-12A-12T.stp, Drop Test (x4) (0306_12).CSV, Drop Test (x4) (0306_12).xlsx, EnclosureTest.stl, RevF Layout - 1.dwg, RevF Layout.dwg, Thetis-RevA1-SCH.sch, Thetis_RevD1_PCB.brd]
2022-03-25 Added Rev F3 Schematic
2022-07-14 Added RevF4 Schematics
2022-07-14 Added RevF4 source files
    [Thetis_RevF4_PCB.brd, Thetis_RevF4_SCH v14.sch]
2022-10-26 Added some deployment data, changed nomenclature
    [Drop Test (x4) (0306_12).CSV, Drop Test (x4) (0306_12).xlsx, Thetis_Deployment_042722.csv]
2022-10-26 Restructured documentation to make it a bit easier to navigate
    [RevF Layout - 1.dwg, RevF Layout.dwg, Thetis System Requirements.xlsx, Thetis_RevF2_BOM.xlsx]
2022-10-26 Added Rev G1
    [Thetis_RevG1_PCB.brd, Thetis_RevG1_SCH.sch]
2022-10-26 Added Rev F4 gerber files
2022-10-26 Updated documentation files
    [CL-SB-12A-12T.stp, Thetis_RevF4_PCB.brd, Thetis_RevF4_SCH v14.sch, Thetis_RevF4_SCH.sch]
2023-01-11 Update refresh
    [Drop Test (x4) (0306_12).CSV, Drop Test (x4) (0306_12).xlsx, RevF Layout - 1.dwg, RevF Layout.dwg, Thetis System Requirements.xlsx, Thetis_Deployment_042722.csv, Thetis_RevF2_BOM.xlsx, Thetis_RevF5_PCB.brd]
2023-10-24 Added new schematic and board files
    [Thetis_RevF4_PCB.brd, Thetis_RevF4_SCH.sch, Thetis_RevF5_PCB.brd, Thetis_RevF5_SCH.sch, Thetis_RevG1_PCB.brd, Thetis_RevG1_SCH.sch, Thetis_RevG2_PCB v3.brd, Thetis_RevG2_SCH v1.sch]
2023-10-26 Added ECAD files Added BOMs for all boards Added F360 archives Added Gerber for RevF6
    [Thetis_RevD2_PCB.brd, Thetis_RevF6_PCB.brd, Thetis_RevF6_SCH.sch, Thetis_RevG2_PCB.brd, Thetis_RevG2_SCH.sch]
2023-10-26 Added PDFs of schematics
